TheComet/bat6/README.md

BAT6
========
FHNW Projekt 3 (Freivogel, Frey, Murray)
