TheComet/bat6/mechanical/housing/images/faceplate.tex

\documentclass{standalone}
\usepackage{tikz}
\usepackage{graphicx}

\begin{document}

\end{document}
