TheComet/bat6/pm/meeting-15-22-23.md

Topics
======
 + Mathematical model
    - Include temperature. It doesn't introduce any more complexity.
      --> Reto: Run tests, see if possible.
    - Model cell arrays (series + parallel) and not just a single cell
      --> Ask coaches about this, how useful is it?
    - Use actual parameters from real manufacturers?
      --> 
    - Dynamically allocate cells on micro controller
 + Frontend
    - Convert array of points
    - Be able to model cell arrays
    - Plotting of the resulting kennlinie
    - Power calculations + plots
    - Upload model to hardware and store it there? --> EEPROM?
