TheComet/bat6/doc/presentation/main.tex

\documentclass{beamer}
%\usepackage[ngerman]{babel}
%\usetheme[background=dark]{m}                     % Use metropolis theme
%\usetheme{theme/beamerthemem}                     % Use metropolis theme
\usetheme{m}                     % Use metropolis theme

\title{BAT6}
\date{\today}
\author{Alexander Murray, Reto Freivogel, Raphael Frey}
\institute{FHNW Brugg-Windisch}

\begin{document}
  \maketitle

  \section{Basic Idea Behind BAT6}

  \begin{frame}{Why We Want BAT6}
      \begin{itemize}
          \item
              It's awesome!
          \item
              BAT5 is just not good enough.
      \end{itemize}
  \end{frame}

  \begin{frame}{Advantages of BAT6}
      \begin{itemize}
          \item
              Optimized gliding parameters compared to BAT5
          \item
              Ease of use
      \end{itemize}
  \end{frame}
\end{document}
