TheComet/bat6/doc/documentation/titlepage/titlepage.tex

\begin{titlepage}

    \maketitle
    \vspace{40mm}
    \begin{center}
        \Large{Solar Panel Emulator}%
    \end{center}

    \vspace{50mm}
    %\vspace{90mm}

    %\hspace{-20mm}
    \begin{tabular}{r|l}

        \textsc{\textbf{Degree Program}}
        & EIT\\
        [4mm]

        \textsc{\textbf{Module}}
        & Projekt 3 \\
        [4mm]

        \textsc{\textbf{Team}}
        & 2 \\
        [4mm]

        \textsc{\textbf{Sponsor}}
        & Hanspeter Gysin \\
        [4mm]

        \textsc{\textbf{Coaches}}
        & Hanspeter Gysin, Peter Ganzmann, Matthias Meier,\\
        & Anita Gertiser, Bonnie Domenghino\\
        [4mm]

        %\textsc{\textbf{A}}
        %& Reto Freivogel, Alexander Murray, Raphael Frey\\
        %[4mm]

        \textsc{\textbf{Version}}
        & \code{1} \\
    \end{tabular}
    %\end{center}

\end{titlepage}
