TheComet/bat6/pm/reality-check/reality-check.odp

## Our Anuses are about to get fucked

## Reality Check

- Regulator is fucked
- Implementation of PV model seems to be nowhere
  - Driver exists but cannot be tested
  - API not implemented at all
- Front-End still nowhere
- UART still nowhere
- No menu
- LCD driver still nowhere
- Housing incomplete
- Documentation in chaos
- Presentation not even started yet
- No sign of anything remotely related to verification
- Project management has generally been terrible and chaotic

## Dependencies

HW Regulator

HW Regulator

OLED Driver

Buck Driver

Buck Driver

Menu

PV Model

PV Model

Test/Verification

UART

Front-End

Presentation

Documentation

## Option 1 Fix Buck

## Option 2 Make it presentable

- No idea what the problem is, we only have hunches
- Takes 2 weeks
- Hope it works.
- If it doesn't, we'll be back where we are now
- Focus on what we know works
- Make a working menu
- Make a working Front-End
- Focus on documentation and why our regulator failed.
- Focus on a good presentation

## Why are we where we are now?

- Little to no communication between group members
- Insufficient leadership
- No roadmap
- Lack of motivation
- Lack of invested time into the project
- Irrelevant “Wunschziele”

## Individual Feedback

## We need a roadmap

OLED Driver

Documentation

UART

Menu

Presentation

Front-End

Test/Verification
