TheComet/bat6/pm/pflichtenheft/grob-blockdiagramm.odp

Banana Plugs

Polarity Protection

(6A05-T)

230V Input

USB micro B

JTAG

~700mA

Fuse

FT232RQ

UVLO

< 25V

On/Off

Switch

Isolator

1.5V

Vref

Filters

Isolated

Converter

36V

dsPIC33F

Buck

(LT3741)

Diff. Current

Measurement

Voltage

Measurement

Buck

5V

Linear

3.3V

LCD

Display

LEDs

Push/Twist

Button
