TheComet/bat6/doc/presentation/libreoffice/presentation.odp

## BAT6

## Welcome Raphael Frey

## Model and Regulation Reto Freivogel

## Our Model (Temperature)

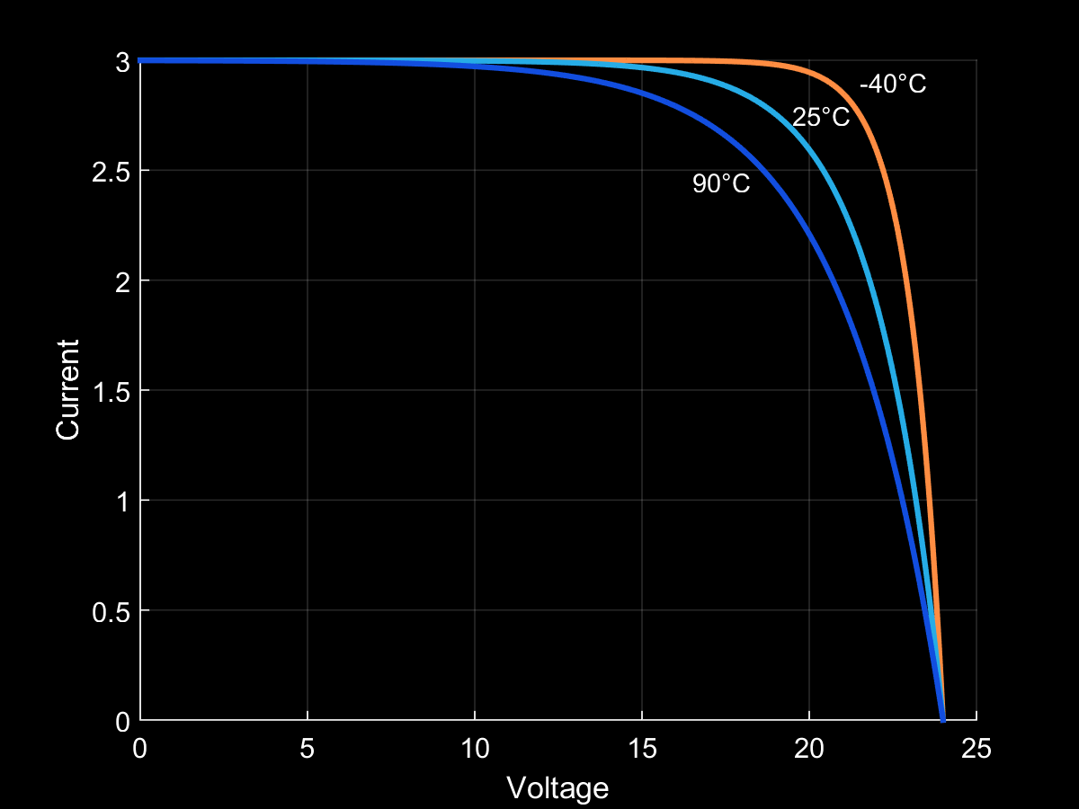
[picture p11: figure]
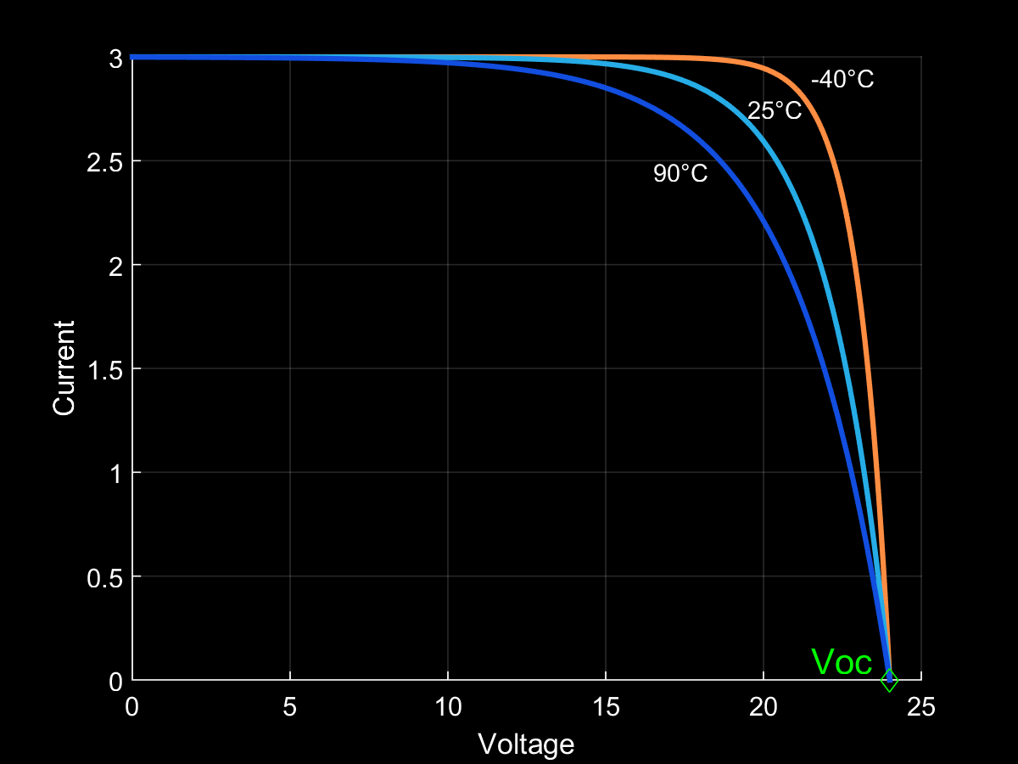
[picture p12: figure]
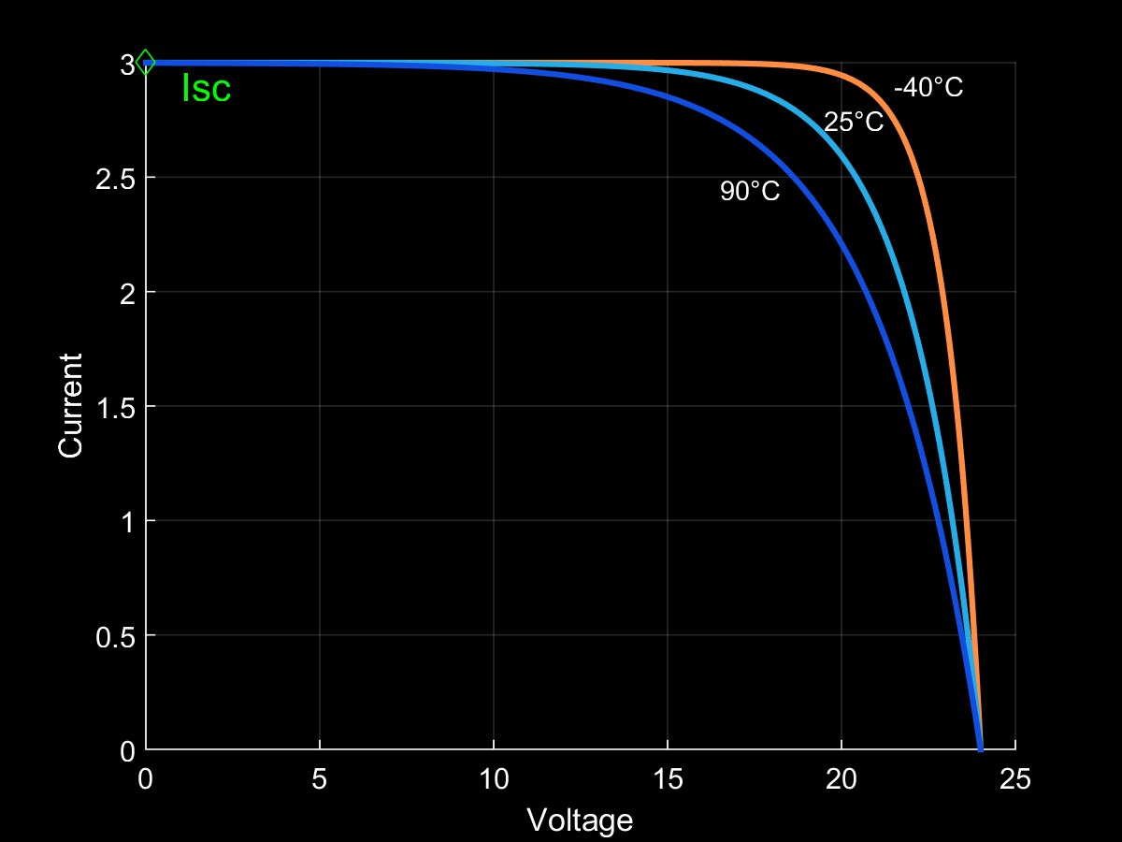
[picture p13: figure]

## Our Model (Irradiation)

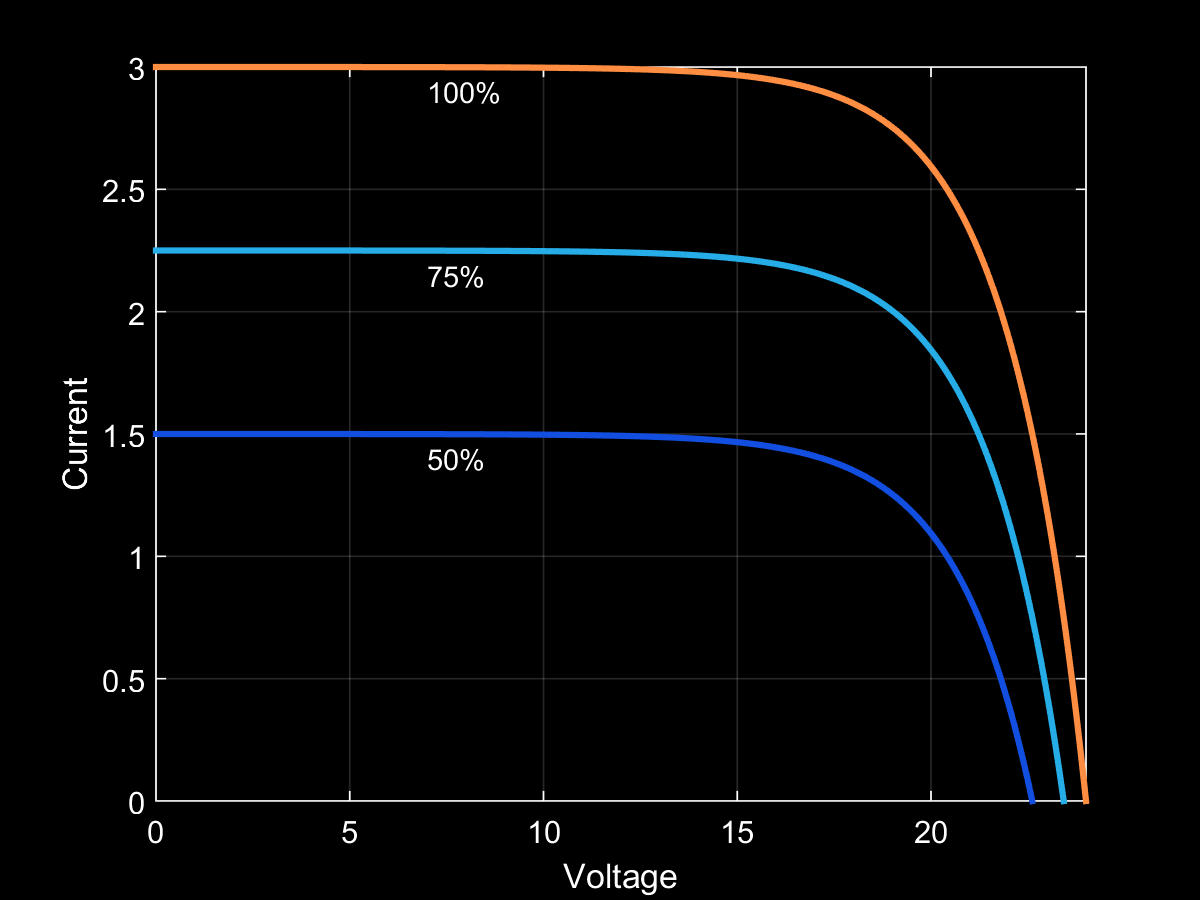
[picture p14: figure]

## Regulation Algorithm

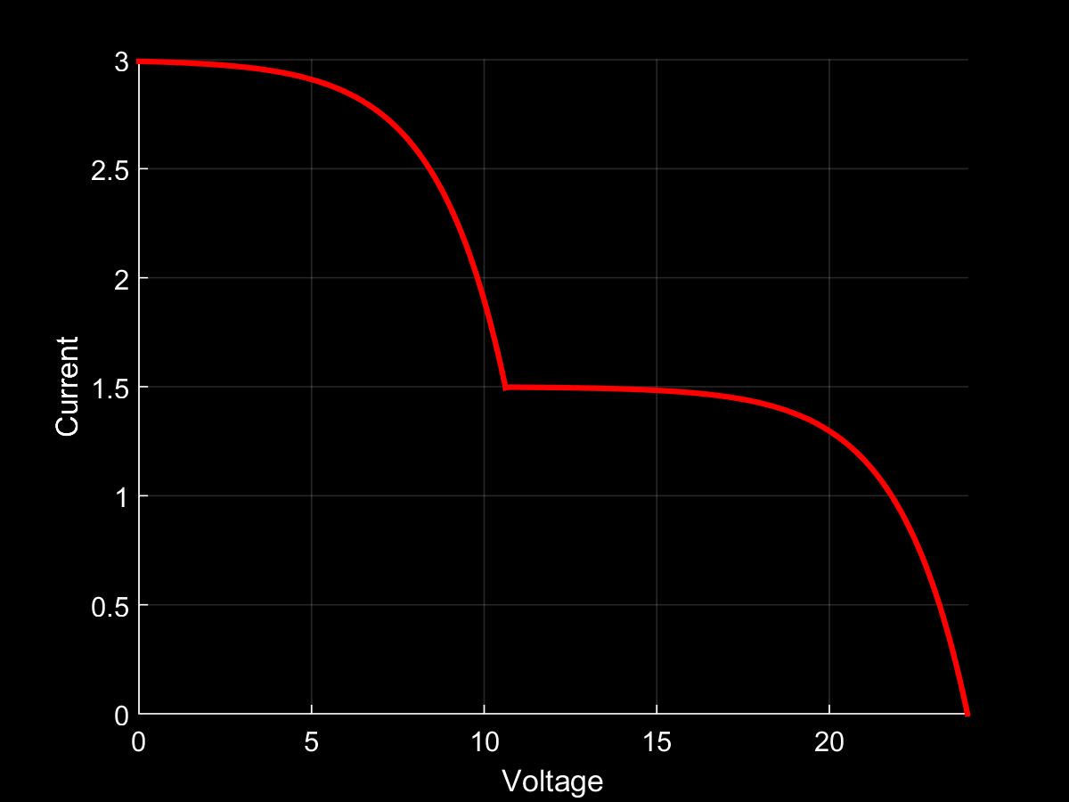
[picture p15: figure]
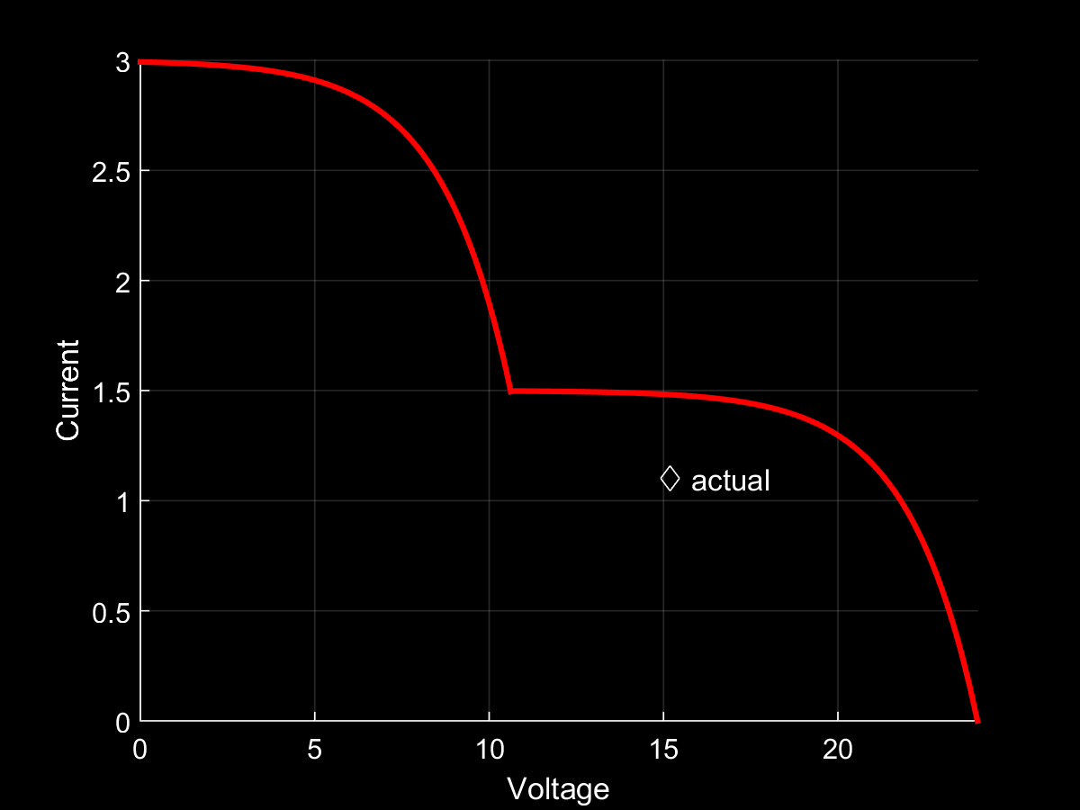
[picture p16: figure]
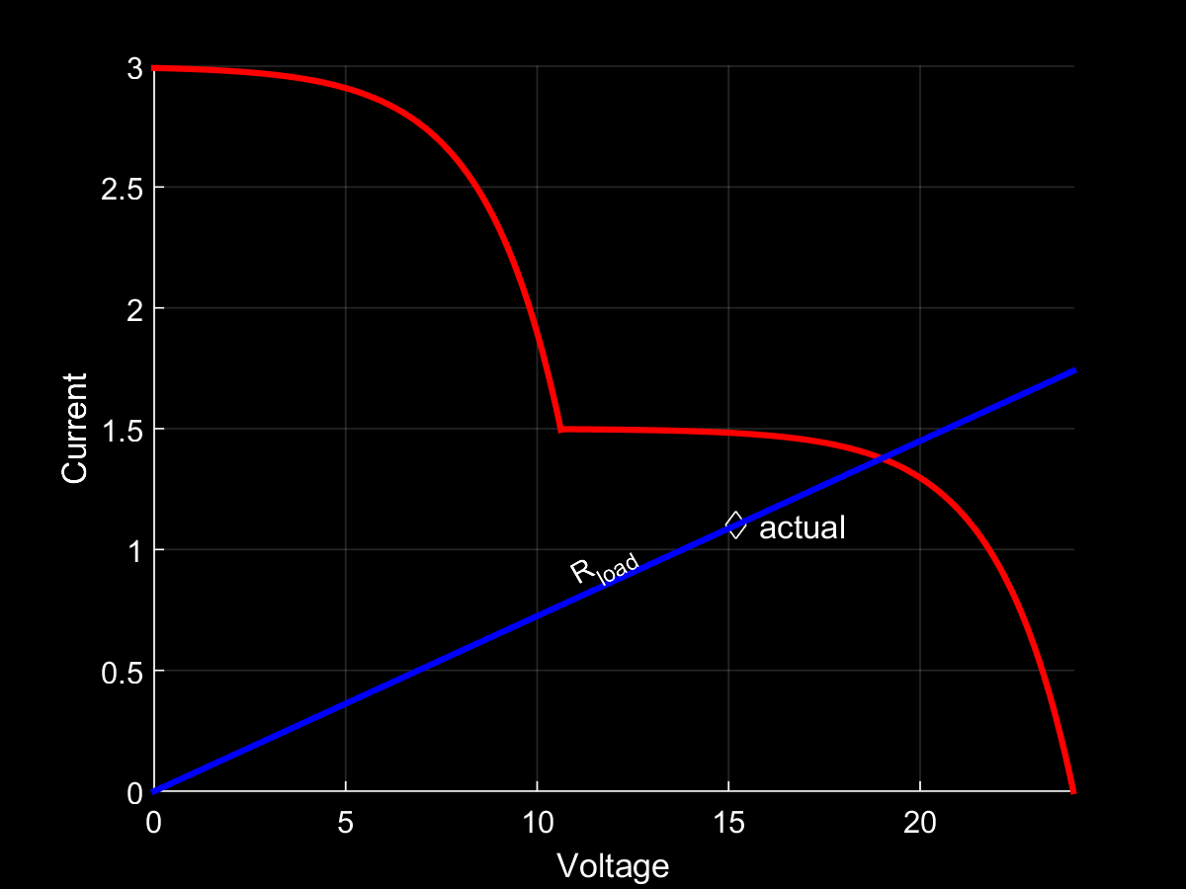
[picture p17: figure]
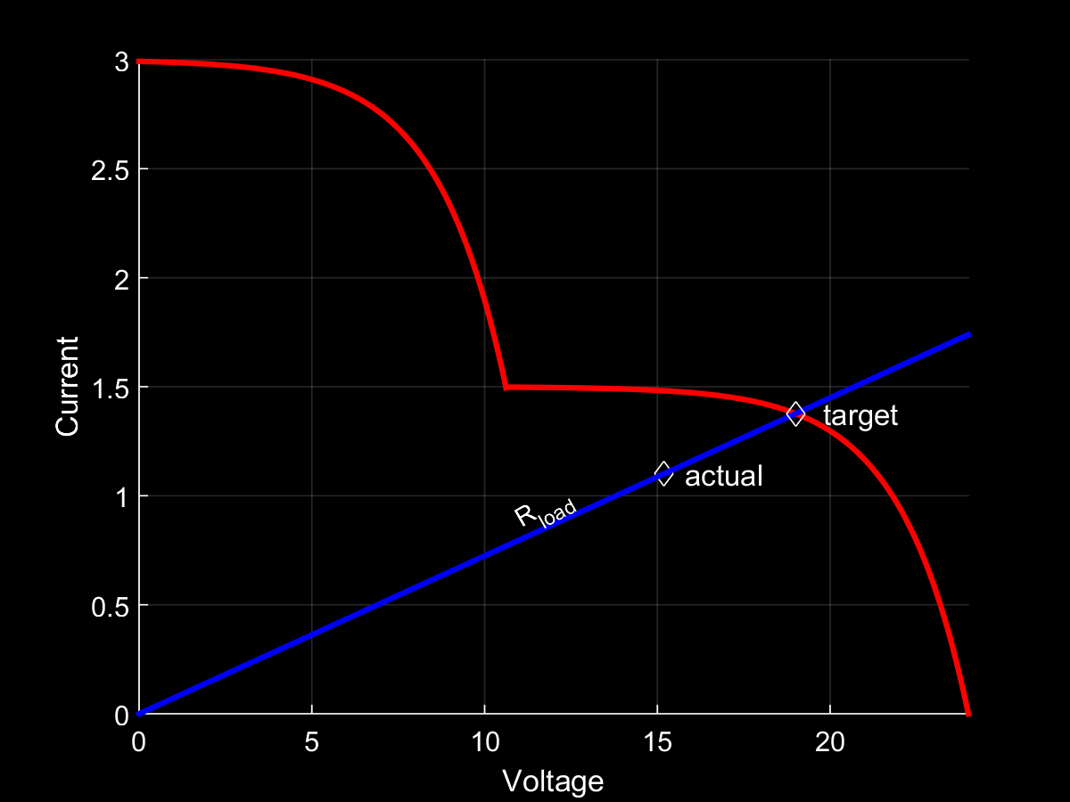
[picture p18: figure]

## Hardware Implementation

Set Voltage

Measure Current

Set Current

Measure Voltage

1.5V

Vref

dsPIC33

DAC

ADC

ADC

DAC

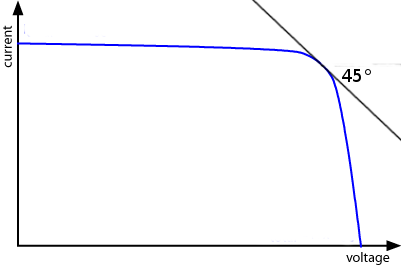
[picture p19: figure]
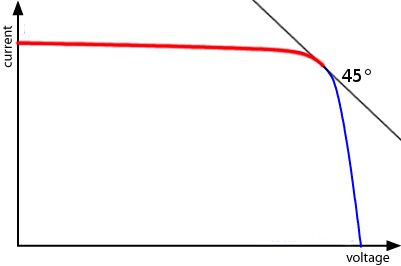
[picture p20: figure]
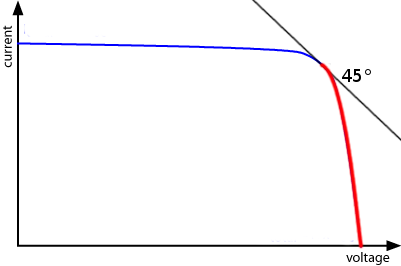
[picture p21: figure]

Buck

(LT3741)

Notes: → the main parts of the regulation → Measure V + I at all times → If we take a look at a typical IV curve we see there is a part where the voltage is relatively constant → Operate in constant voltage mode → or constant current → to improve accuracy

## Hardware Alex Murray

## Full Use of Today's Technologies

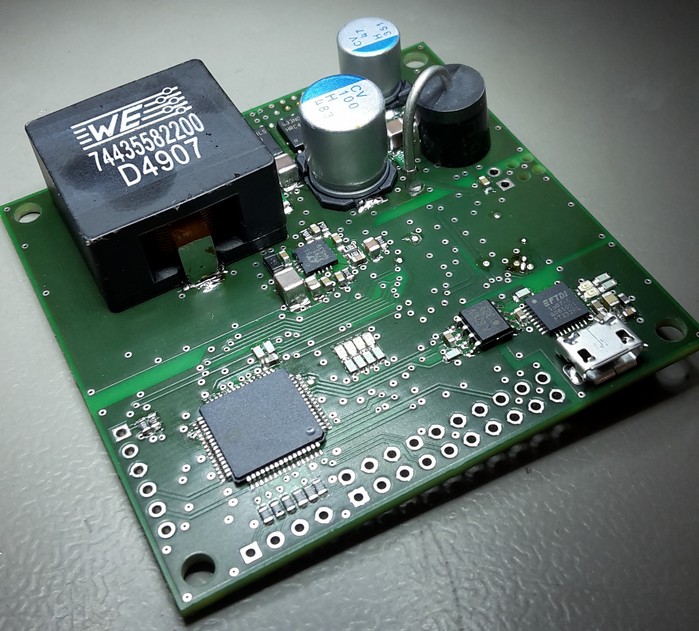
[picture p22: figure]
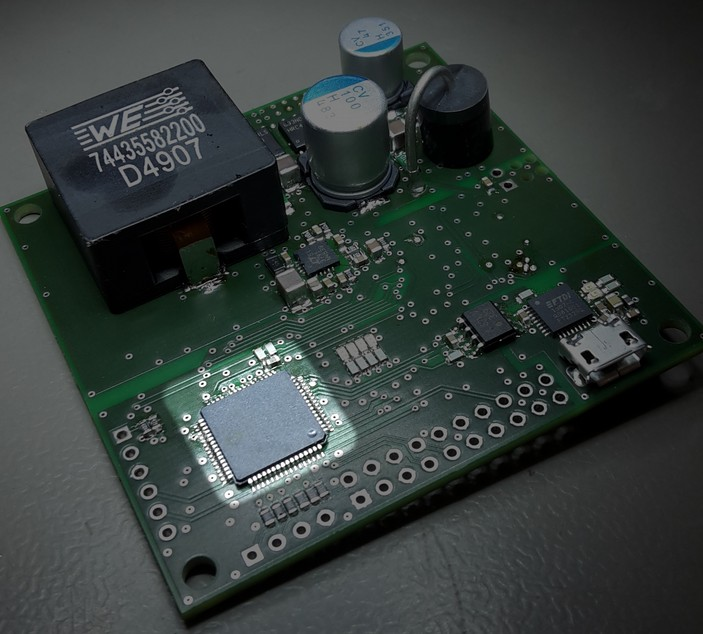
[picture p23: figure]
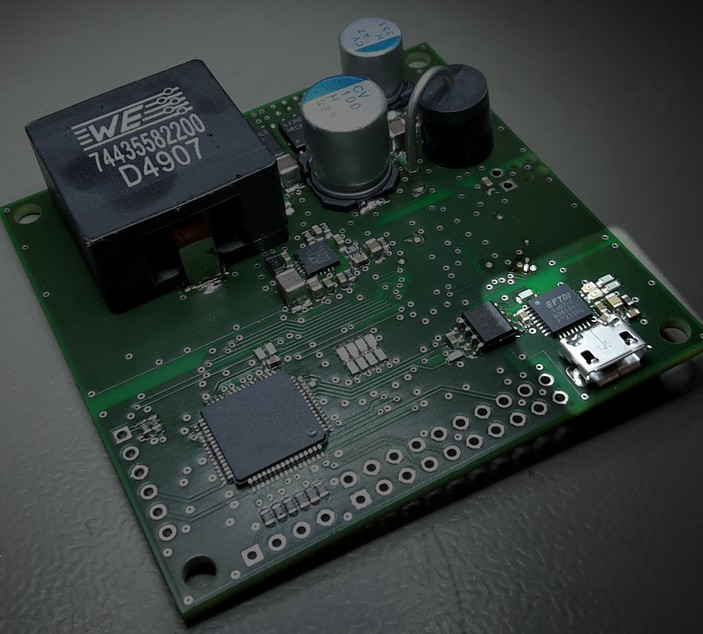
[picture p24: figure]
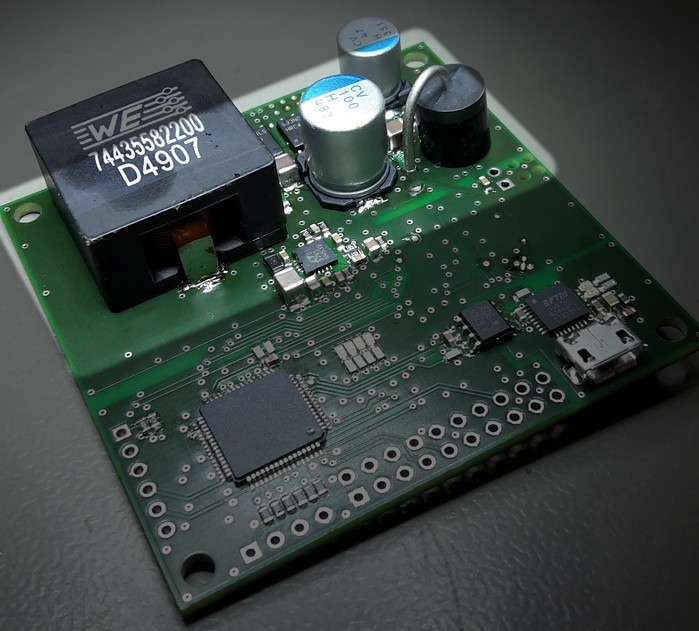
[picture p25: figure]
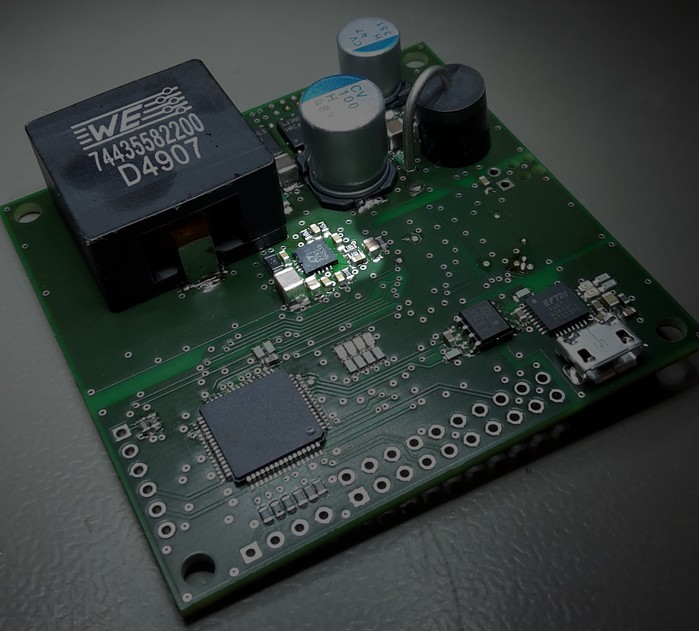
[picture p26: figure]

Notes: → Full use of modern fabrication technologies → As close as possible to behaviour of a possibly mass produced product → SMD, tiny ICs, QFN → Fabricated PCB → Reflow soldering to manufacture → (explain shit) → Unfortunately,

## The Issue

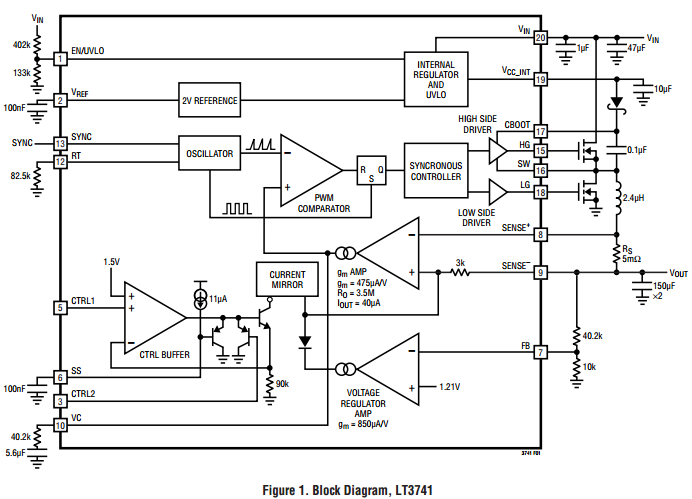
[picture p27: figure]
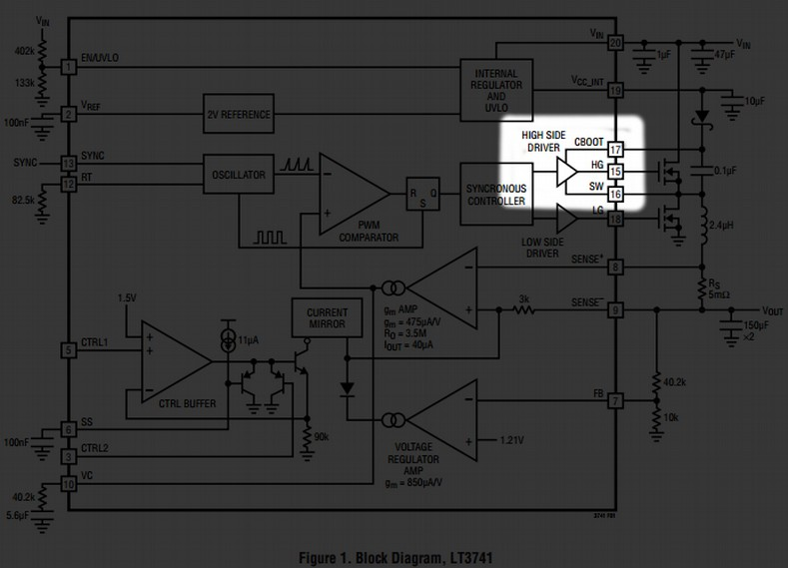
[picture p28: figure]

- MOSFETs are fine
- Inductor is fine
- No significant heat dissipation
- Transients?

Notes: → This is a block diagram of… → After lots of analysing and measuring… → concluded high side driver broken → This happened twice → replaced regulator, reduced voltage, same thing → (next slide)

## Trace Lengths Are Fairly Long

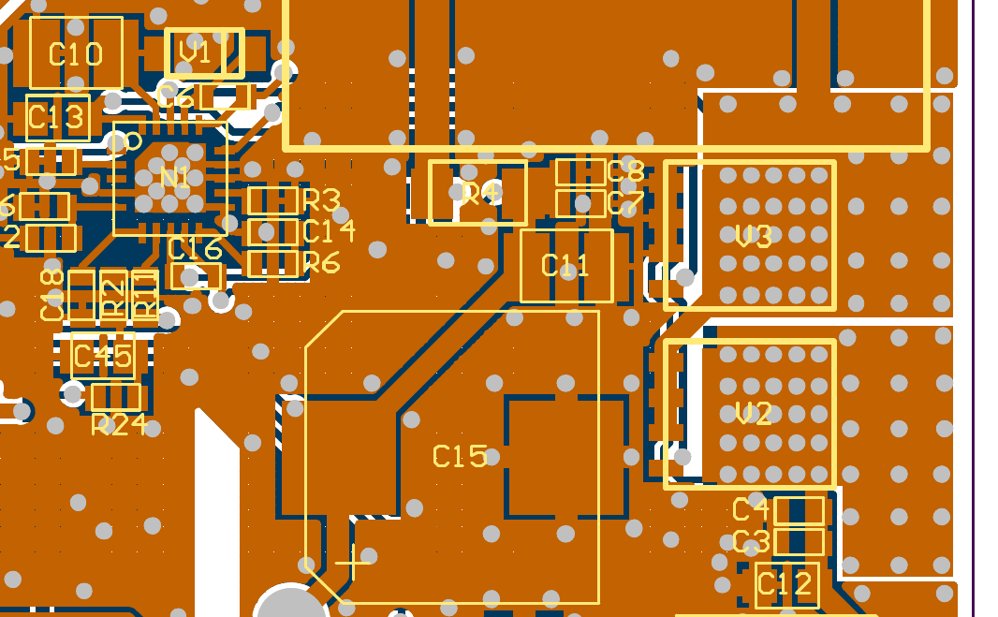
[picture p29: figure]
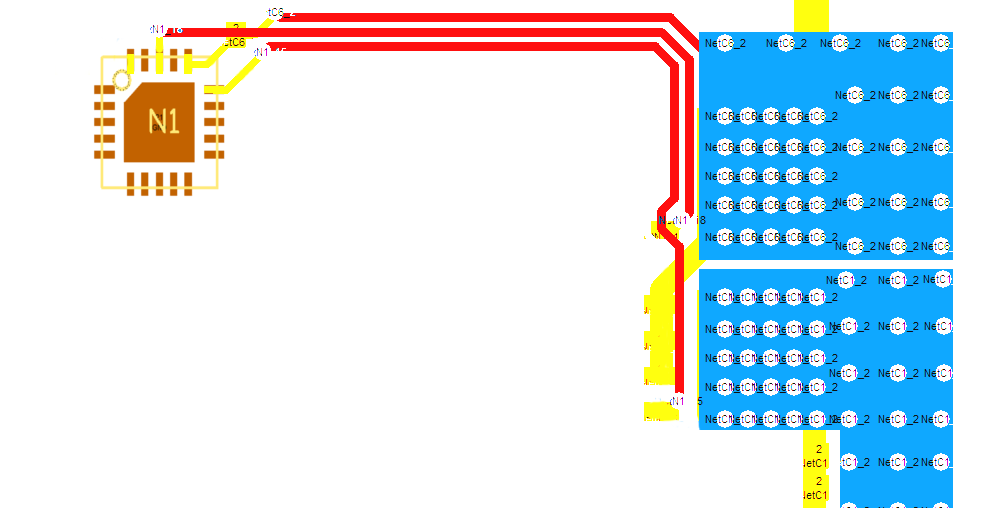
[picture p30: figure]

Resistors

>2cm

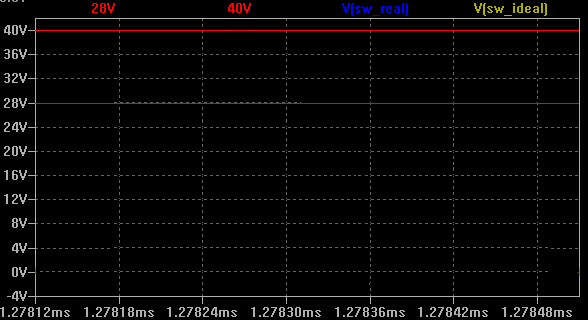
[picture p31: figure]
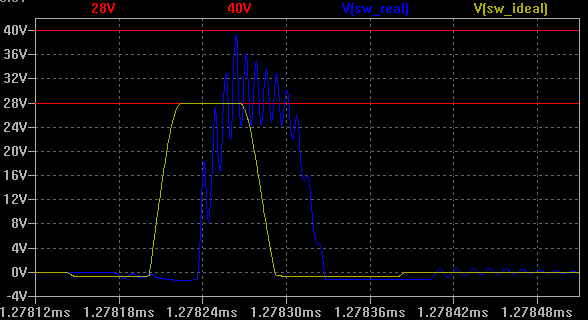
[picture p32: figure]
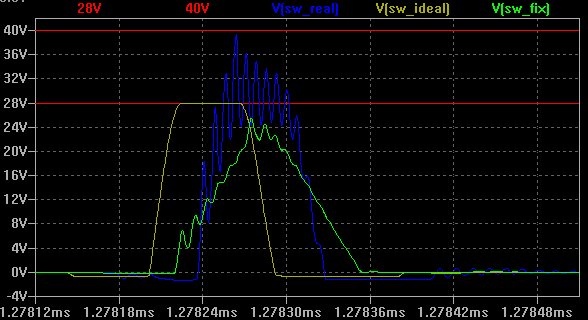
[picture p33: figure]
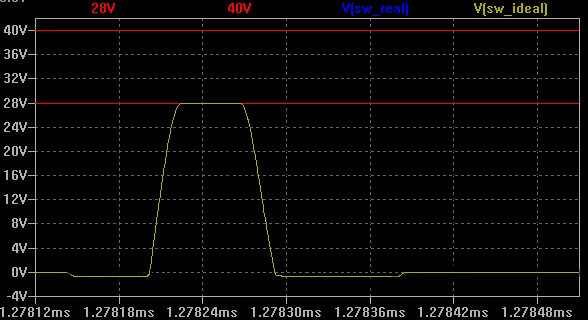
[picture p34: figure]

actual

Absolute Maximum

Expected Maximum

Ideal

With resistors

Notes: → View of our printed circuit board → If we take a look at traces… → Inductance of traces isn't considered in simulation → Traces can be modelled & simulated → This is what we get when we do that → 40V/28V red lines → Yellow = ideal → Blue = simulation with traces → Ringing, transients overshooting by 12V → How do we fix? → Resistors in series (3.3 Ohm)

## Solutions

- Series Resistors
- Place LT3741 closer to MOSFETs

Minimise

Distance

Notes: Second Iteration of the design → Decrease distance between regulator and MOSFETs

## Demonstration Raphael Frey

## Summary

- Most of it works
- Fix problems
- Test/Verify functionality

## Questions?

Project Repository

Gource Time-lapse

github.com/thecomet93/bat6

http://tinyurl.com/fhbat6

## Thank You!

## (Intentionally Left Blank)

## Threshold

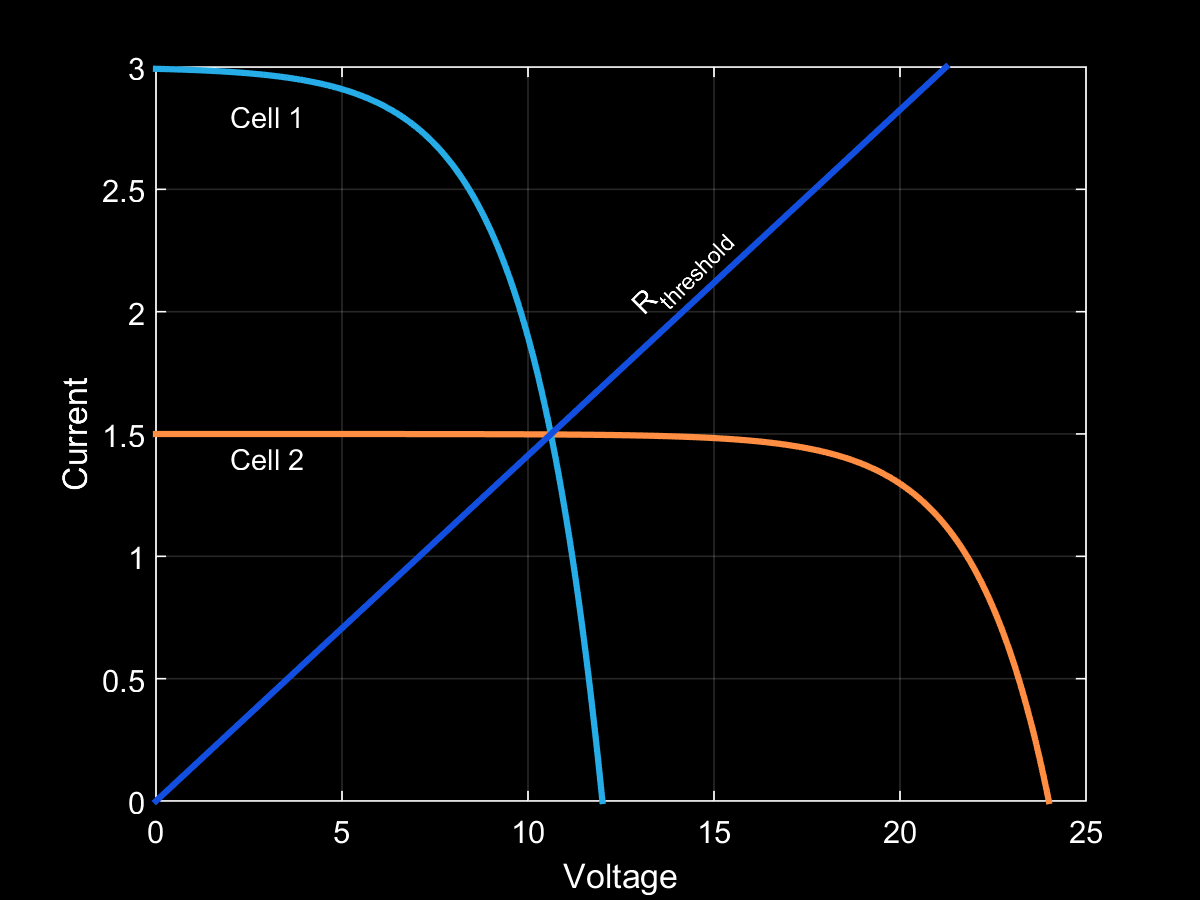
[picture p35: figure]

## Schematic: Regulator

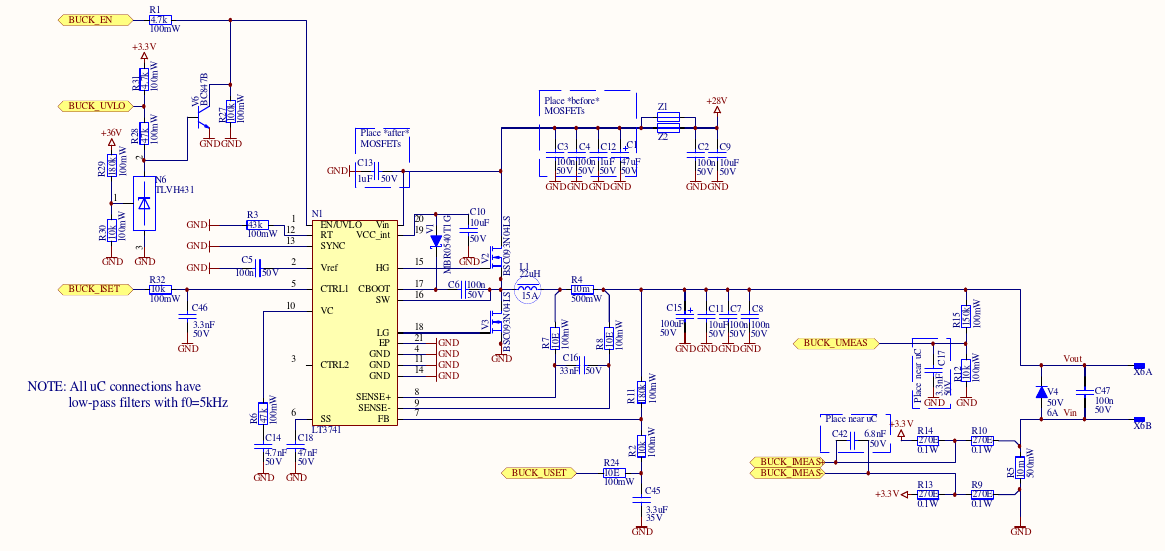
[picture p36: figure]
