TheComet/bat6/doc/state-machine/state-machine.pdf

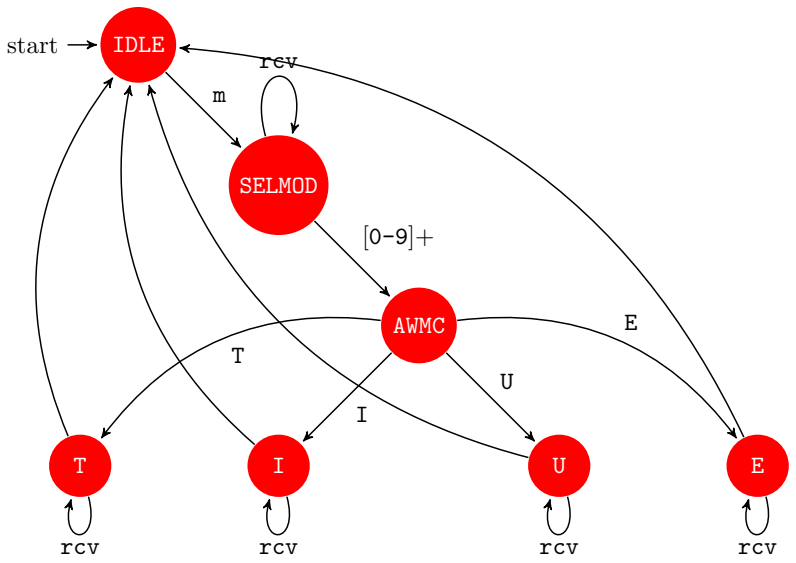
[picture p55: figure]
start; IDLE; SELMOD; AWMC; rcv

IDLE Machine is idling

SELMOD Selecting a model by its number to configure it.

rcv Keep reading out input.

AWMC Awaiting model configuration (whether short circuit current, open loop voltage, temperature or exposure is to be confingured).

[0-9]* One or more digits, indicating the number of the selected model.

I Configuring short-circuit current.

U Configuring open-loop voltage.

T Configuring temperature.

E Configuring Exposure.

1
