TheComet/bat6/doc/documentation/images/sim/ripple-vs-load.pdf

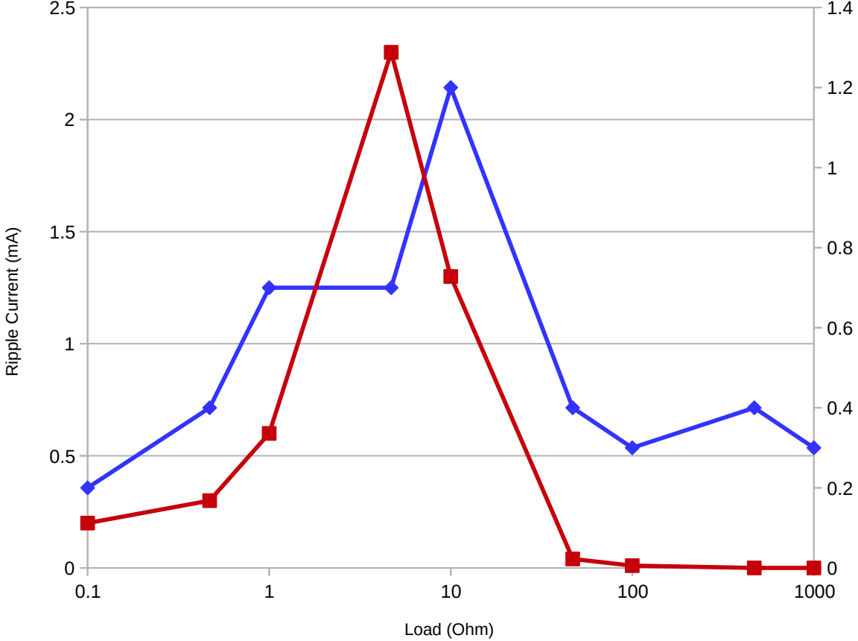
[picture p62: figure]
Load (Ohm); Ripple Current (mA)

Ripple Current (mA)
Ripple Voltage (mV)

Ripple Voltage (mV)
