TheComet/bat6/doc/documentation/images/circuit/buck-iset.pdf

CTRL1 5
BUCK_ISET | 10k 100mW

R32

3.3nF
50V

C46

GND
