TheComet/bat6/doc/documentation/images/circuit/buck-umeas.pdf

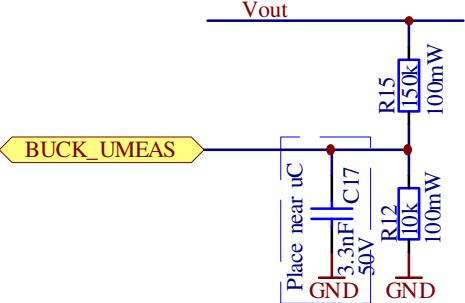
[picture p63: figure]
GND; BUCK_UMEAS; Place near uC; Vout
