TheComet/bat6/doc/documentation/images/circuit/buck-uset.pdf

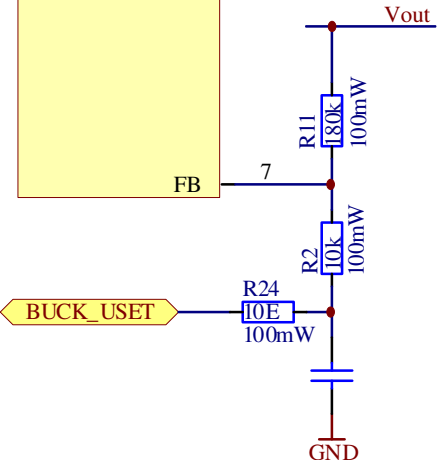
[picture p64: figure]
BUCK_USET; GND; Vout
