TheComet/bat6/doc/documentation/images/circuit/mains-input.pdf

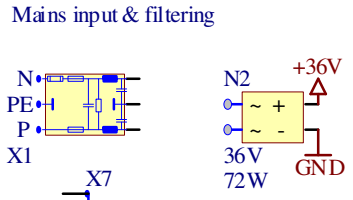
[picture p65: figure]
GND; Mains input & filtering

Rocker Switch
