TheComet/bat6/doc/documentation/images/circuit/pushbutton.pdf

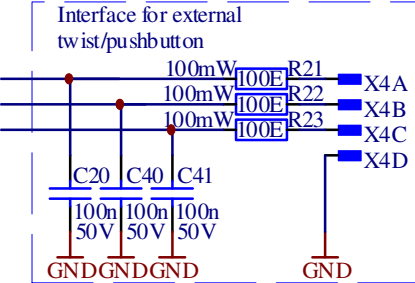
[picture p66: figure]
Interface for external twist/pushbutton; GNDGNDGND; GND
