TheComet/bat6/doc/documentation/images/circuit/vref.pdf

Vin | 1
GND | 3

Vref 2

1.5V 7mA

N5

+3.3V

GND

100n
50V

C33

GND

10n
50V

C35

GND

Ref for ADC
Buck operates between
0..1.5V
