TheComet/bat6/doc/documentation/sections/simulation.tex

\begin{itemize}
    \item
        Welche Aspekte des Projektes wurden simuliert?
    \item
        Weshalb?
    \item
        Wie?
    \item
        Was waren die Resultate?
\end{itemize}
