TheComet/bat6/doc/documentation/sections/task.tex

\begin{itemize}
    \item
        Was ist der grunds\"atzliche Auftrag?
    \item
        Was ist das Ziel?
    \item
        Motivation hinter dem Projekt/Auftrag?
    \item
        Grunds\"atzliche  Informationen  zu  Photovoltaik-Modulen und  den  zu
        untersuchenden  Fragen  (Verhalten  unter  nicht-idealen  Umst\"anden)
        liefern.
    \item
        Was sind die grunds\"atzlichen Anforderungen an unser Ger\"at?
\end{itemize}
