TheComet/bat6/doc/documentation/images/circuit/output-connectors.pdf

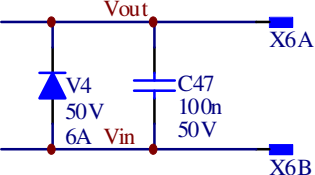
[picture p67: figure]
Vout; Vin
