TheComet/bat6/doc/documentation/images/circuit/rocker-switch.JPG

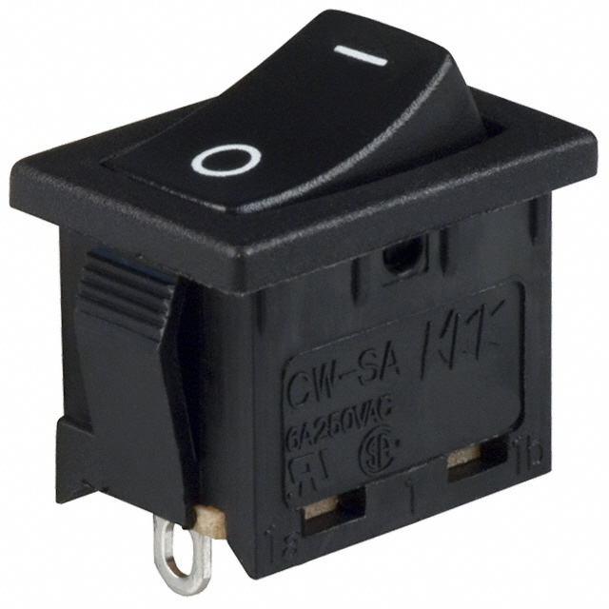
doc/documentation/images/circuit/rocker-switch.JPG
