TheComet/bat6/doc/documentation/images/pcb/buck2.png

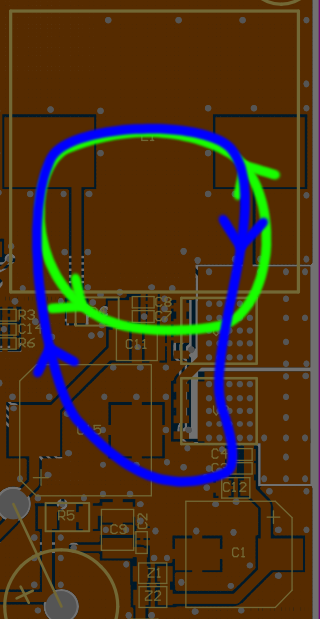
doc/documentation/images/pcb/buck2.png
