TheComet/bat6/doc/documentation/images/pcb/buck.png

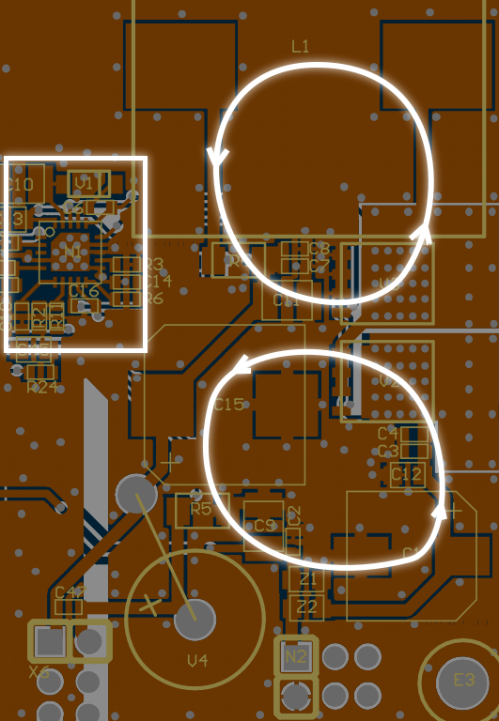
doc/documentation/images/pcb/buck.png
