TheComet/bat6/doc/documentation/images/pcb/differential-signals.png

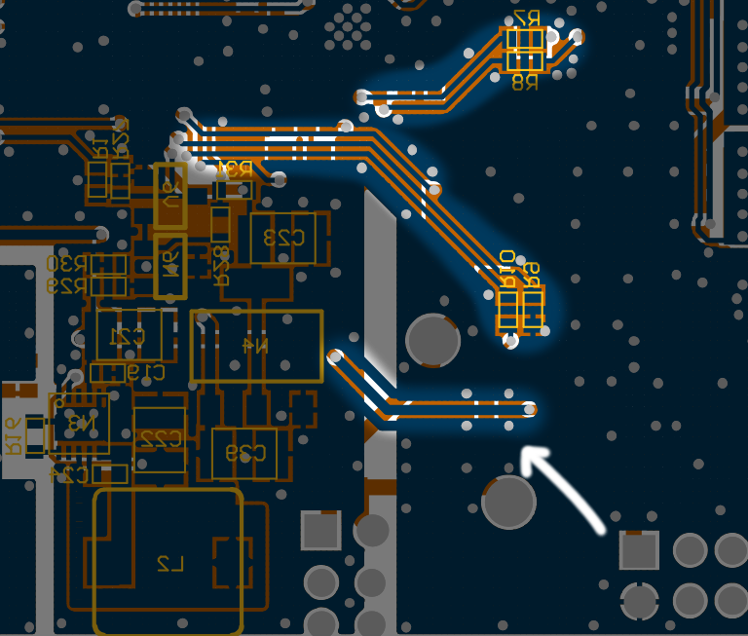
doc/documentation/images/pcb/differential-signals.png
