TheComet/bat6/doc/documentation/images/pcb/mosfets.png

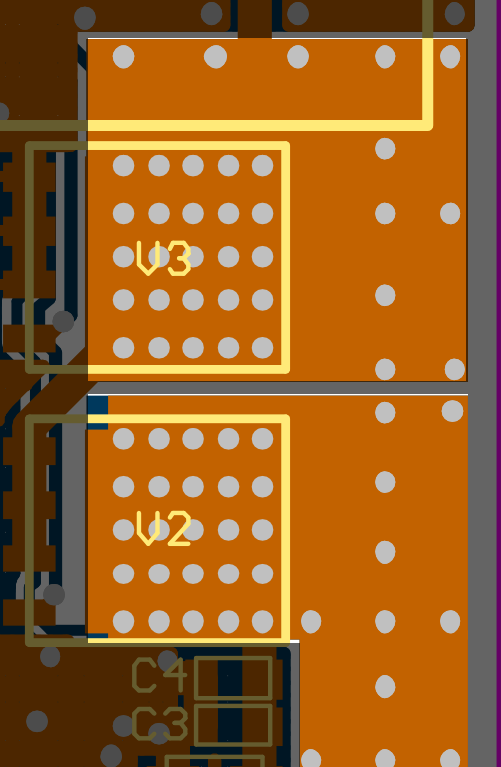
doc/documentation/images/pcb/mosfets.png
