TheComet/bat6/doc/documentation/images/pcb/top.png

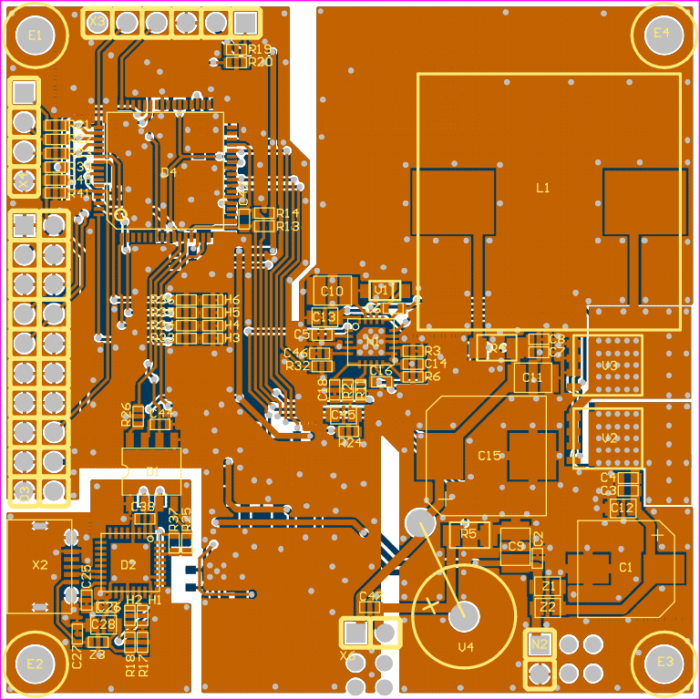
doc/documentation/images/pcb/top.png
