TheComet/bat6/doc/pcb-day-1/20151124_124543.jpg

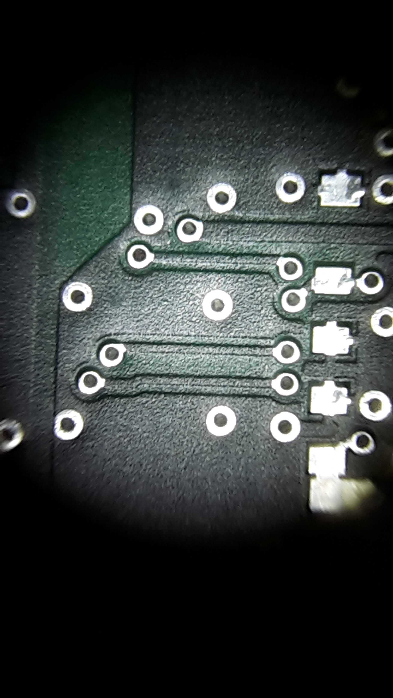
doc/pcb-day-1/20151124_124543.jpg
