TheComet/bat6/doc/pcb-day-1/20151124_132651.jpg

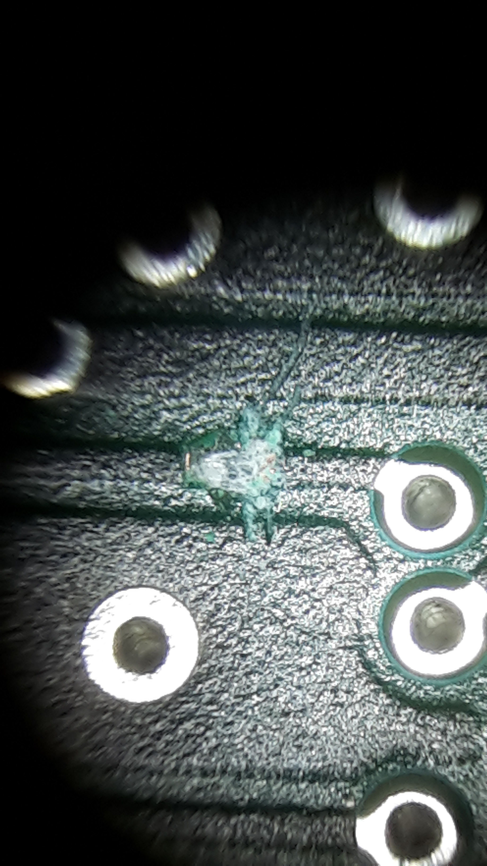
doc/pcb-day-1/20151124_132651.jpg
