TheComet/bat6/doc/pcb-day-1/20151124_135229.jpg

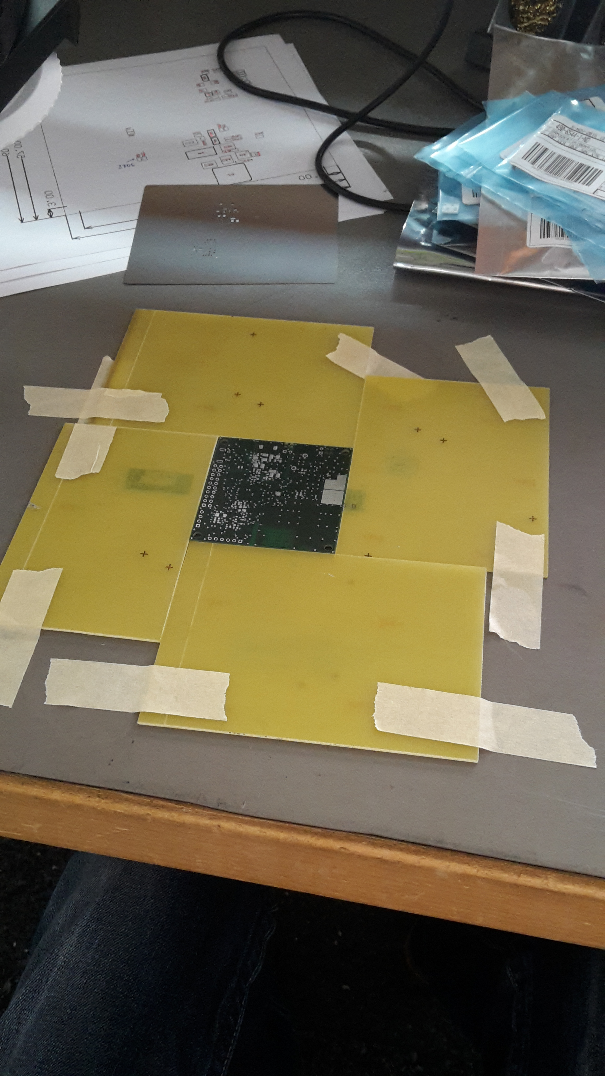
doc/pcb-day-1/20151124_135229.jpg
