TheComet/bat6/doc/pcb-day-1/20151124_135528.jpg

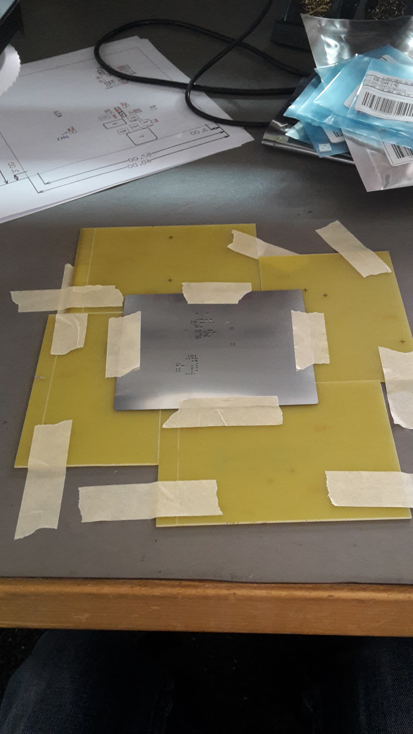
doc/pcb-day-1/20151124_135528.jpg
