TheComet/bat6/doc/pcb-day-1/20151124_135534.jpg

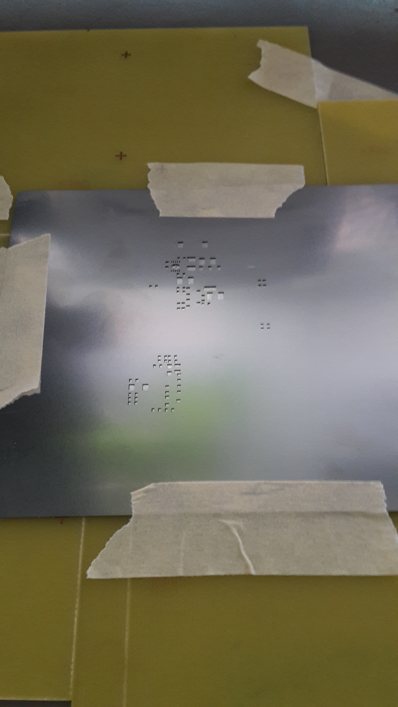
doc/pcb-day-1/20151124_135534.jpg
