TheComet/bat6/doc/pcb-day-1/20151124_145220.jpg

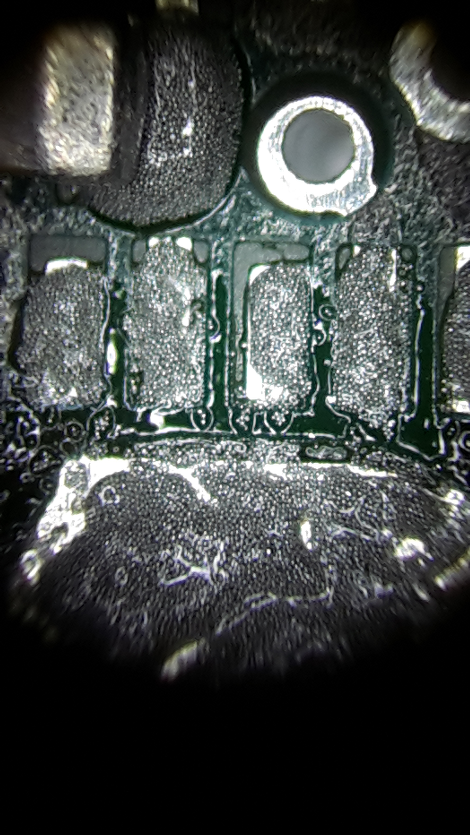
doc/pcb-day-1/20151124_145220.jpg
