TheComet/bat6/doc/pcb-day-1/IMG-20151124-WA0024.jpg

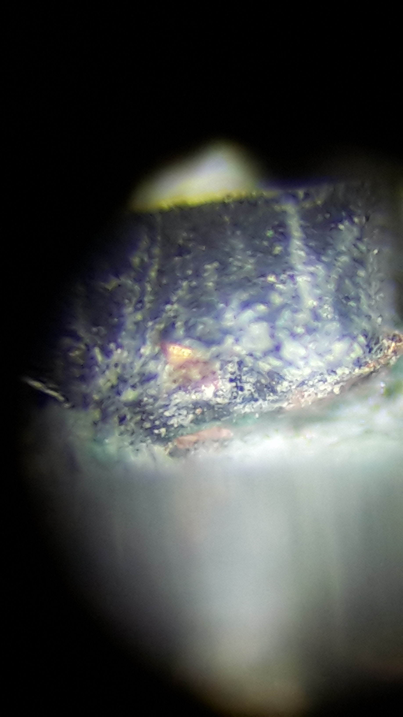
doc/pcb-day-1/IMG-20151124-WA0024.jpg
