TheComet/bat6/doc/presentation/images/lt3741_transients_circuit.png

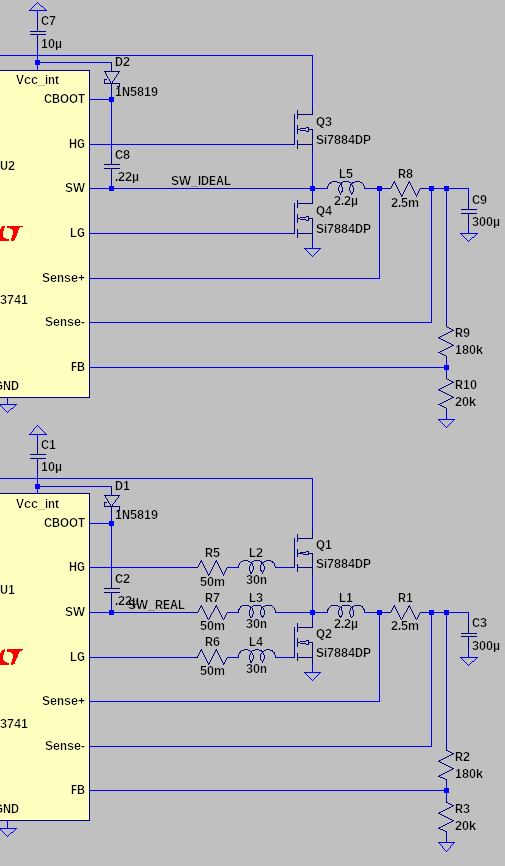
doc/presentation/images/lt3741_transients_circuit.png
