TheComet/bat6/doc/presentation/images/lt3742_transients_plot1.png

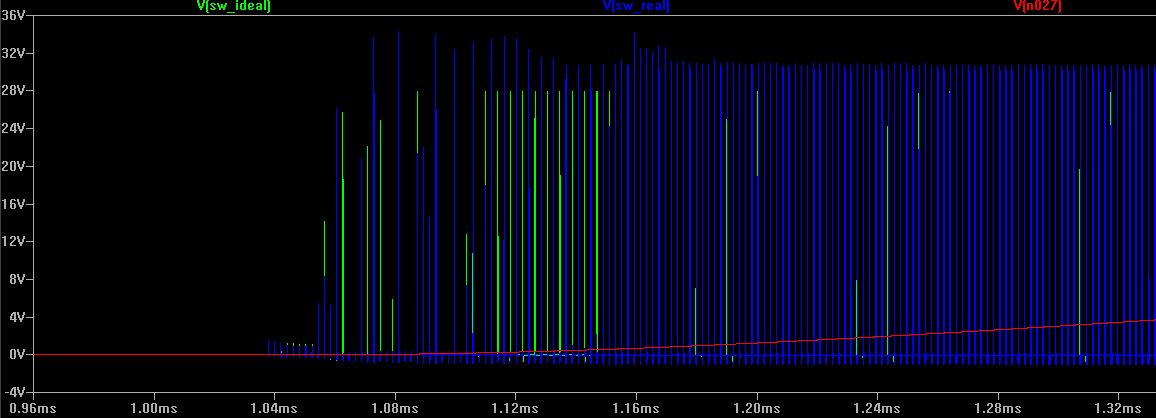
doc/presentation/images/lt3742_transients_plot1.png
