TheComet/bat6/hardware/pcb/layers/BDE5641d5ff81826_05_seite1.jpg

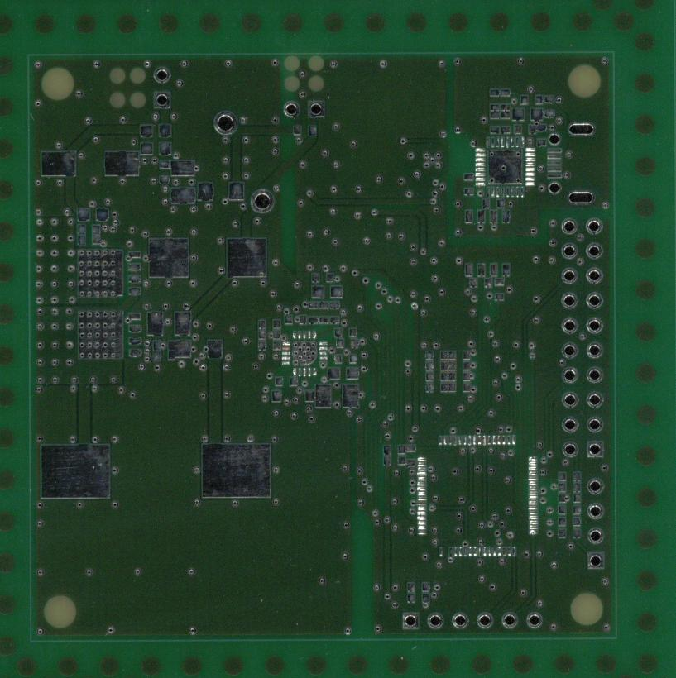
hardware/pcb/layers/BDE5641d5ff81826_05_seite1.jpg
