TheComet/bat6/hardware/pcb/layers/BDE5641d5ff81826_05_seite2.jpg

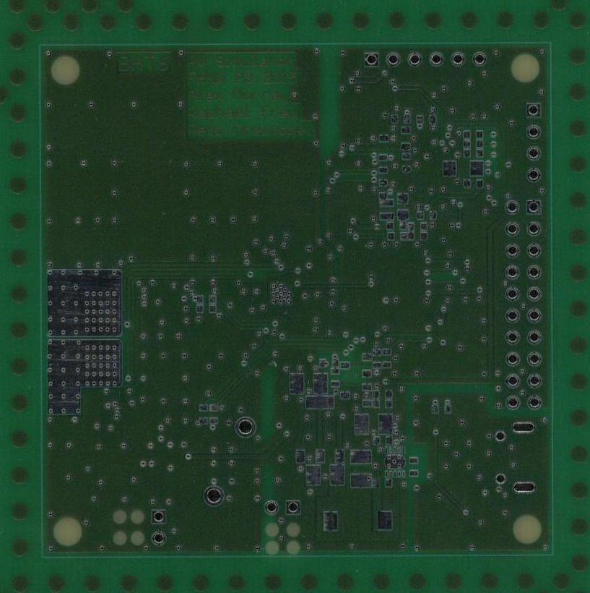
hardware/pcb/layers/BDE5641d5ff81826_05_seite2.jpg
