TheComet/bat6/pm/pflichtenheft/grob-blockdiagramm.png

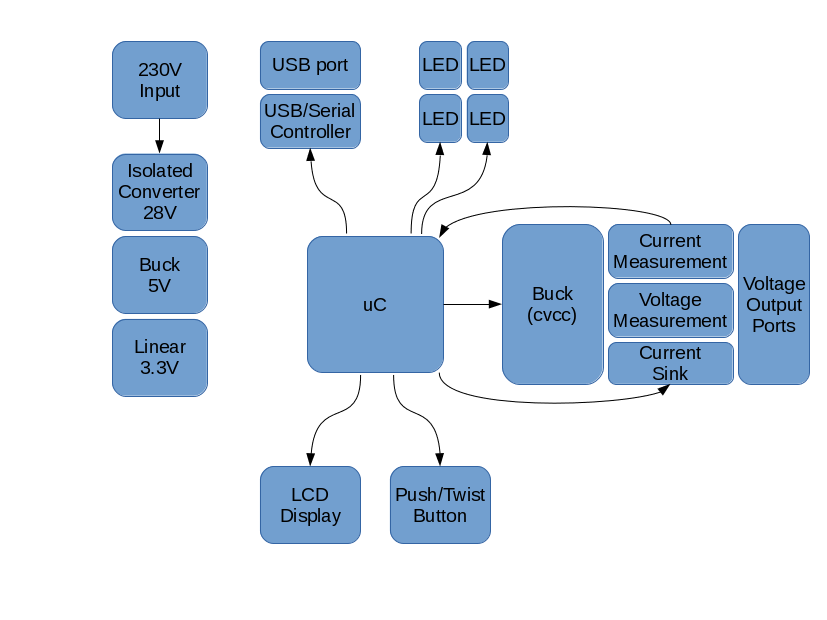
pm/pflichtenheft/grob-blockdiagramm.png
