TheComet/bat6/hardware/pcb/order-info.txt

+-------------------------------------------------------------+
|                     Ordering Information                    |
|                          PCB-Pool                           |
+-----------------------+-------------------------------------+
| Layers                |                                     |
|    Technology         | Rigid printed circuit board         |
|    Layer Count        | 2                                   |
+-----------------------+-------------------------------------+
| Quantity              | 1                                   |
+-----------------------+-------------------------------------+
| Dimensions            | 60 mm x 60 mm                       |
+-----------------------+-------------------------------------+
| Base material         | FR4, 35 µm Cu, 1,6 mm               |
+-----------------------+-------------------------------------+
| Soldermask            | Yes                                 |
+-----------------------+-------------------------------------+
| Silkscreen            | No                                  |
+-----------------------+-------------------------------------+
| Surface               | HAL                                 |
+-----------------------+-------------------------------------+
| Layout Specifications |                                     |
|    Min. Track/Gap     | >= 0.150 mm                         |
|    Min drill diameter | >= 0.3 mm                           |
+-----------------------+-------------------------------------+
| Overdelivery          | Yes                                 |
+-----------------------+-------------------------------------+
| Magic PCB             | No                                  |
+-----------------------+-------------------------------------+
| E-Test                | No                                  |
+-----------------------+-------------------------------------+
| Delivery time         | 8 WD                                |
+-----------------------+-------------------------------------+
| File format           | Altium (PROTEL)                     |
+-----------------------+-------------------------------------+
| Free Stencil          | Yes                                 |
+-----------------------+-------------------------------------+
| Assembly              | No                                  |
+-----------------------+-------------------------------------+
