TheComet/bat6/doc/documentation/sections/components/lt3741.tex

\emph{Note:} The schematic  for the  LT3471's circuit  is located  in appendix
\ref{appendix:lt3741:circuit} on page \pageref{appendix:lt3741:circuit}. It is
intended  to be  folded out  while reading  this section  of the  report. This
allows for convenient cross-referencing between  the circuit schematic and the
text without needing to insert multiple  copies of the schematic or constantly
scrolling back and forth through the report.

The most important reasons we chose  the LT3741 to regulate the output voltage
are as follows:

\begin{itemize}
    \item \textbf{Proven Technologies.}
        Switch-mode  regulators have  been around  for decades  and have  been
        perfected by many engineers.
    \item \textbf{Voltage and current requirements.}
        The device is specified to output voltage levels between \SI{0}{\volt}
        and  \SI{24}{\volt} and  current  levels  between \SI{0}{\ampere}  and
        \SI{3.5}{\ampere}.   Further, the  ripple voltage  is specified  to be
        $\le\SI{300}{\milli\volt}$  and the  ripple  current  is specified  to
        be  $\le\SI{100}{\milli\ampere}$. The  LT3741  fulfills all  of  these
        requirements.
    \item \textbf{The importance of power absorption.}
        Most switch-mode regulators are only  able to \emph{supply} power, but
        are  incapable of  \emph{absorbing} power. Because  our device  may be
        connected in series  (or parallel) with other power  supplies, it must
        have  the ability  to absorb  power  (which is  the case  if, it  were
        connected to a  voltage source outputting a higher  voltage level than
        our own).
    \item \textbf{Control inputs.}
        The LT3741  has dedicated  input control pins  to change  directly the
        output  current. This simplifies  the  design  because no  complicated
        additional circuitry is required.
\end{itemize}

%\begin{figure}[th!]
%    \center
%    \includegraphics[width=.67\textwidth]{images/circuit/buck.pdf}
%    %\caption{Herzst\"uck des Projektes: Aufbau des LT3741 CVCC Synchronwandler}
%    \caption{The device's heart: Overview over circuit for the LT3741 CCVC synchronous converter.}
%    \label{fig:circuit:buck}
%\end{figure}

Figure \ref{fig:circuit:buck} on the fold-out (see \emph{Note} above) presents
an overview  for the LT3741's  circuit, parts of  which are discussed  in more
detail in  the following paragraphs:  Bypass  capacitors, switching frequency,
inductors, MOSFETs and measuring output current and output voltage.

% **************************************************************************** %
\subsubsection{Bypass Capacitors}
% **************************************************************************** %

\input{sections/components/lt3741/bypass-caps.tex}

% **************************************************************************** %
\subsubsection{Switching Frequency}
% **************************************************************************** %

\input{sections/components/lt3741/switching-frequency.tex}

% **************************************************************************** %
\subsubsection{Inductor Selection}
\label{subsubsec:lt3741:inductors}
% **************************************************************************** %

\input{sections/components/lt3741/inductor.tex}

% **************************************************************************** %
\subsubsection{MOSFET Selection}
\label{subsubsec:lt3741:mosfets}
% **************************************************************************** %

\input{sections/components/lt3741/mosfet.tex}

% **************************************************************************** %
\subsubsection{Measurement of Output Voltage and Output Current}
\label{subsubsec:lt3741:feedback}
% **************************************************************************** %

\input{sections/components/lt3741/feedback.tex}

% **************************************************************************** %
\subsubsection{Output}
% **************************************************************************** %

\input{sections/components/lt3741/output.tex}

% **************************************************************************** %
\subsubsection{Enable and Under-Voltage Lockout circuit}
% **************************************************************************** %

\input{sections/components/lt3741/uvlo}
