TheComet/bat6/doc/documentation/sections/components/button.tex

\begin{figure}[th!]
    \center
    
    \caption{twist push button}
    \label{fig:circuit:pushbutton}
\end{figure}
