TheComet/bat6/doc/documentation/sections/components/drehtaster.tex

\begin{figure}[th!]
    \center
    
    \caption{Drehdruckknopf}
    \label{fig:circuit:pushbutton}
\end{figure}
