TheComet/bat6/doc/documentation/sections/components/lt3741/uvlo.tex

\begin{minipage}{0.5\textwidth}
    The  LT3741's  \emph{Enable}   input  is  enabled  and   disabled  by  the
    microcontroller's $BUCK\_EN$ signal  on one hand, on the other  hand it is
    can  be  forcibly  disabled  in  hardware  when  the  \SI{28}{\volt}  rail
    drops below  \SI{25}{\volt}. This allows for a  controlled and predictable
    behavior of  the LT3741  during power-on and  power-off. The corresponding
    circuit can be found in Figure \ref{fig:circuit:uvlo}.

    In  case of  under-voltage, $N_6$  switches  on and  the transistor  $V_6$
    starts to  conduct, thus  pulling the  \emph{Enable} input  to \emph{Low}.
    Voltage $BUCK\_UVLO$ triggers an interrupt in the microcontroller.
\end{minipage}
\begin{minipage}{0.5\textwidth}
    \center
    
    \captionof{figure}{Under-Voltage Lock-Out (UVLO) allows for controlled power-on and power-off of the controller}
    \label{fig:circuit:uvlo}
\end{minipage}
