TheComet/bat6/doc/smps-dimensionierung/LT3741-calculations.ods

R_S (current sense resistor for 0-5A output) | 0.01 | Ohm
I_O (Maximum output current) | 5 | A
V_IN (input voltage) | 36 | V
f_S (switching frequency) | 1000000 | Hz
L_min | 6 | uH
L_actual | 22 | uH
R_PS (RS power dissipation) | 0.25 | W
I_Max | 5.2045454545 | A
Inductor saturation current (min) | 6.2454545455 | A
R_PD | 1.3 | Ohm
R_PU | 2.3 | Ohm
Input Capacitance (min) | 20 | uF
Output capacitance (min) | 110 | uF
Cboot capacitance | 100-220 | nF
Vcc_int capacitance (min) | 5 | uF
Digikey | Price | MOSFET |  |  |  |  |  |  |  |  |  | LT3741
 |  | R_DS_ON | Q_GD | Q_GS | Q_G | R_G | V_GS_THR | rho_T @ 70°C | Ohmic loss | Transition loss | Total Loss | Drive Loss
917-EPC2029ENGRCT-ND | 10.28 | 0.0032 | 4 | 2.5 | 13 | 0.4 | 2.5 | 1.3 | 0.104 | 1.0296 | 1.1336 | 0.806
BSC039N06NSCT-ND | 1.53 | 0.0039 | 7 | 9 | 32 | 2.4 | 3.3 | 1.3 | 0.12675 | 4.8384 | 4.96515 | 1.984
BSZ042N06NSCT-ND | 1.58 | 0.0042 | 7 | 9 | 32 | 2.4 | 3.3 | 1.3 | 0.1365 | 4.8384 | 4.9749 | 1.984
NTMFS5C670NLT1GOSTR-ND | 1.09 | 0.008 | 2 | 4.5 | 9 | 3 | 2 | 1.3 | 0.26 | 2.2464 | 2.5064 | 0.558
497-10575-1-ND | 2.07 | 0.0067 | 5.3 | 3.9 | 12.9 | 1.5 | 1 | 1.3 | 0.21775 | 2.18592 | 2.40367 | 0.7998
BSC093N04LS GCT-ND | 0.62 | 0.0093 | 2 | 4.9 | 24 | 1 | 2 | 1.3 | 0.30225 | 1.39104 | 1.69329 | 1.488
NTD5865NLT4GOSCT-ND | 0.65 | 0.019 | 8 | 4 | 29 | 1.3 | 2 | 1.3 | 0.6175 | 2.6784 | 3.2959 | 1.798
Si7884DP | ? | 0.0095 | 7.5 | 6 | 28 | 1 | 3 | 1.3 | 0.30875 | 2.7216 | 3.03035 | 1.736
Digikey | Price | Inductor
 |  | Inductance | DCR |  |  |  |  |  | Ohmic loss |  | Total Loss
732-4237-1-ND | 8.03 | 22 | 0.007 |  |  |  |  |  | 0.175 |  | 0.175
732-2179-1-ND | 6.4 | 47 | 0.0335 |  |  |  |  |  | 0.8375 |  | 0.8375
732-2177-1-ND | 6.4 | 22 | 0.0146 |  |  |  |  |  | 0.365 |  | 0.365
