TheComet/bat6/pm/pflichtenheft/grobschaetzung-preis.ods

uC
Quantity | Designator | Value | Value2 | Type | Supplier - Digikey | Price | Total
1 | C? | 22u | 35V |  |  | 0.73 | 0.73
1 | C? | 10n | 50V |  |  | 0.6 | 0.6
1 | C? | 10uF | 16V |  |  | 0.73 | 0.73
6 | C? | 100n | 50V |  |  | 0.6 | 3.6
1 | D? |  |  | DSPIC33EP16GS506 | DSPIC33EP16GS506-I/PT-ND | 4.09 | 4.09
1 | D? |  |  |  | NHD-0420CW-AR3-ND | 26.67 | 26.67
1 | L? | 4.7uH | 1A |  | 732-2956-1-ND | 1.06 | 1.06
1 | N? | 1.5V | 7mA | ISL21080CIH315Z-TK | ISL21080CIH315Z-TKCT-ND | 1.61 | 1.61
1 | R? | 10k | 100mW |  |  | 0.1 | 0.1
1 | R? | 470E | 0.1W |  |  | 0.1 | 0.1
1 | X3 |  |  | Pitch 2.54, Diameter 0.9mm, 1 row, 3 columns |  | 0 | 0
1 | Z? | 1.5A |  | BLM18KG471SN1D | 490-5257-1-ND | 0.1 | 0.1
1 | Z? |  |  | PEC16-4220F-S0024-ND |  | 1.23 | 1.23
 |  |  |  |  |  |  | 40.62
Buck Converter
Quantity | Designator | Value | Value2 | Type | Supplier - Digikey
1 | C? | 47uF | 50V |  | 493-4554-1-ND | 3.42 | 3.42
1 | C? | 100uF | 50V |  | 493-4558-1-ND | 5.12 | 5.12
2 | C? | 1uF | 50V |  | 587-2910-1-ND | 0.19 | 0.38
1 | C? | 4.7nF | 50V |  |  | 0.6 | 0.6
3 | C? | 10uF | 50V |  | 490-6544-1-ND | 0.73 | 2.19
2 | C? | 33nF | 50V |  | 1276-2042-1-ND | 0.1 | 0.2
1 | C? | 47nF | 50V |  |  | 0.6 | 0.6
7 | C? | 100n | 50V |  |  | 0.6 | 4.2
2 | E? |  |  |  | J151-ND | 0.7 | 1.4
1 | L? | 22uH | 15A |  | 732-4237-1-ND | 0.19 | 0.19
1 | N? |  |  | LT3741 | LT3741EUF#PBF-ND | 8.44 | 8.44
2 | R? | 10m | 500mW |  | LVK12R010DERCT-ND | 0.74 | 1.48
3 | R? | 4.7k | 100mW |  |  | 0.1 | 0.3
4 | R? | 10E | 100mW |  |  | 0.1 | 0.4
2 | R? | 10k | 100mW |  |  | 0.1 | 0.2
1 | R? | 43k | 100mW |  | P43KDBCT-ND | 0.63 | 0.63
1 | R? | 47k | 100mW |  |  | 0.1 | 0.1
1 | R? | 180k | 100mW |  | P180KDBCT-ND | 0.63 | 0.63
1 | R? | 240E | 100mW |  | P240DBCT-ND | 0.63 | 0.63
1 | V? |  |  | BAS28,215 | 568-1600-1-ND | 0.39 | 0.39
2 | V? |  |  | BSC093N04LS | BSC093N04LS GCT-ND | 0.62 | 1.24
1 | V? |  |  | MBR0540T1G | MBR0540T1GOSCT-ND | 0.36 | 0.36
1 | V? | 50V | 6A |  | 6A05DICT-ND | 0.43 | 0.43
2 | Z? | 5A |  | MH2029-600Y | MH2029-600YCT-ND | 0.1 | 0.2
 |  |  |  |  |  |  | 33.73
Rails
Quantity | Designator | Value | Value2 | Type | Supplier - Digikey
4 | C? | 10uF | 50V |  | 490-6544-1-ND | 0.73 | 2.92
1 | C? | 100n | 50V |  |  | 0.6 | 0.6
1 | C? | 470nF | 50V |  | 587-3170-1-ND | 0.6 | 0.6
1 | L? | 10uH | 2A | 74477710 | 732-1200-1-ND | 3.08 | 3.08
1 | N? |  |  | AP2114H-3.3 | AP2114H-3.3TRG1DICT-ND | 0.36 | 0.36
1 | N? | 36V | 72W |  | 285-1829-ND | 27.41 | 27.41
1 | N? |  |  | LT3973 | LT3973EDD-5#PBF-ND | 5.88 | 5.88
1 | R? | 100E | 100mW |  |  | 0.1 | 0.1
1 | X? |  |  |  | 817-1489-ND | 15.96 | 15.96
 |  |  |  |  |  |  | 56.91
UART/USB
Quantity | Designator | Value | Value2 | Type | Supplier - Digikey
1 | C? | 10n | 50V |  |  | 0.6 | 0.6
1 | C? | 10uF | 16V |  |  | 0.7 | 0.7
2 | C? | 100n | 50V |  |  | 0.6 | 1.2
1 | D? |  |  | ADuM5241 | ADUM5241ARZ-RL7CT-ND | 6.96 | 6.96
1 | D? |  |  | FT232RQ | 768-1008-1-ND | 4.5 | 4.5
2 | H? |  |  | Blue | VAOL-S6SB4TR-ND | 0.135 | 0.27
2 | R? | 100E | 100mW |  |  | 0.1 | 0.2
1 | X? |  |  | USB Micro B | 609-4618-1-ND | 0.46 | 0.46
1 | Z? | 1.5A |  | BLM18KG471SN1D | 490-5257-1-ND | 0.1 | 0.1
 |  |  |  |  |  |  | 14.99
Housing
Quantity | Designator | Value | Value2 | Type | Supplier - Digikey
1 |  |  |  |  | HM1417-ND | 26.92 | 26.92
 |  |  |  |  |  |  | 26.92
 |  |  |  |  | Total Cost |  | 173.17
