TheComet/bat6/mechanical/housing/frontplate.pdf

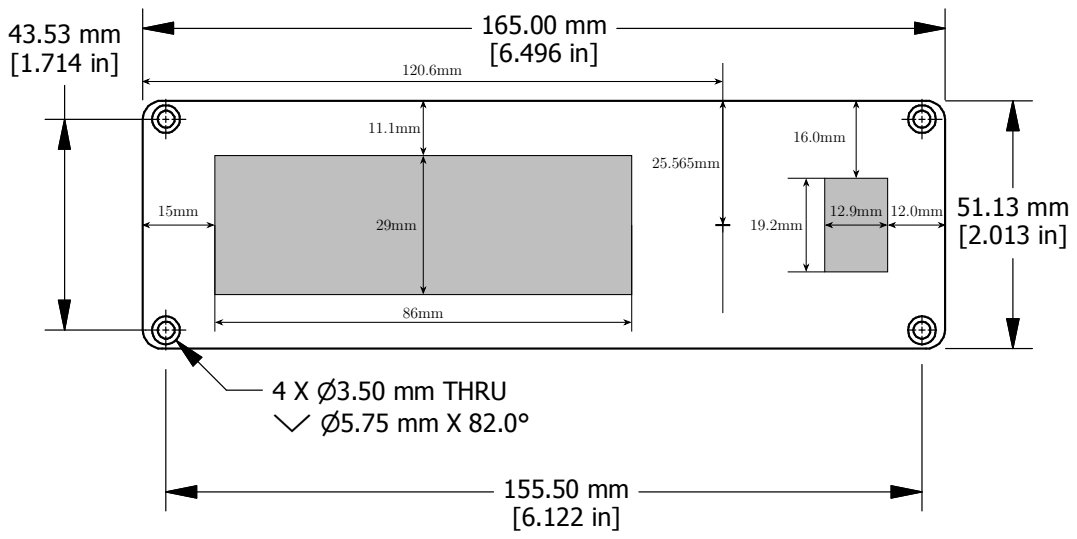
[picture p97: page 1]
4 X n3.50 mm THRU w n5.75 mm X 82.0°
