TheComet/bat6/hardware/schematic-drafts/PV-Simulator-draft-15-11-02-2047.pdf

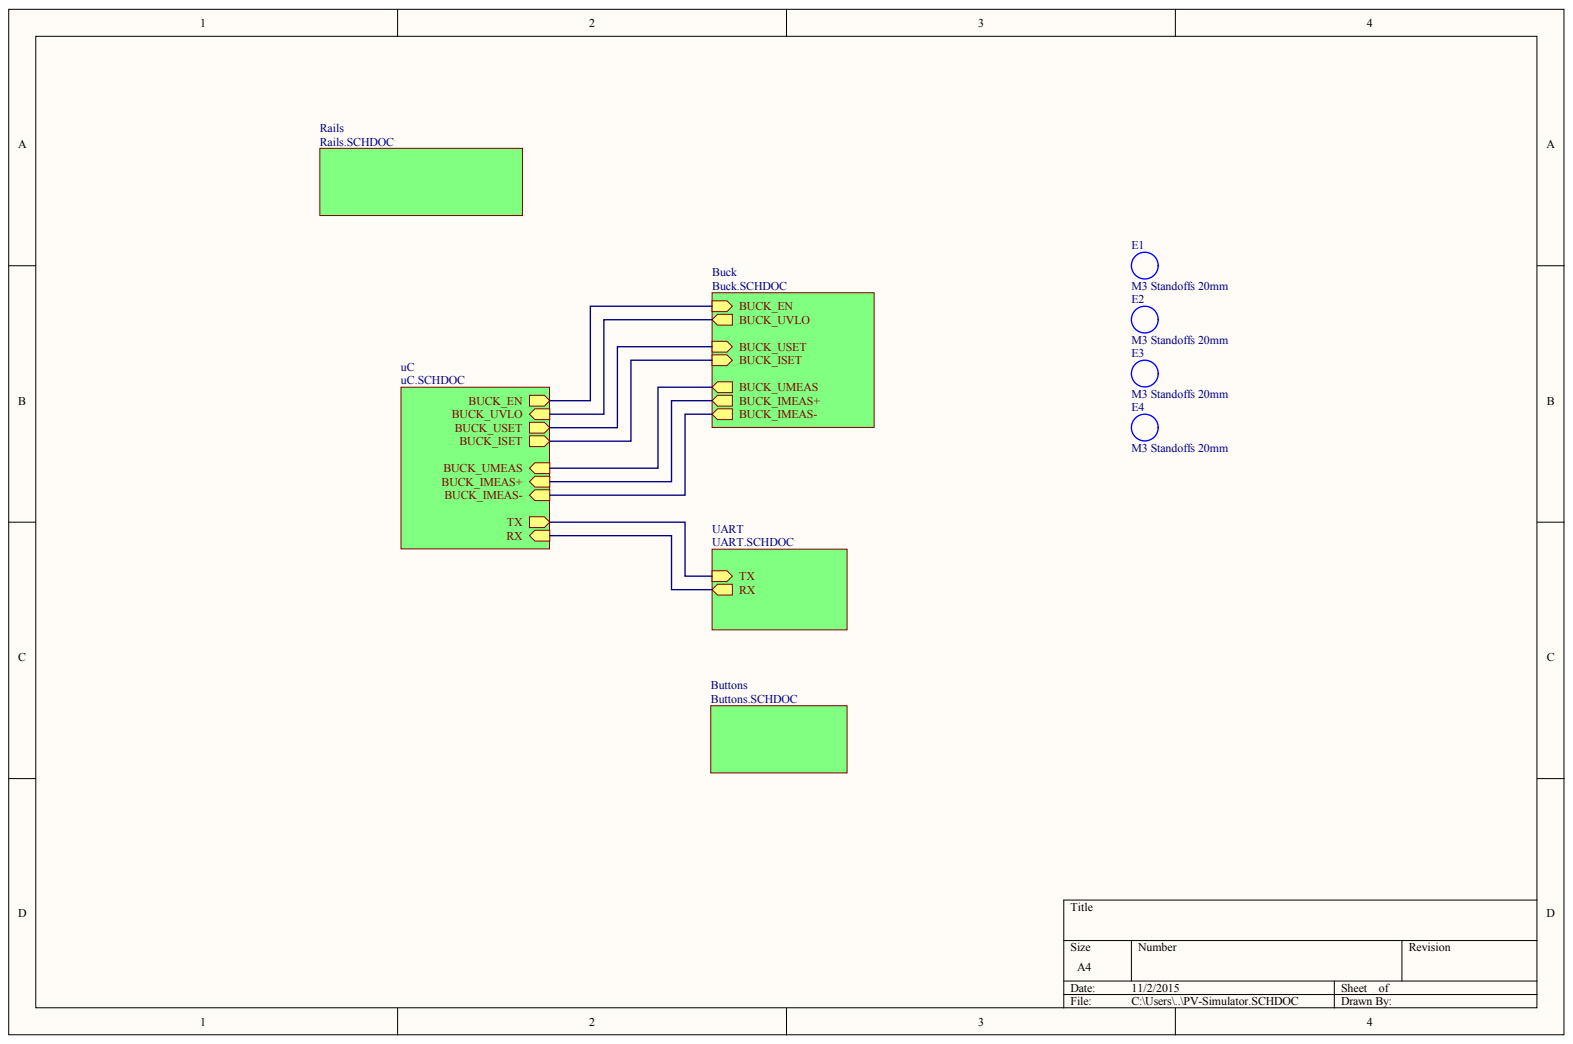
[picture p98: page 1]

Numb e r | Revision

Sheet o f

File: C: \U sers\ . . \P V -Simulator. SCH D O C | D r awn By :

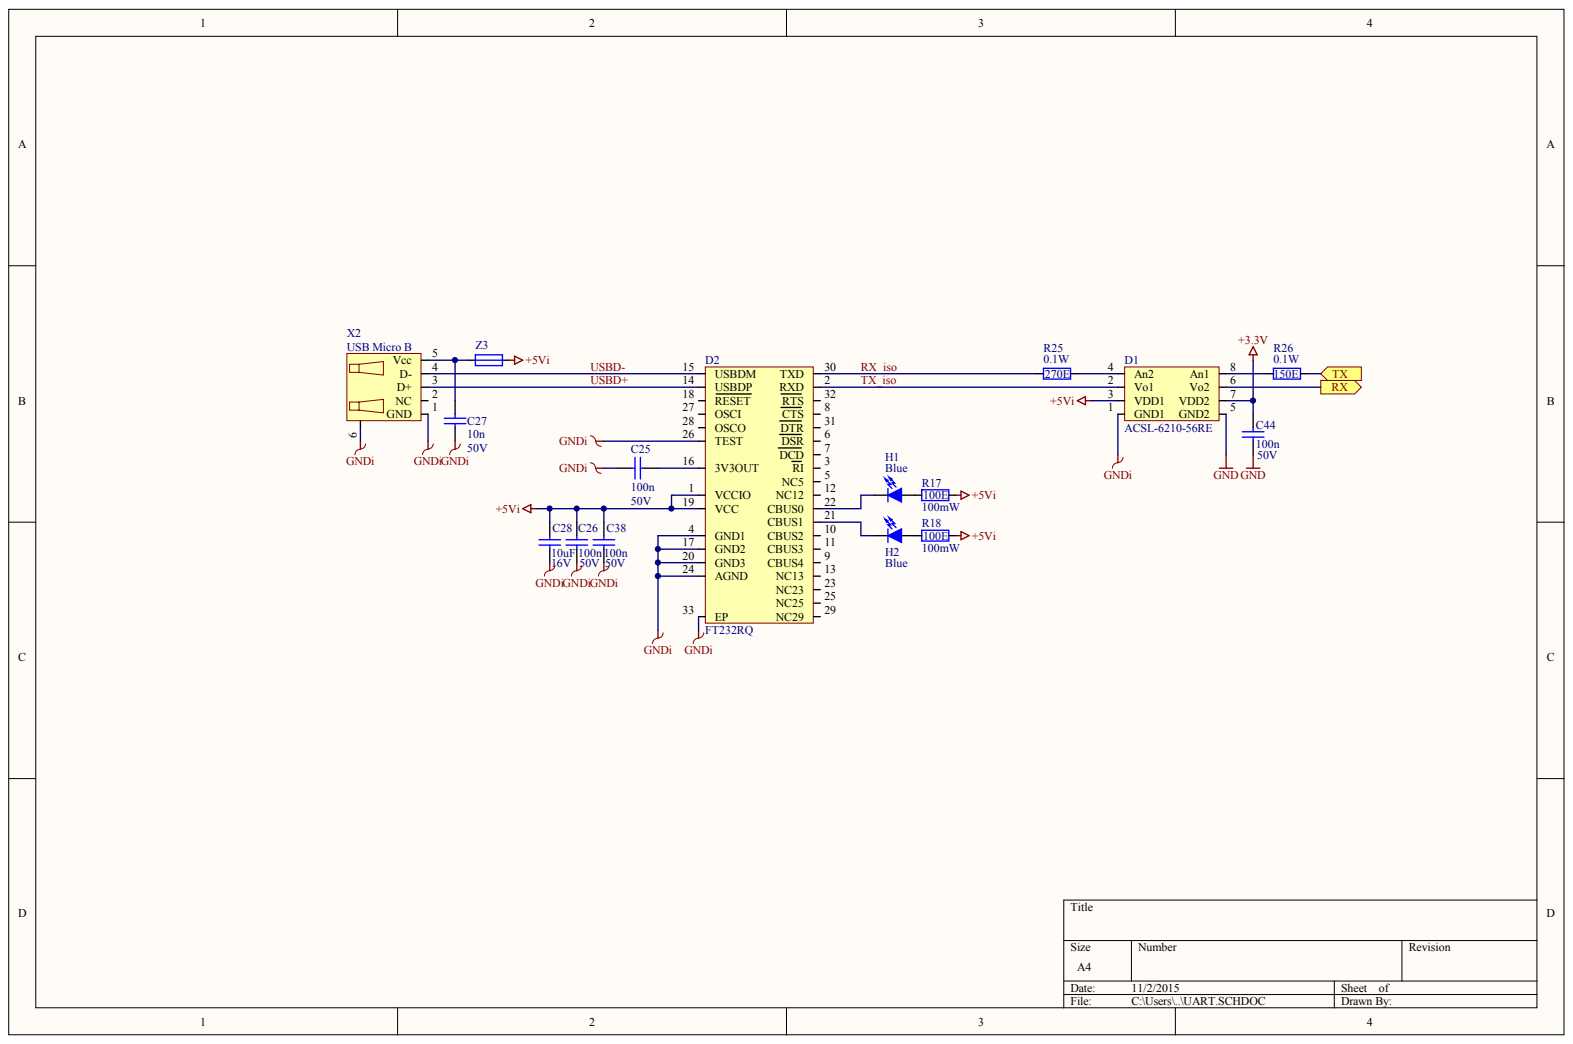
[picture p99: page 2]

Numb e r | Revision

Sheet o f

File: C: \U sers\ . . \U ART . SCH D O C | D r awn By :

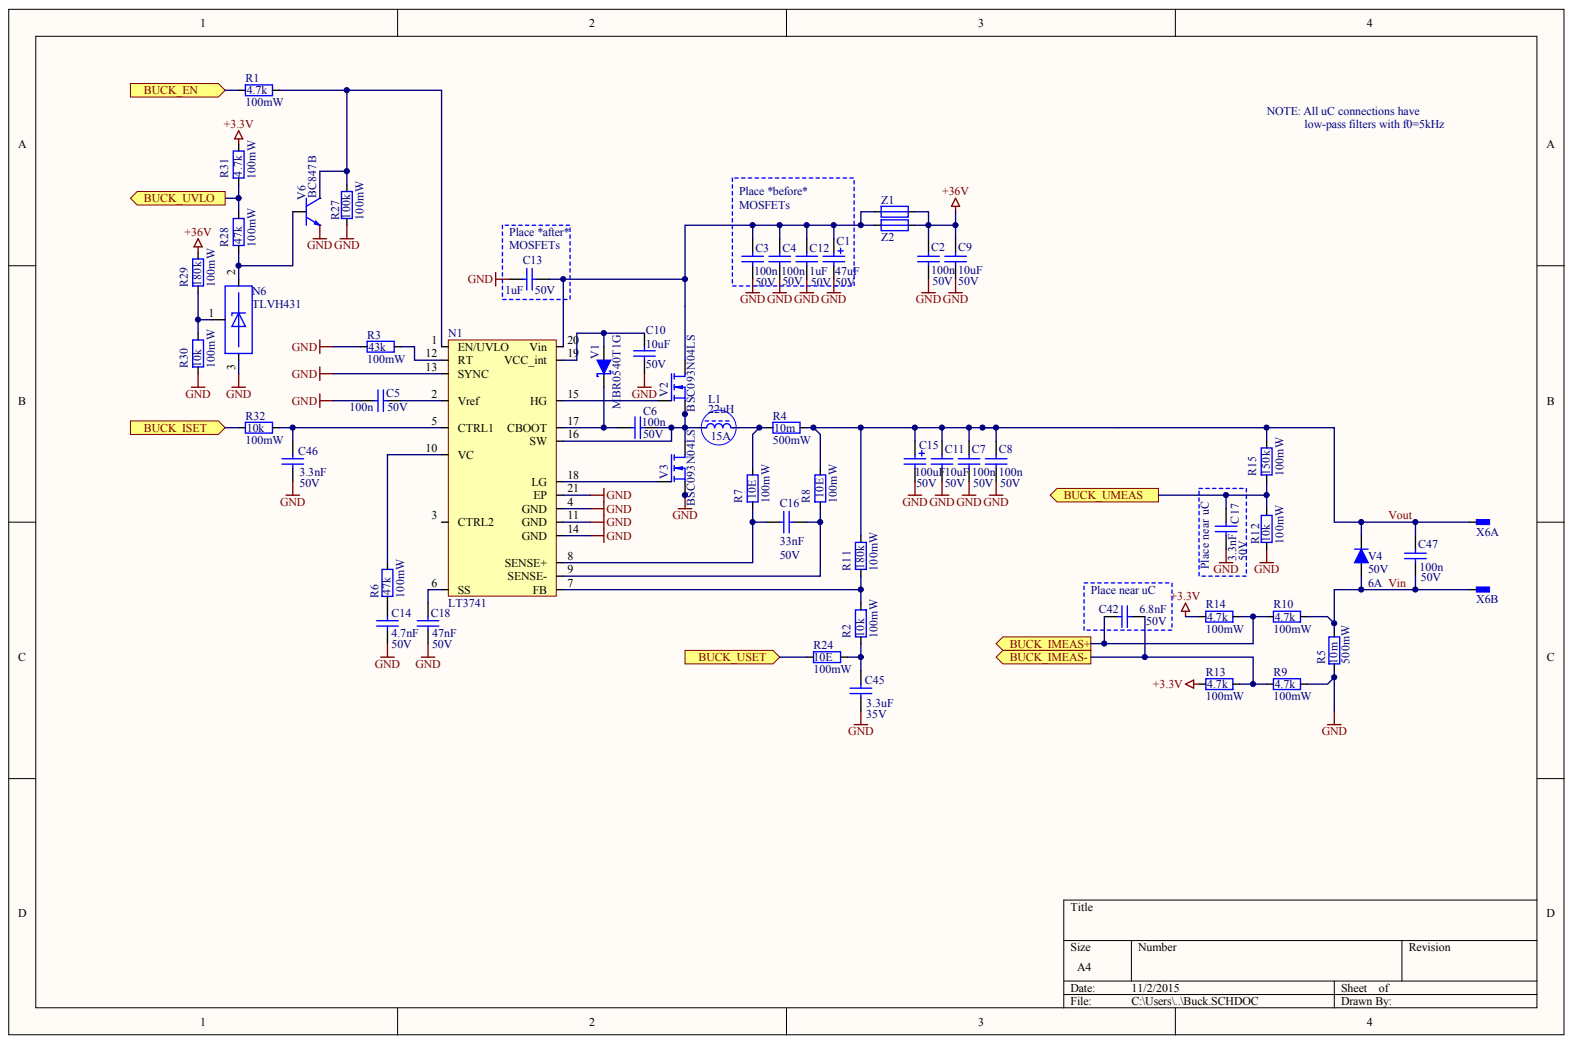
[picture p100: page 3]

Numb e r | Revision

Sheet o f

File: C: \U sers\ . . \Buck.SCH D O C | D r awn By :

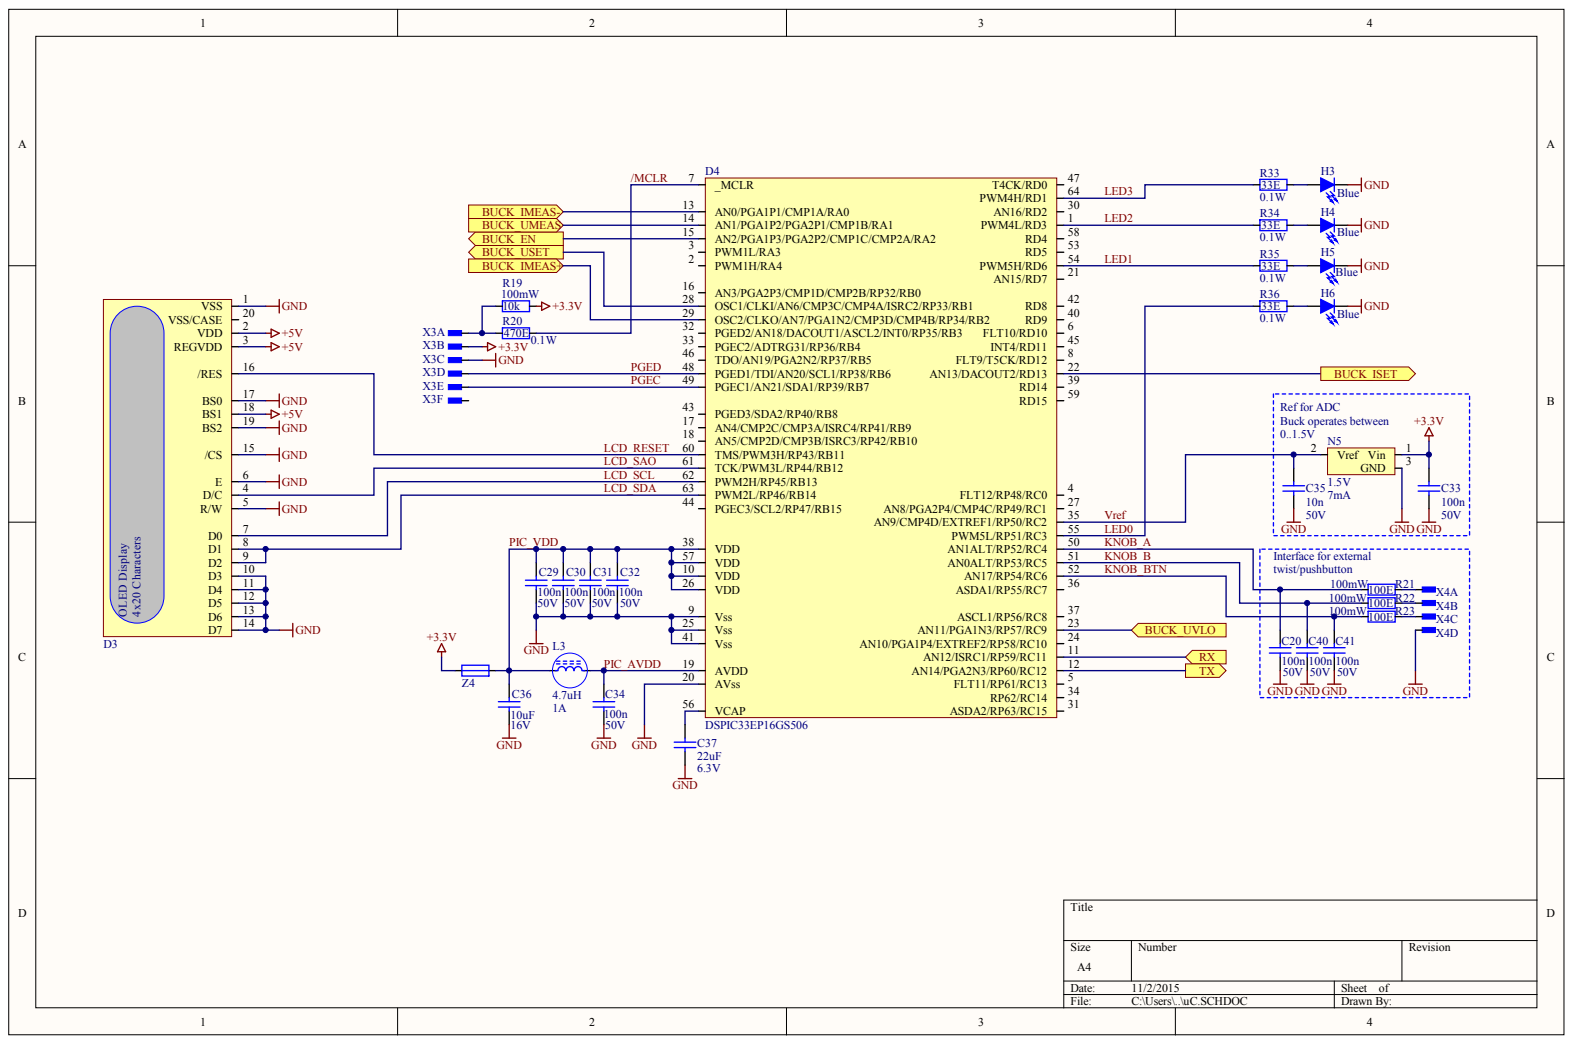
[picture p101: page 4]

S -S | LED 3 | 33E

Numb e r | Revision

Sheet o f

File: C: \U sers\ . . \uC. SCH D O C | D r awn By :

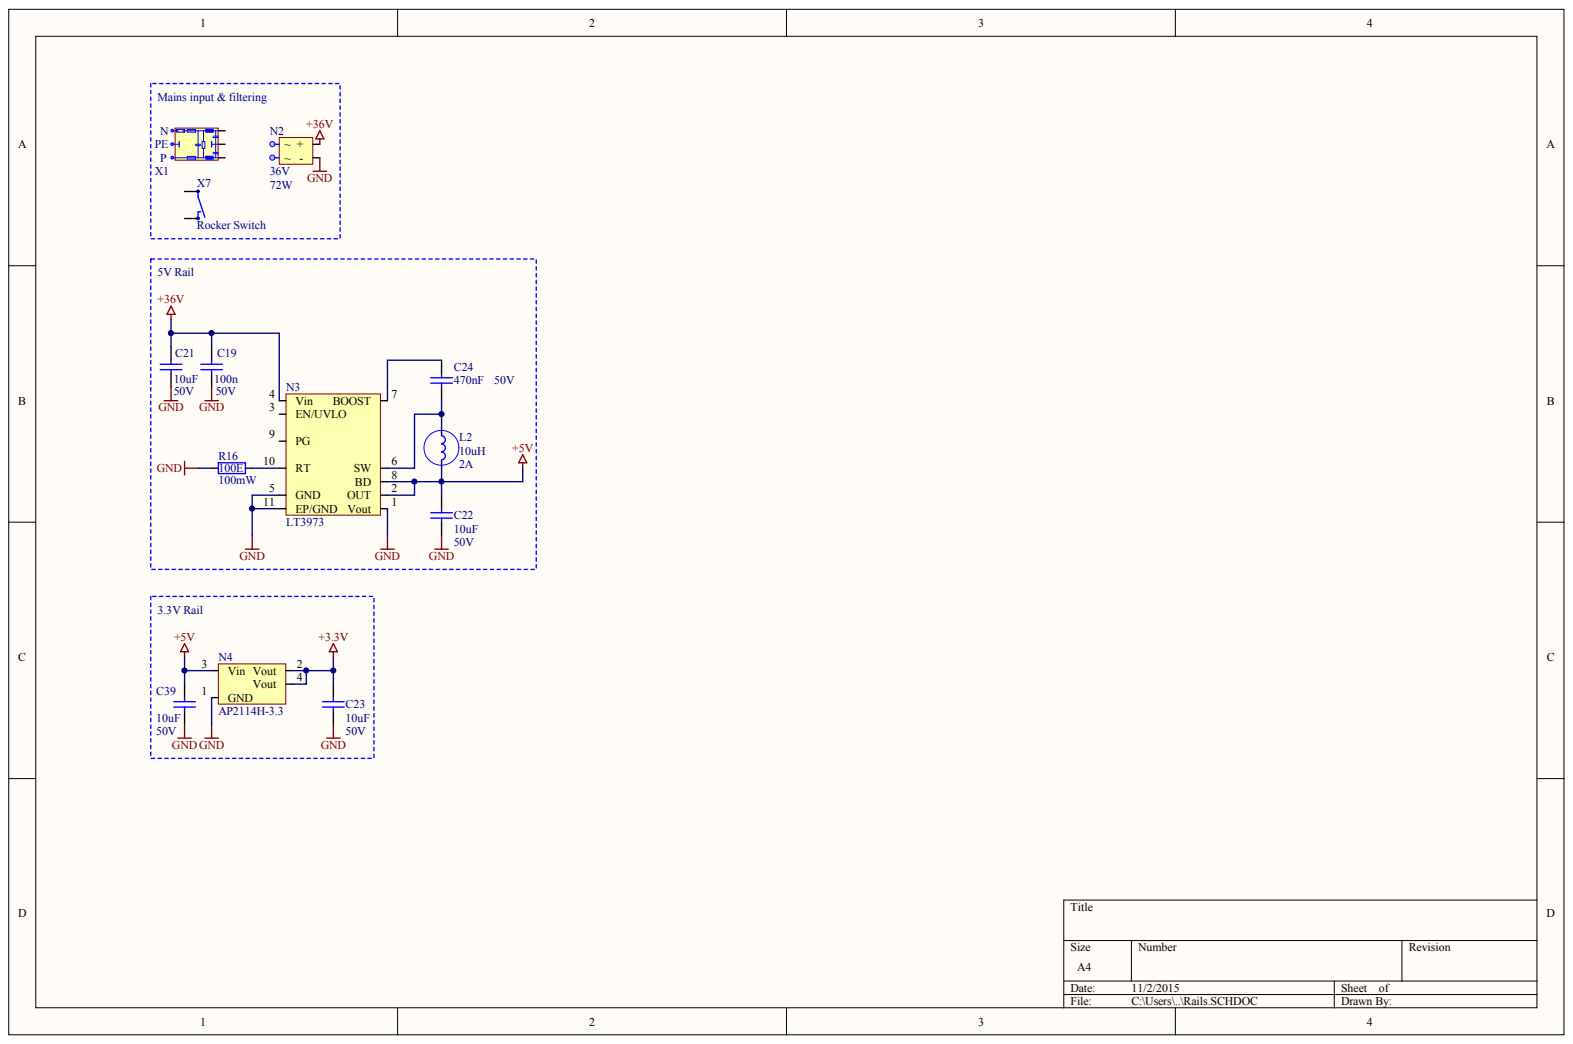
[picture p102: page 5]

Size A4 | Number | Revision

Date: 11/2/2015 | Sheet of
File: C:\Users\..\Rails.SCHDOC | Drawn By:

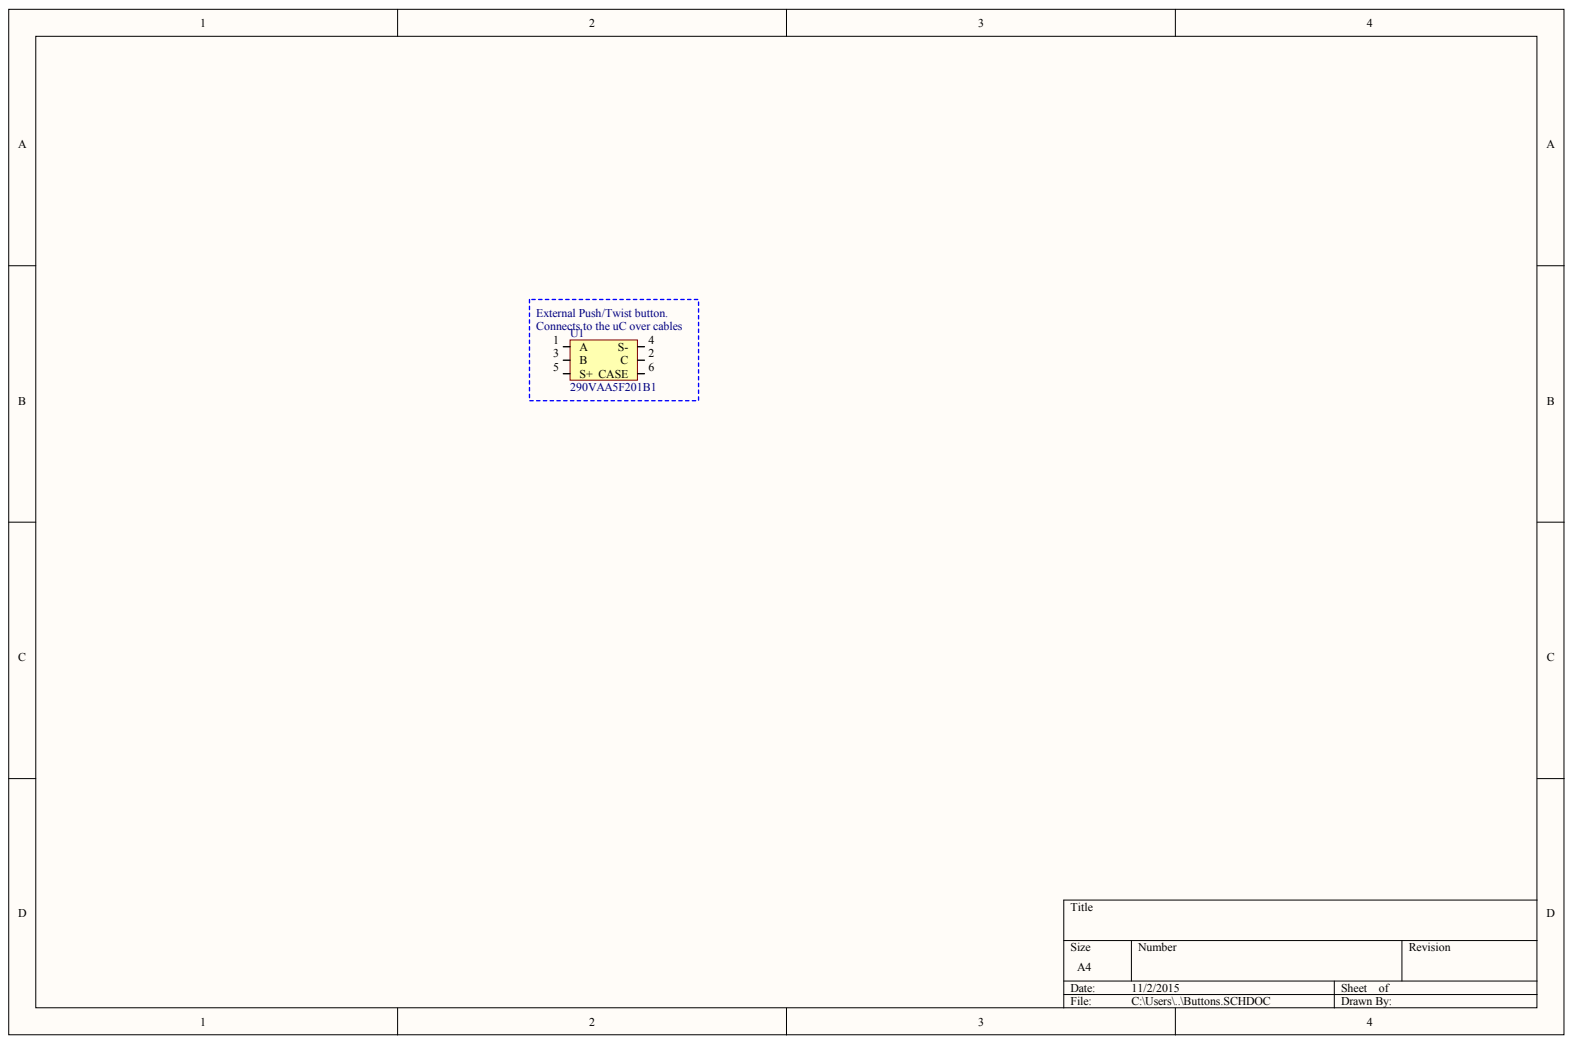
[picture p103: page 6]

Numb e r | Revision

Sheet o f

File: C: \U sers\ . . \Buttons. SCH D O C | D r awn By :
