TheComet/bat6/hardware/schematic-drafts/PV-Simulator-draft-15-10-18-0218.pdf

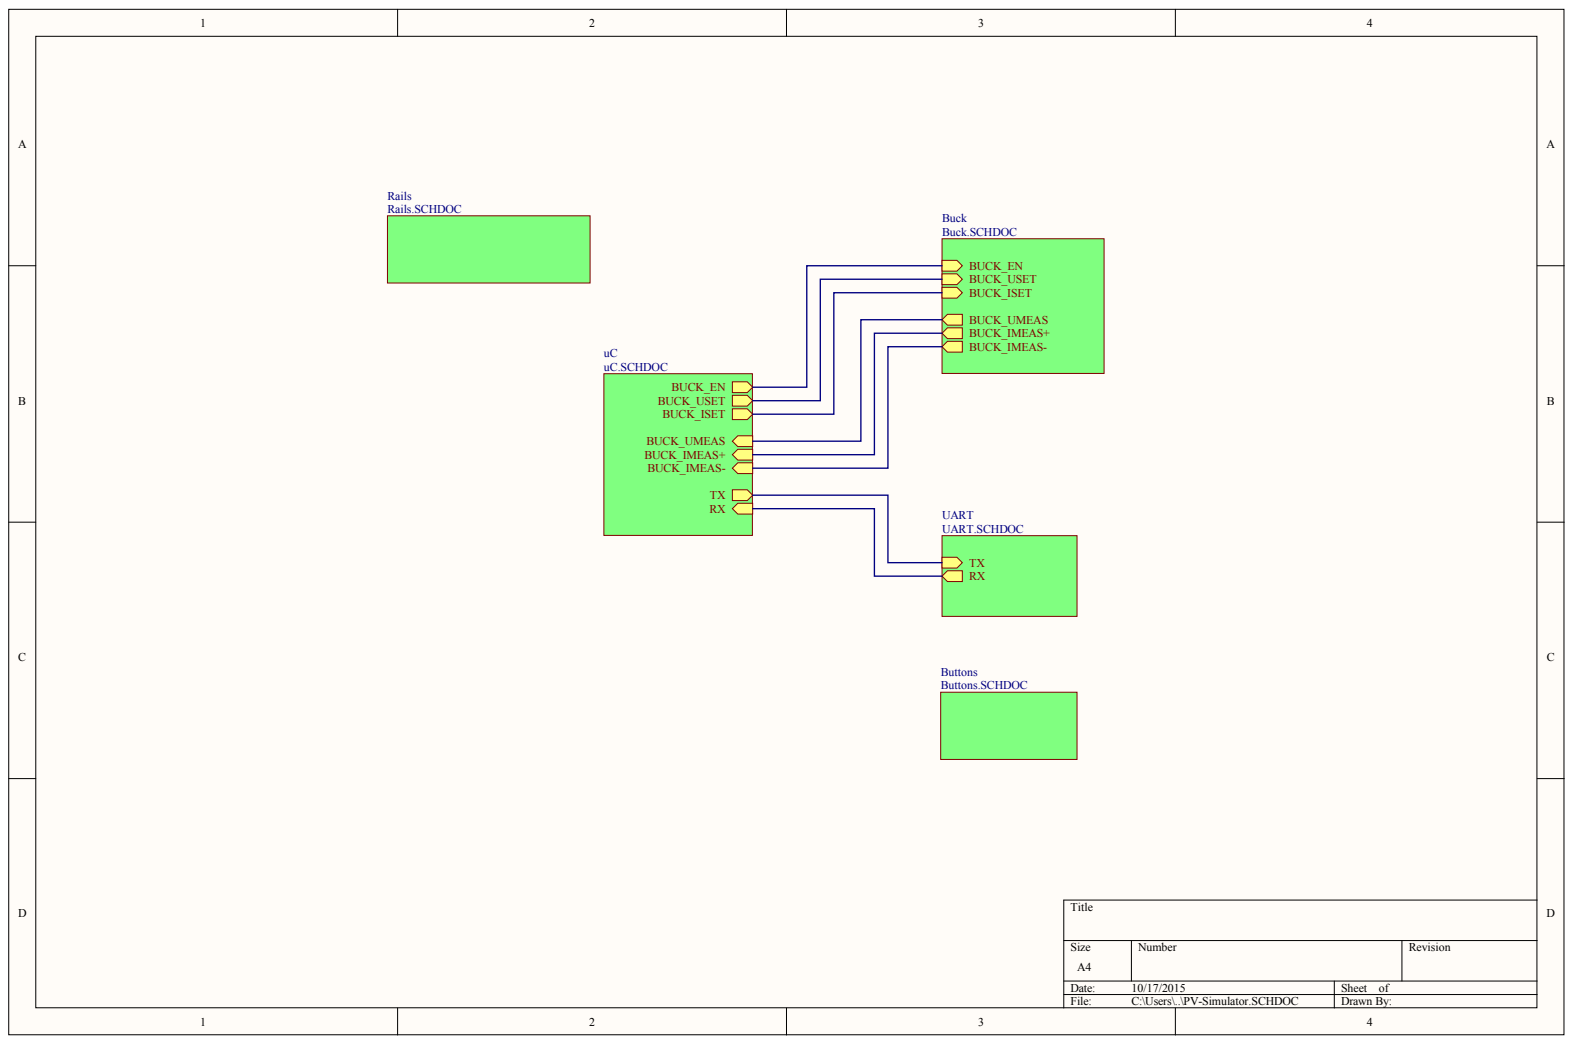
[picture p104: page 1]

Size A4 | Number | Revision

Date: 10/17/2015 | Sheet of
File: C:\Users\..\PV-Simulator.SCHDOC | Drawn By:

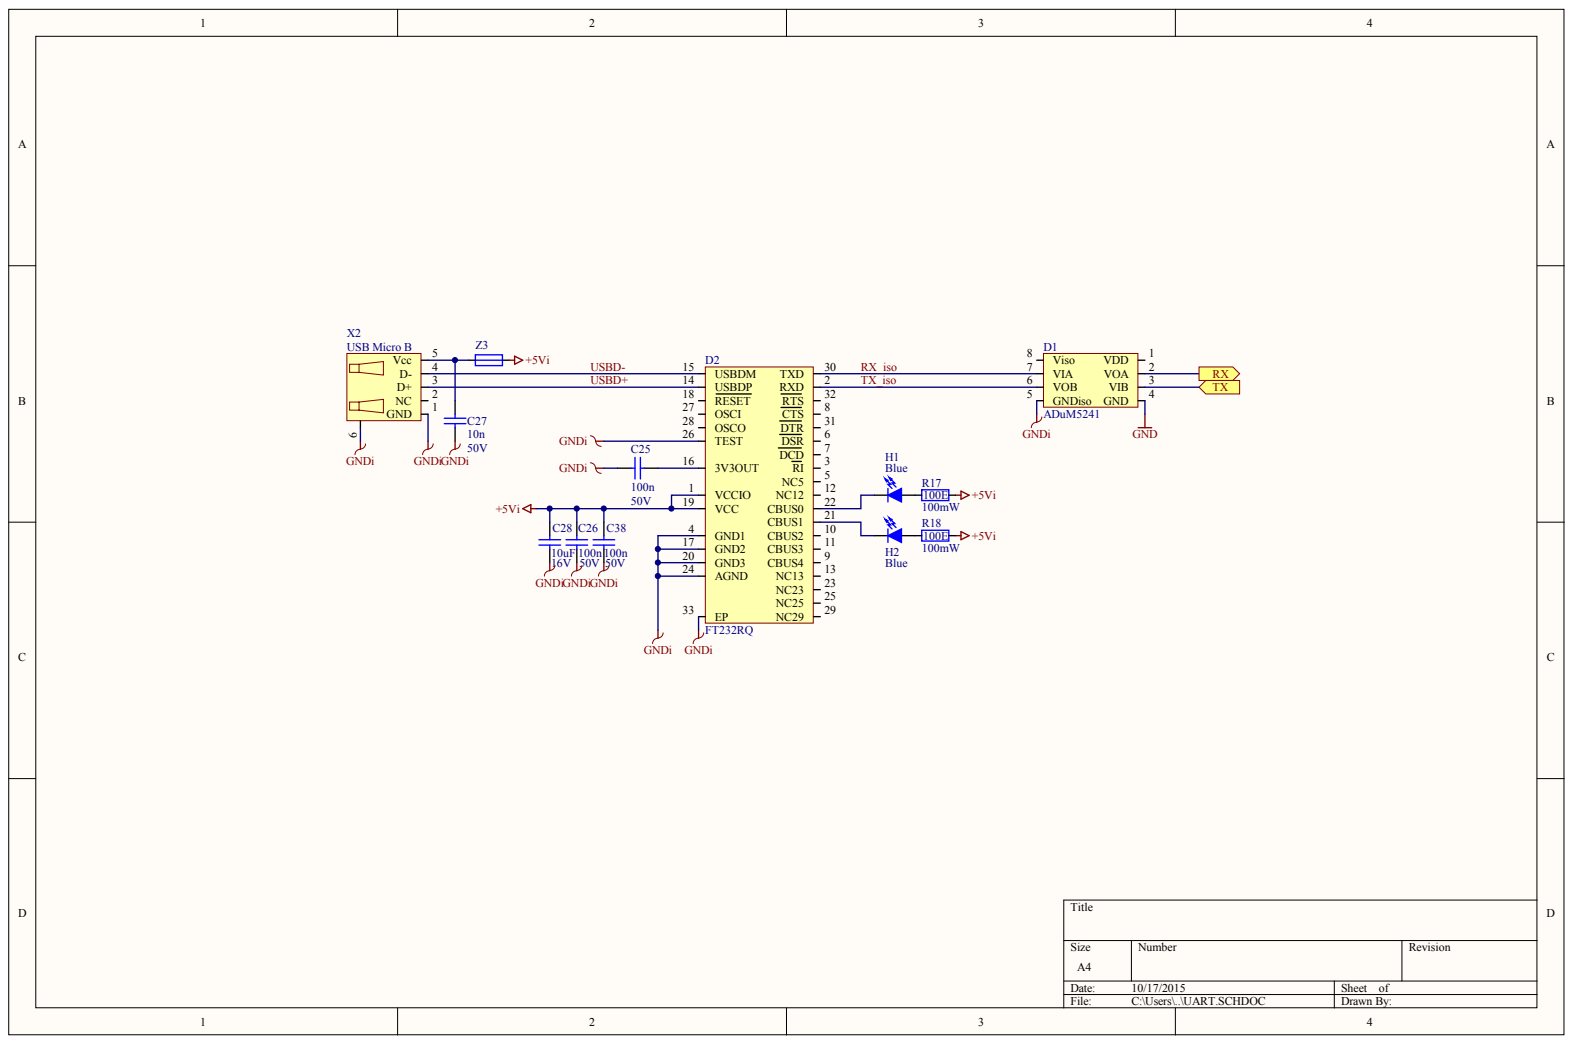
[picture p105: page 2]

Numb e r | Revision

Sheet o f

File: C: \U sers\ . . \U ART . SCH D O C | D r awn By :

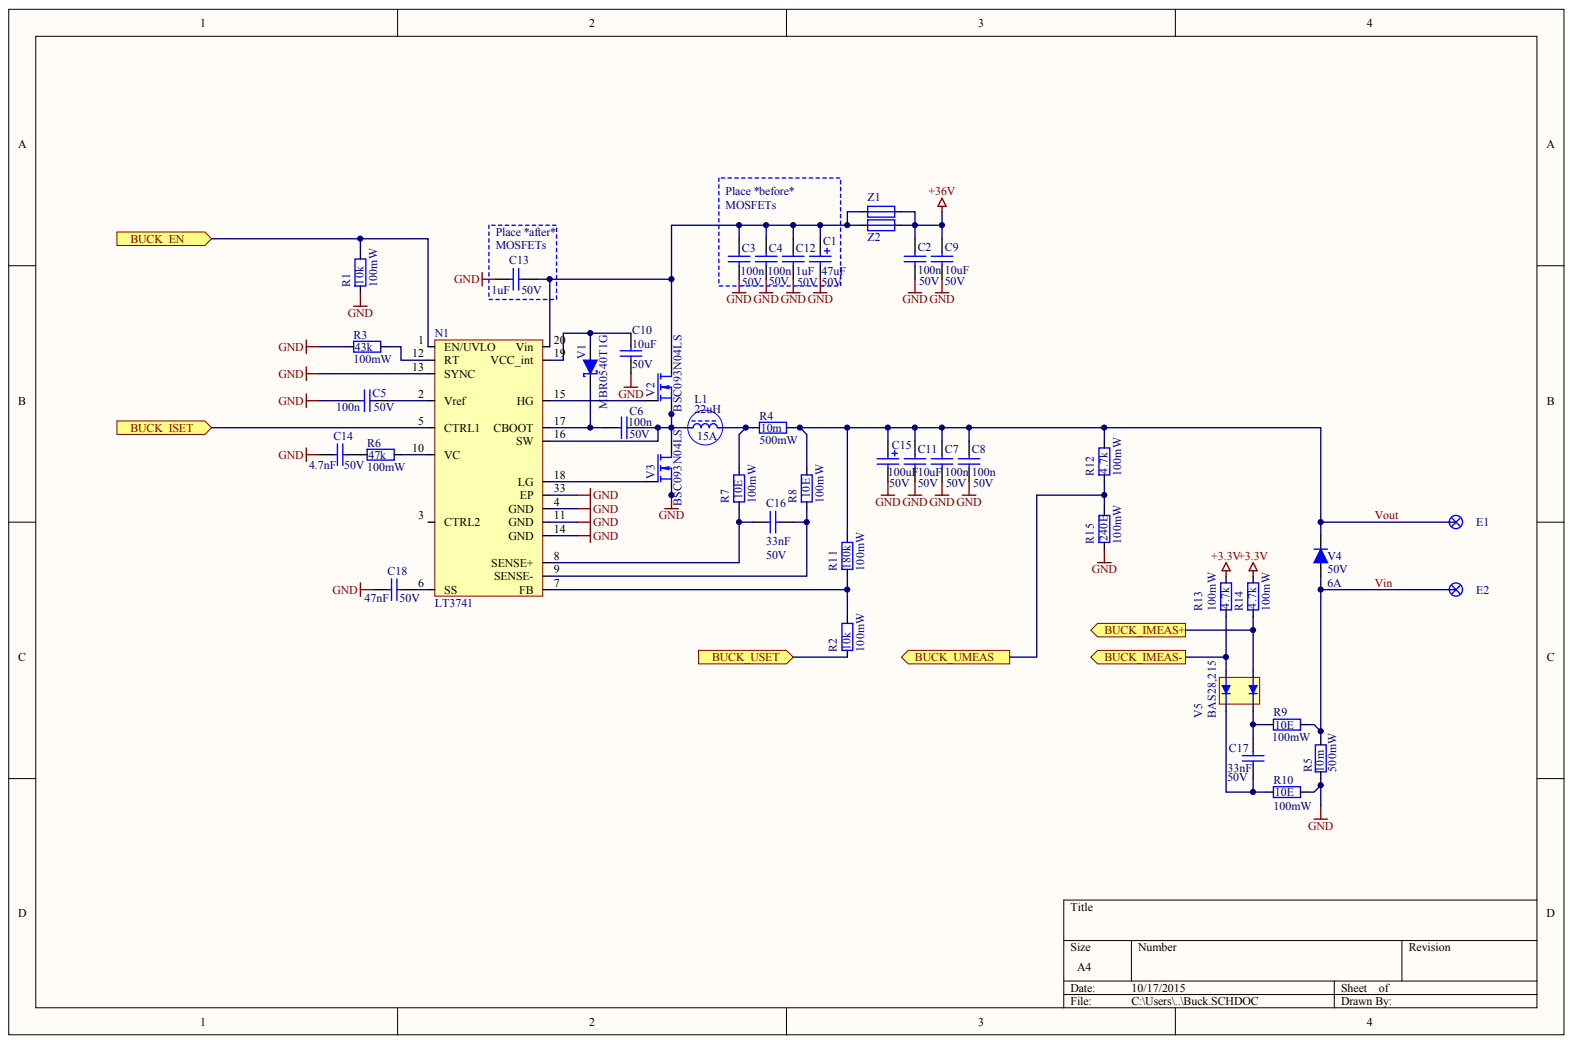
[picture p106: page 3]

Numb e r | Revision

Sheet o f

File: C: \U sers\ . . \Buck.SCH D O C | D r awn By :

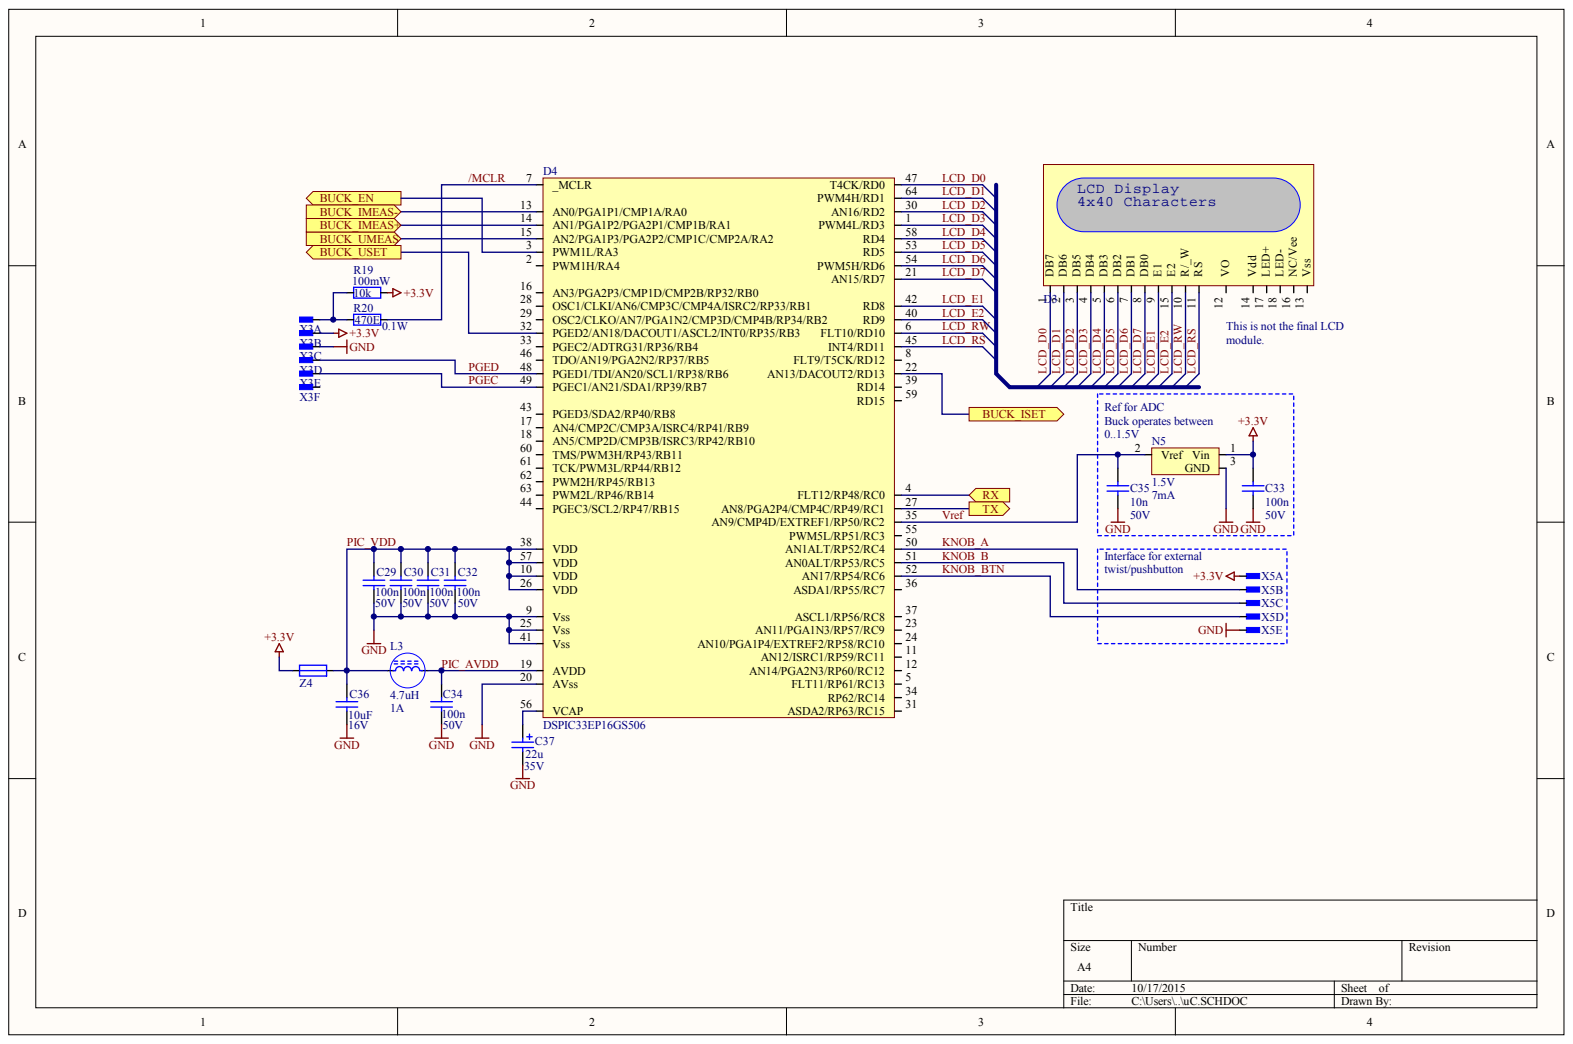
[picture p107: page 4]

This is not the
module.

KN OB_B | for externa l
KN OB_BT N

Numb e r | Revision

Sheet o f

File: C: \U sers\ . . \uC. SCH D O C | D r awn By :

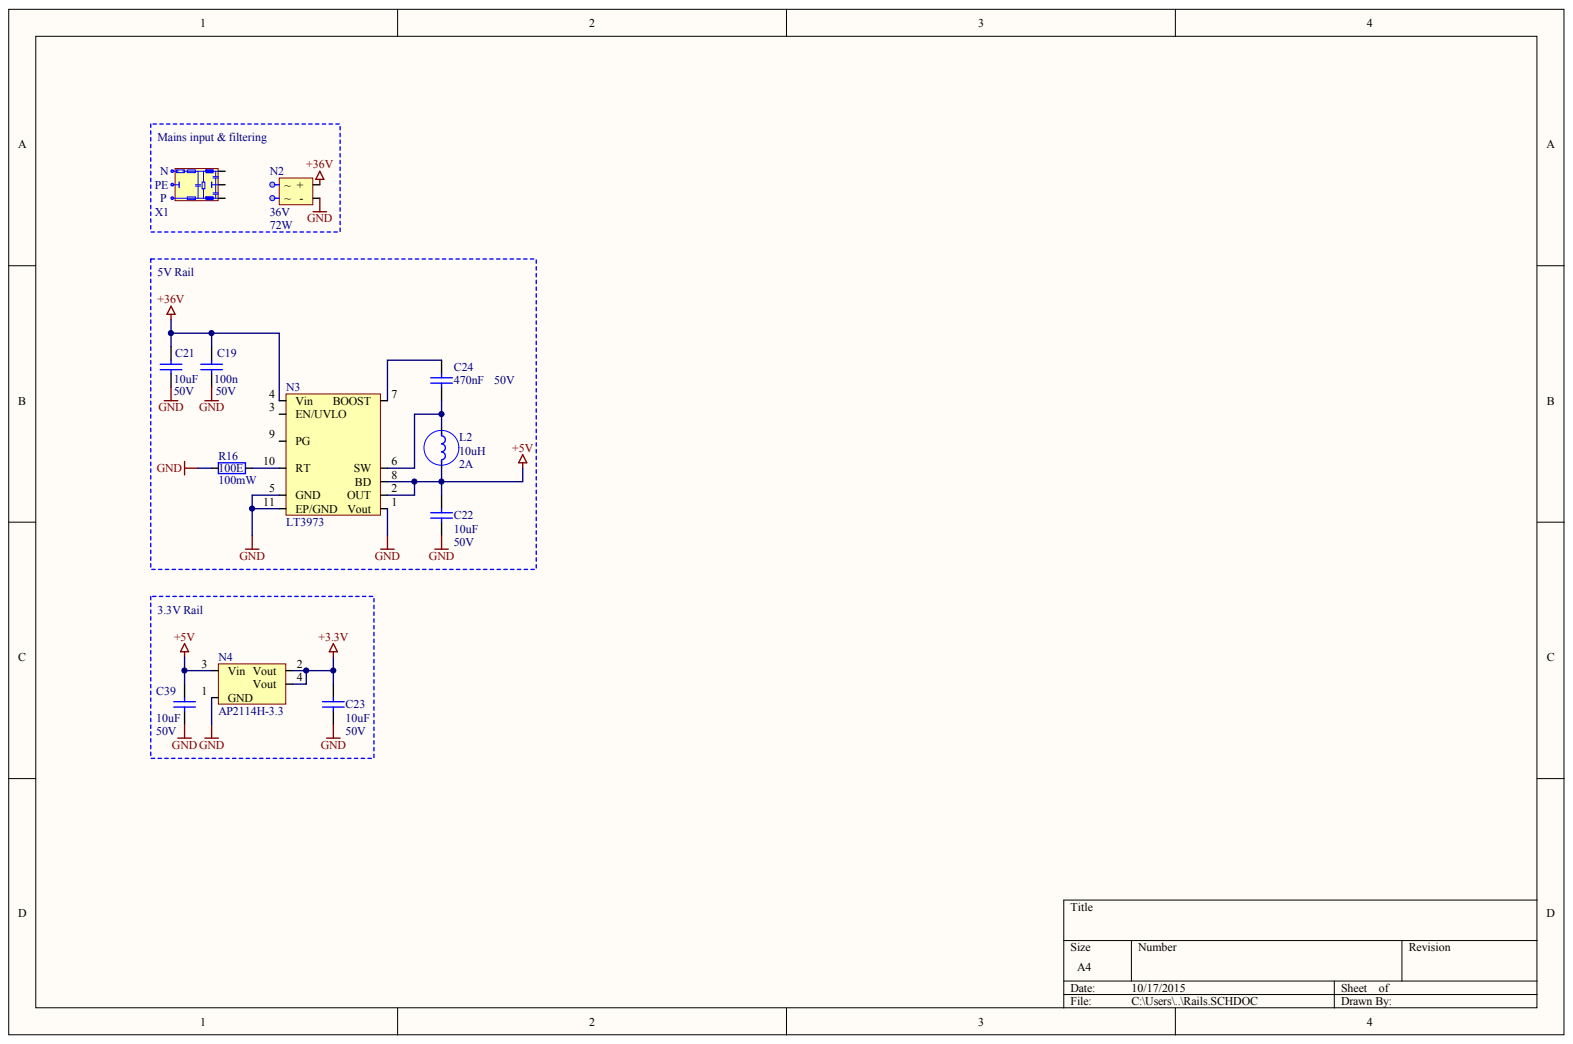
[picture p108: page 5]

Size A4 | Number | Revision

Date: 10/17/2015 | Sheet of
File: C:\Users\..\Rails.SCHDOC | Drawn By:

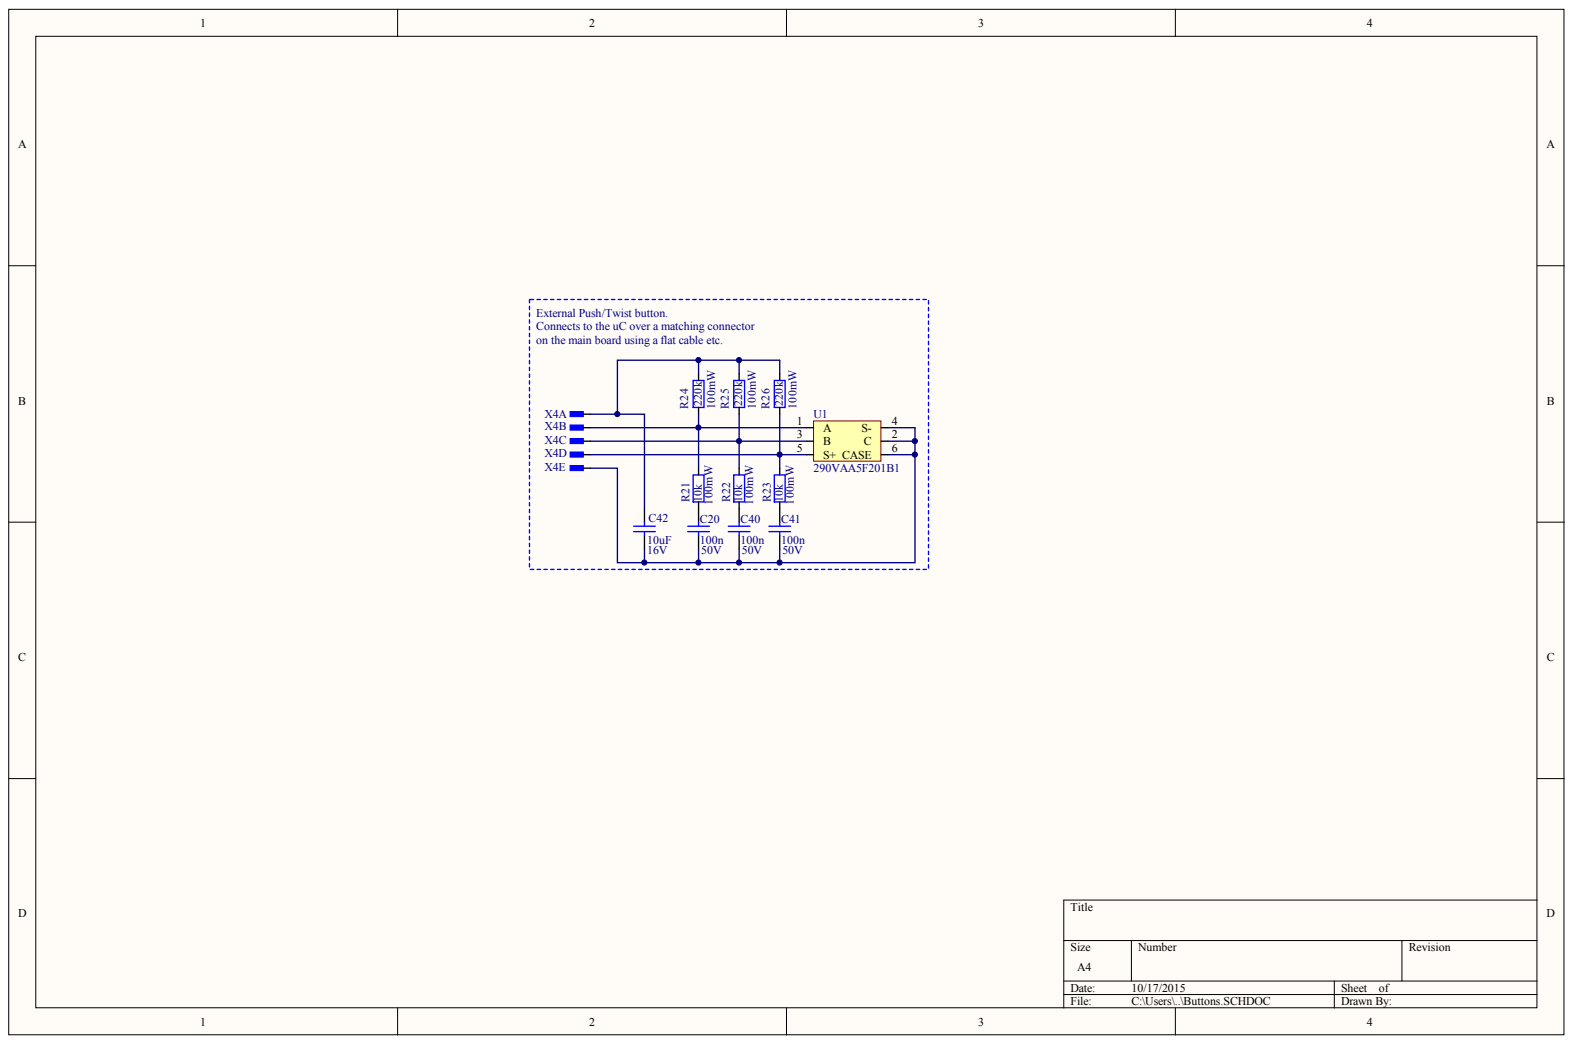
[picture p109: page 6]

External
Connects to the uC over
on the

Numb e r | Revision

Sheet o f

File: C: \U sers\ . . \Buttons. SCH D O C | D r awn By :
