TheComet/bat6/doc/documentation/images/schematic.pdf

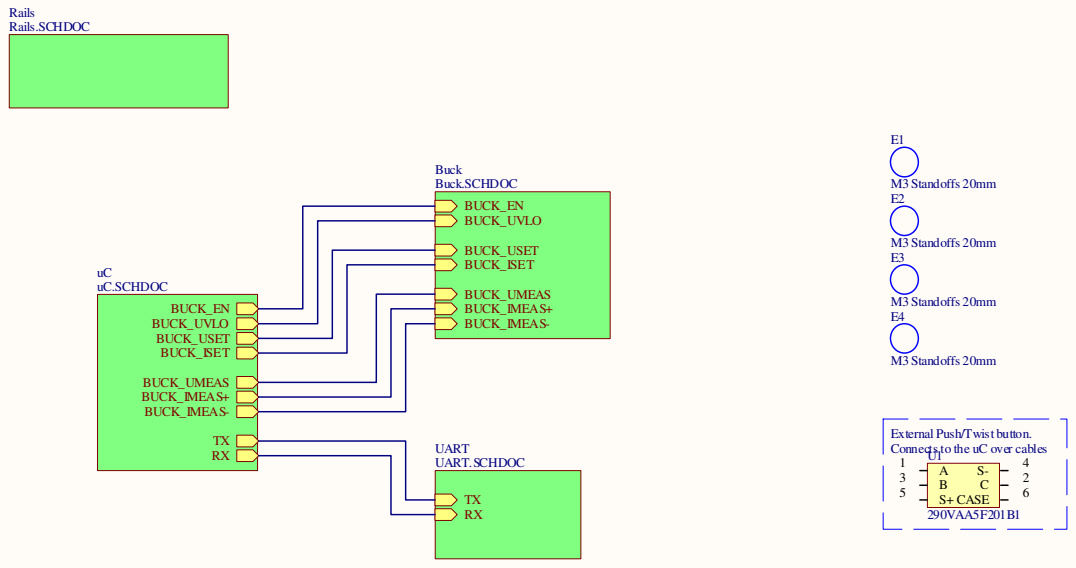
[picture p110: page 1]
Title; Size; Number; Revision; Date:; Sheet of; File:; C:\Users\..\PV-Simulator.SCHDOC; Drawn By:; UART UART.SCHDOC; Rails Rails.SCHDOC; BUCK_USET BUCK_ISET; BUCK_EN; BUCK_UMEAS BUCK_IMEAS+ BUCK_IMEAS-; BUCK_UVLO; uC uC.SCHDOC; BUCK_ISET; BUCK_USET; Buck; Buck.SCHDOC; M3 Standoffs 20mm; CASE; 290VAA5F201B1; External Push/Twist button. Connects to the uC over cables

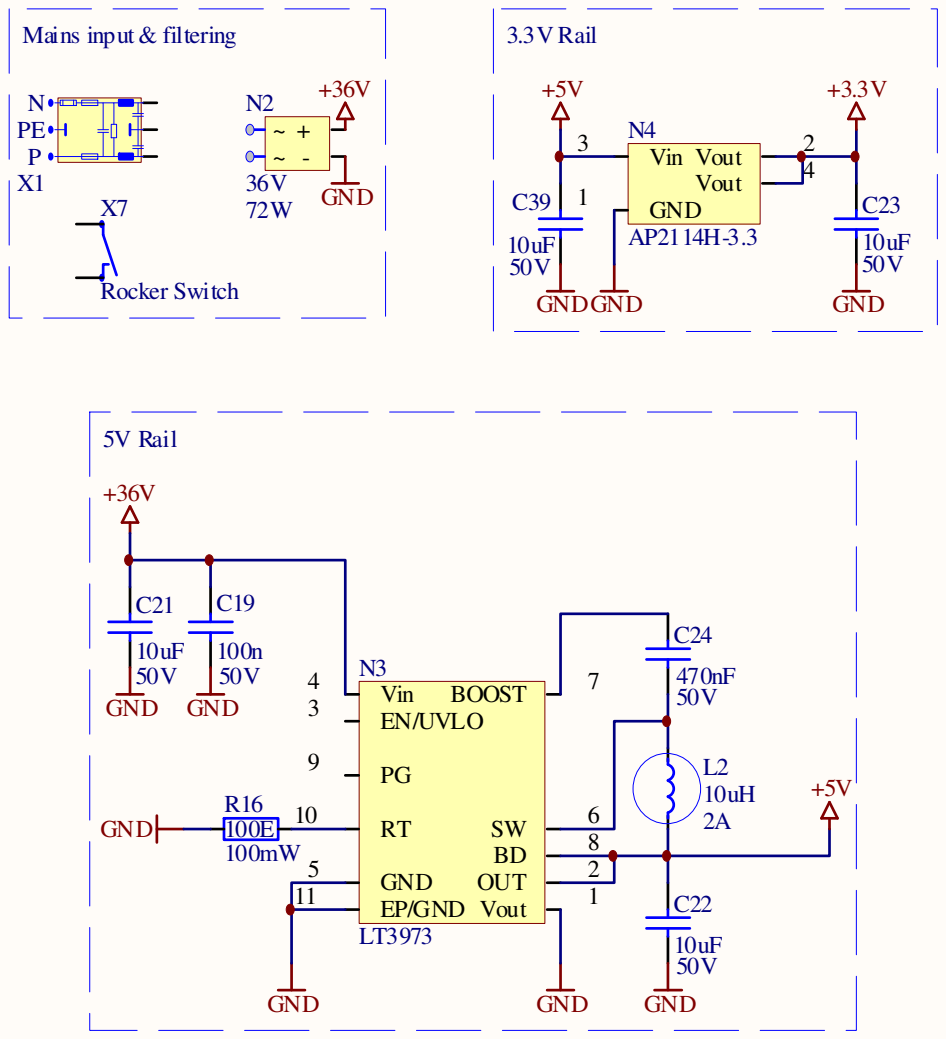
[picture p111: page 2]

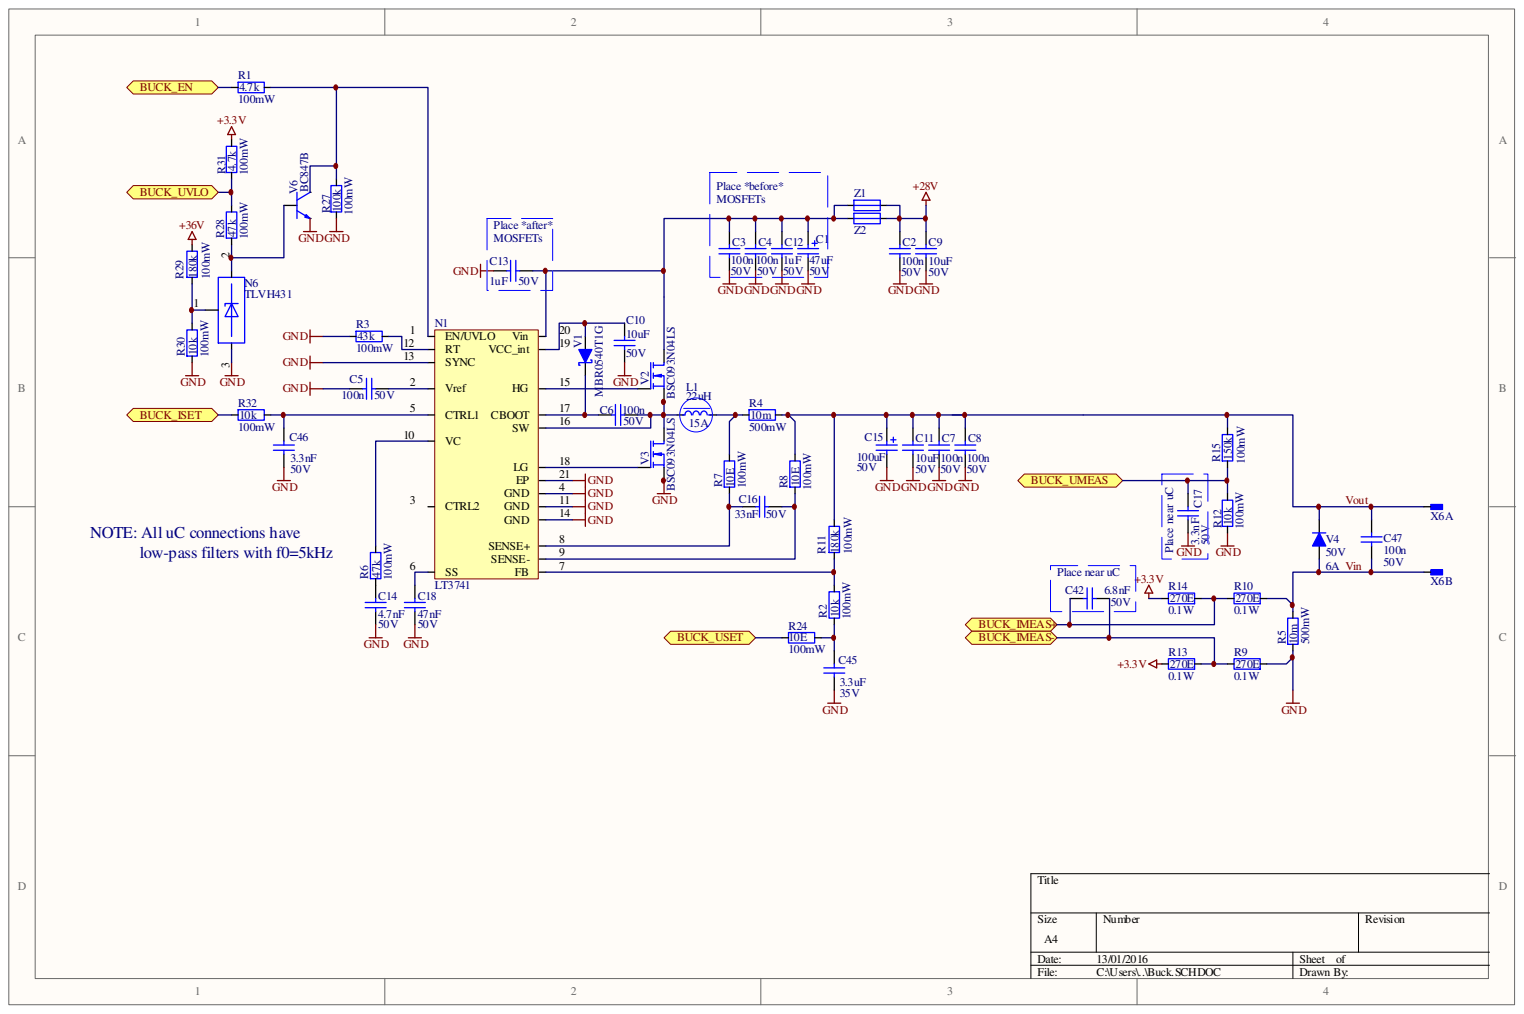
[picture p112: page 3]

NOTE: All uC connections have

low-pass filters with f0=5kHz

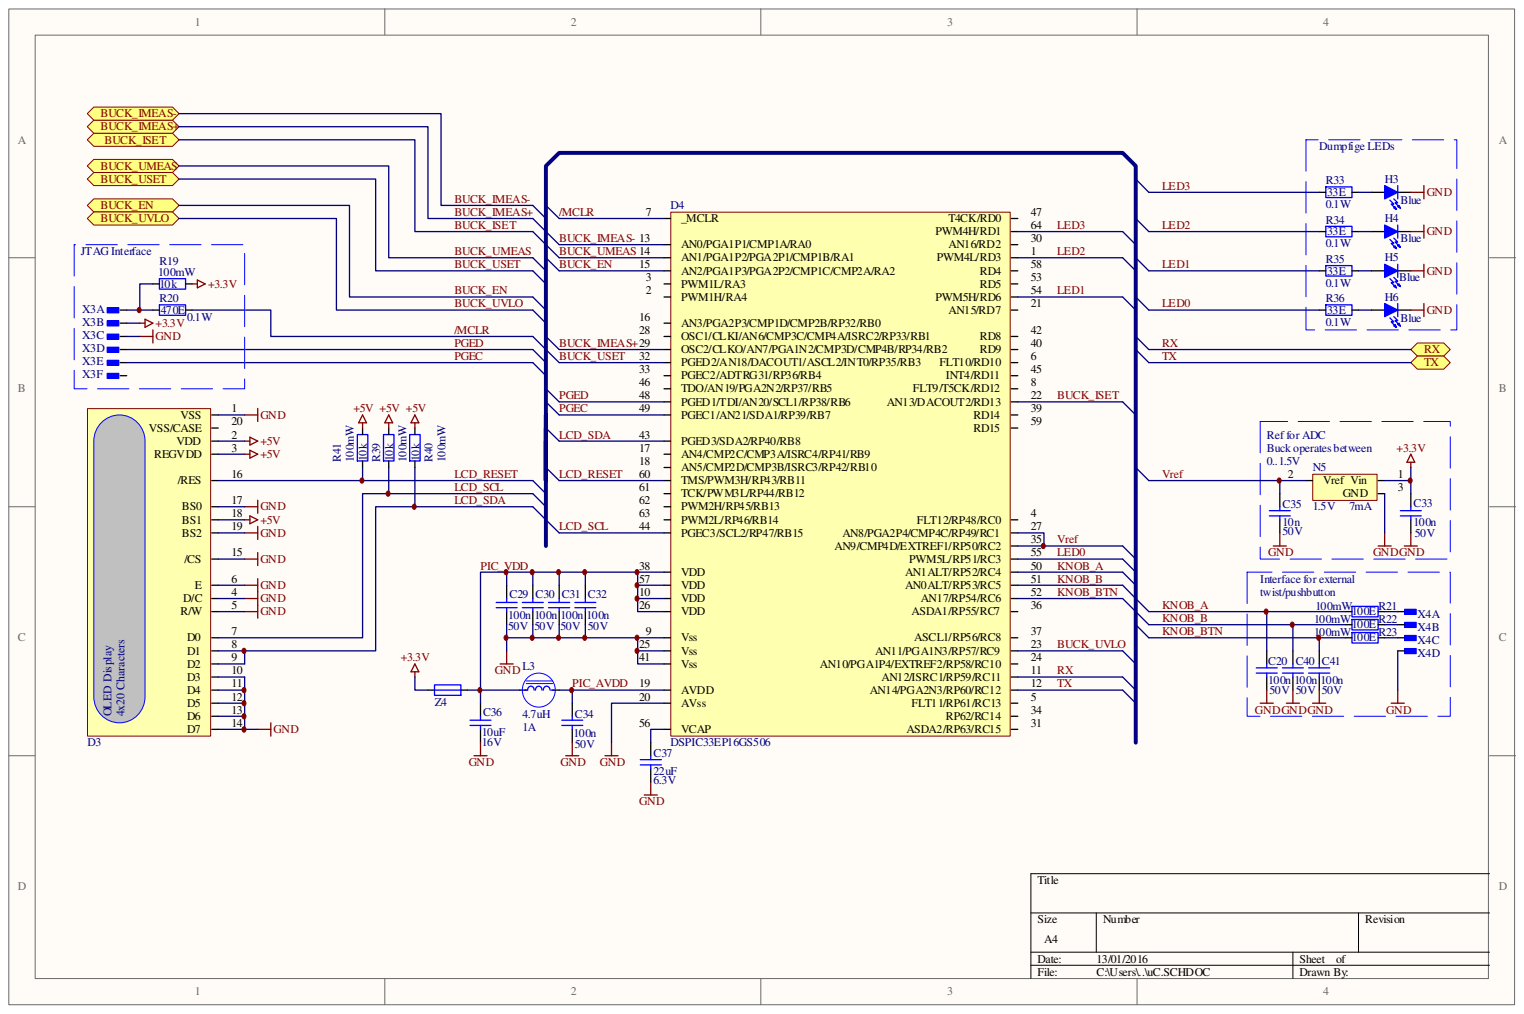
[picture p113: page 4]

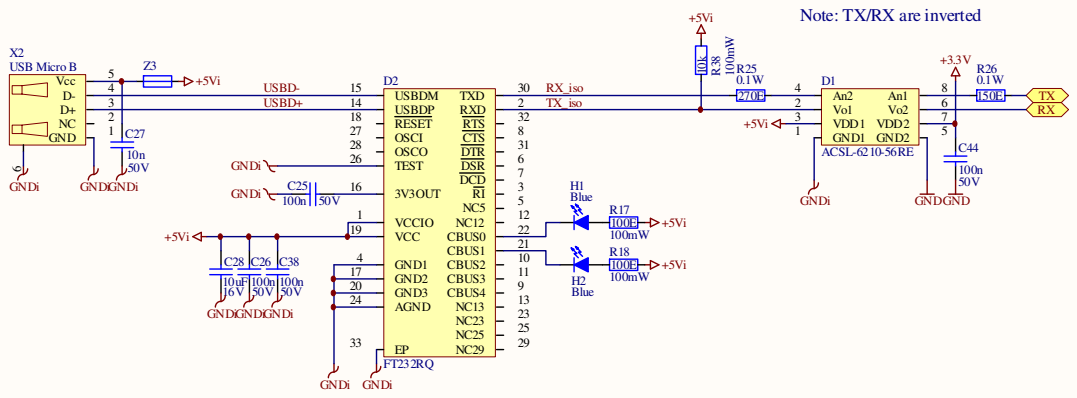
[picture p114: page 5]
