TheComet/bat6/pm/pflichtenheft/grob-blockdiagramm.pdf

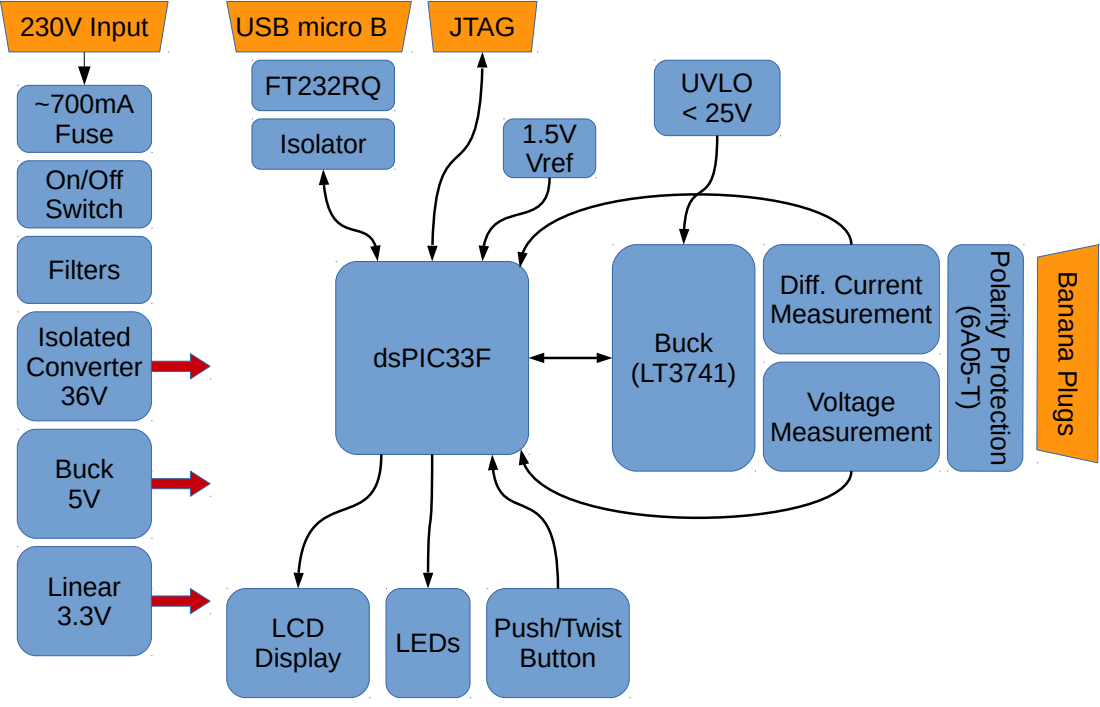
[picture p116: page 1]
dsPIC33F; Buck; Isolator; LCD Display; Push/Twist Button; Isolated Converter 36V; Buck 5V; Linear 3.3V; Voltage Measurement; Diff. Current Measurement; LEDs; USB micro B; B a n a n a Plu; UVLO < 25V; 230V Input; P ola; rit; tio; 1.5V Vref; ~700mA Fuse; Filters; JTAG; On/Off Switch
