TheComet/bat6/doc/documentation/images/circuit/buck-imeas.pdf

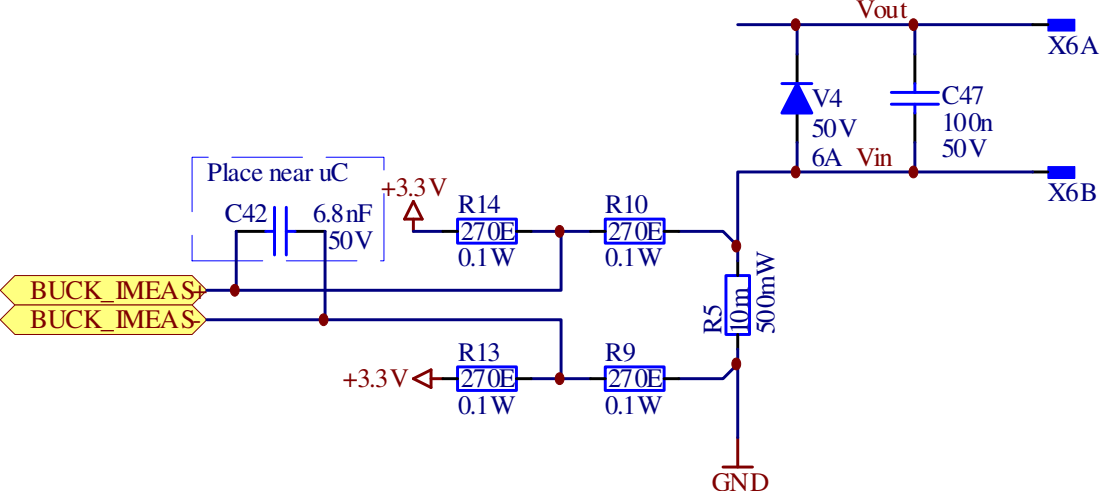
[picture p117: page 1]
GND; Vout; Vin; BUCK_IMEAS+ BUCK_IMEAS-

Place near uC
