TheComet/bat6/doc/documentation/images/circuit/uvlo.pdf

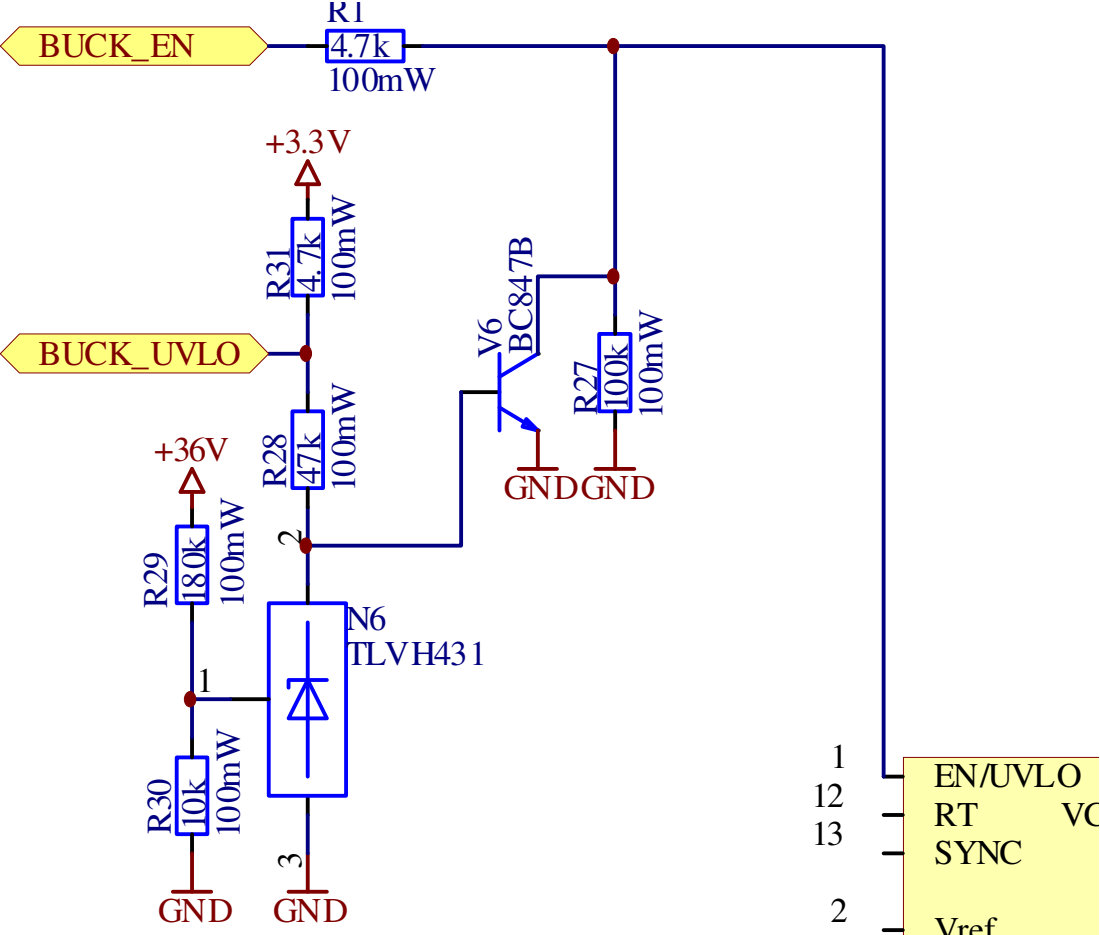
[picture p118: page 1]
EN/UVLO 1; Vref 2; SYNC 13; BUCK_EN; TLVH431; GND; GNDGND; BUCK_UVLO
