TheComet/bat6/hardware/pcb/layers/layers.pdf

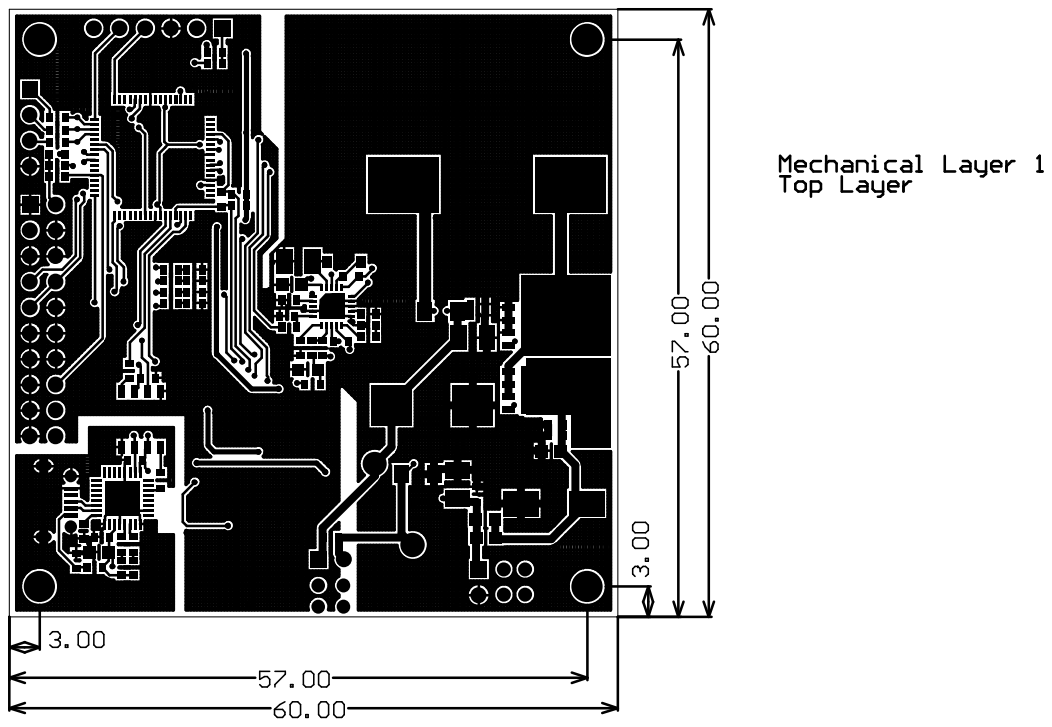
[picture p119: page 1]

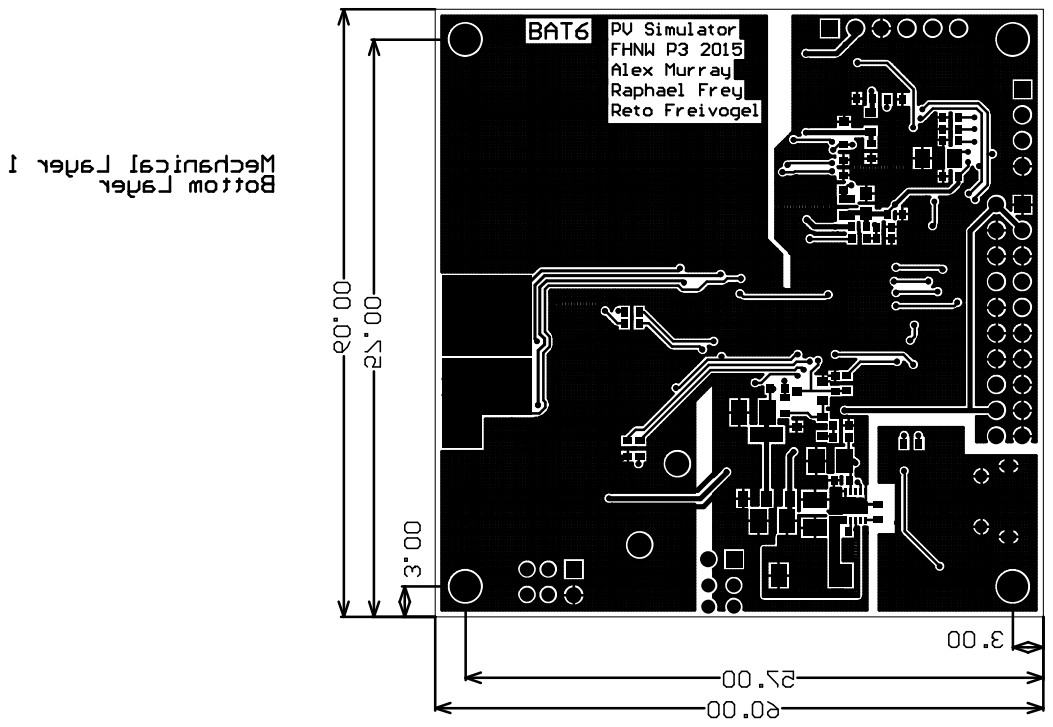
[picture p120: page 2]

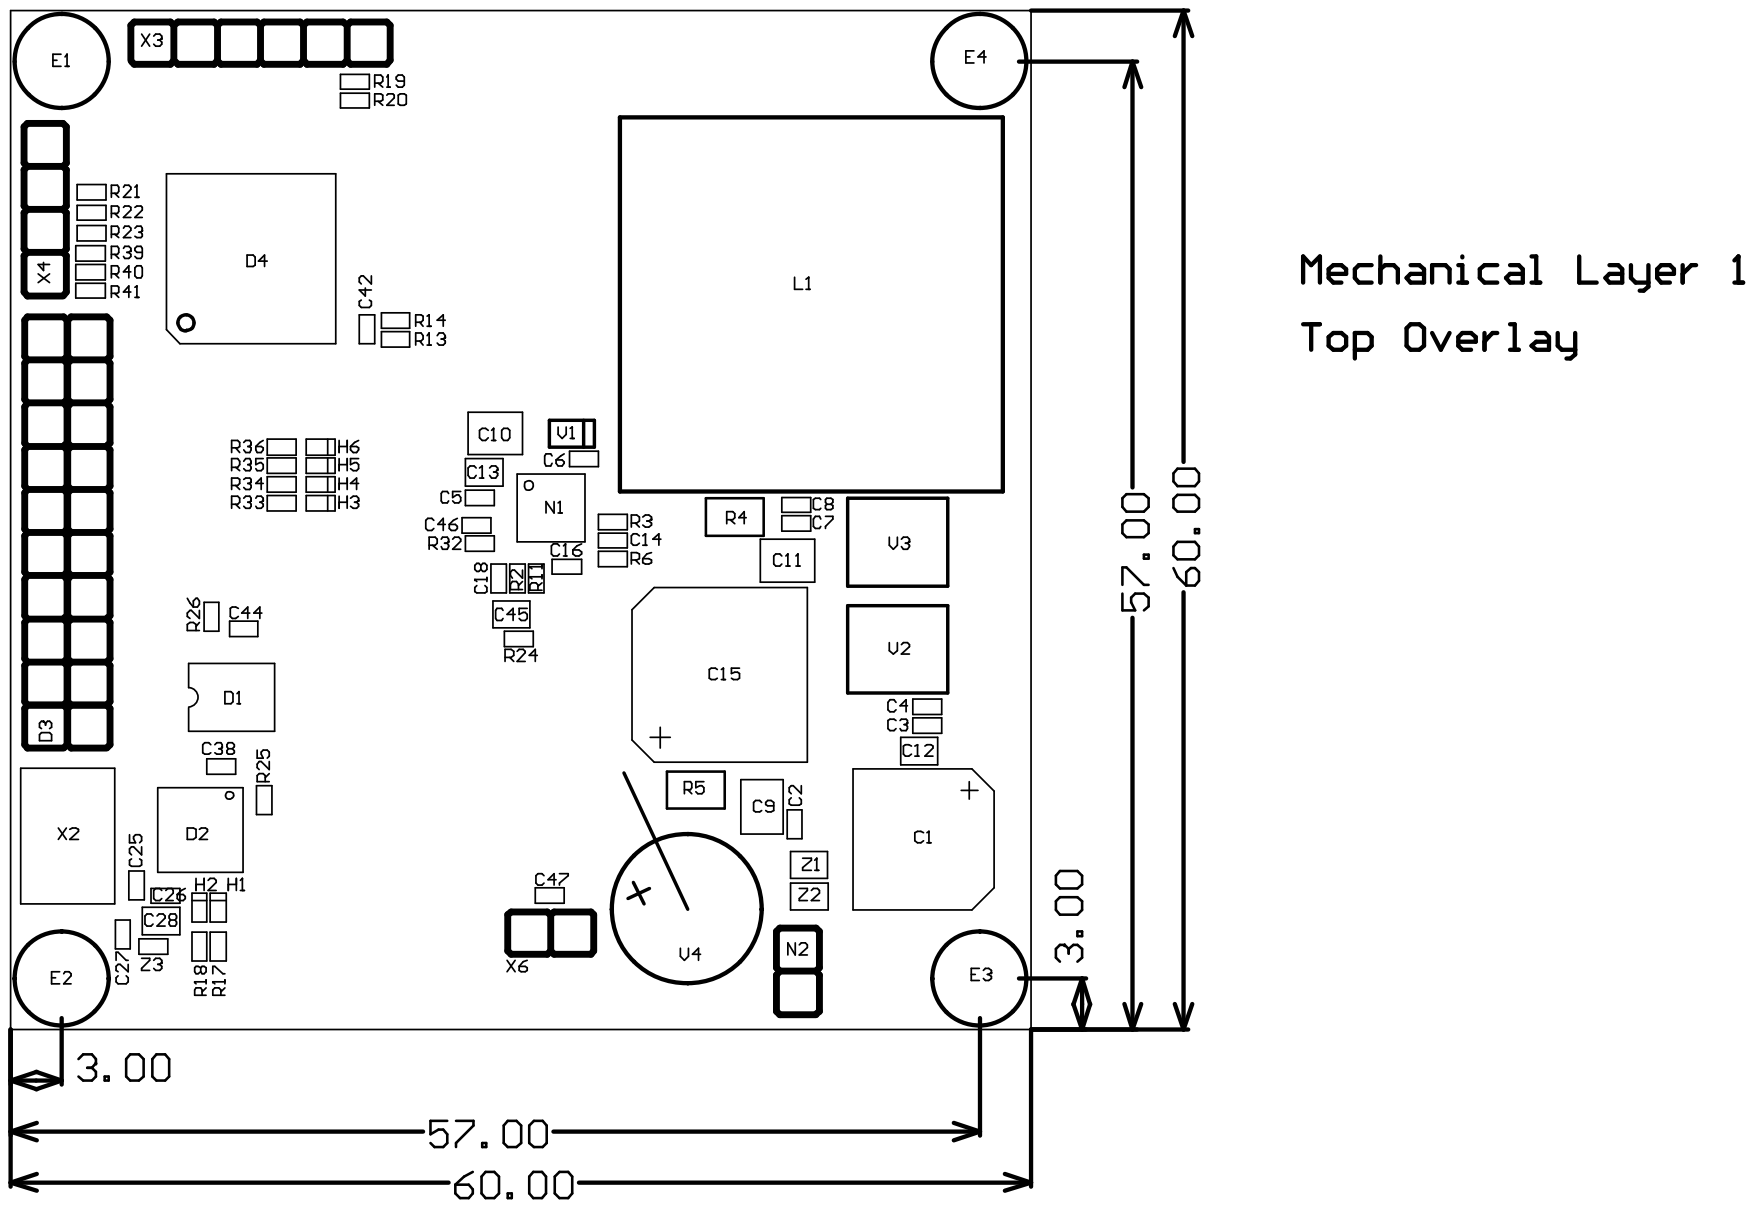
[picture p121: page 3]

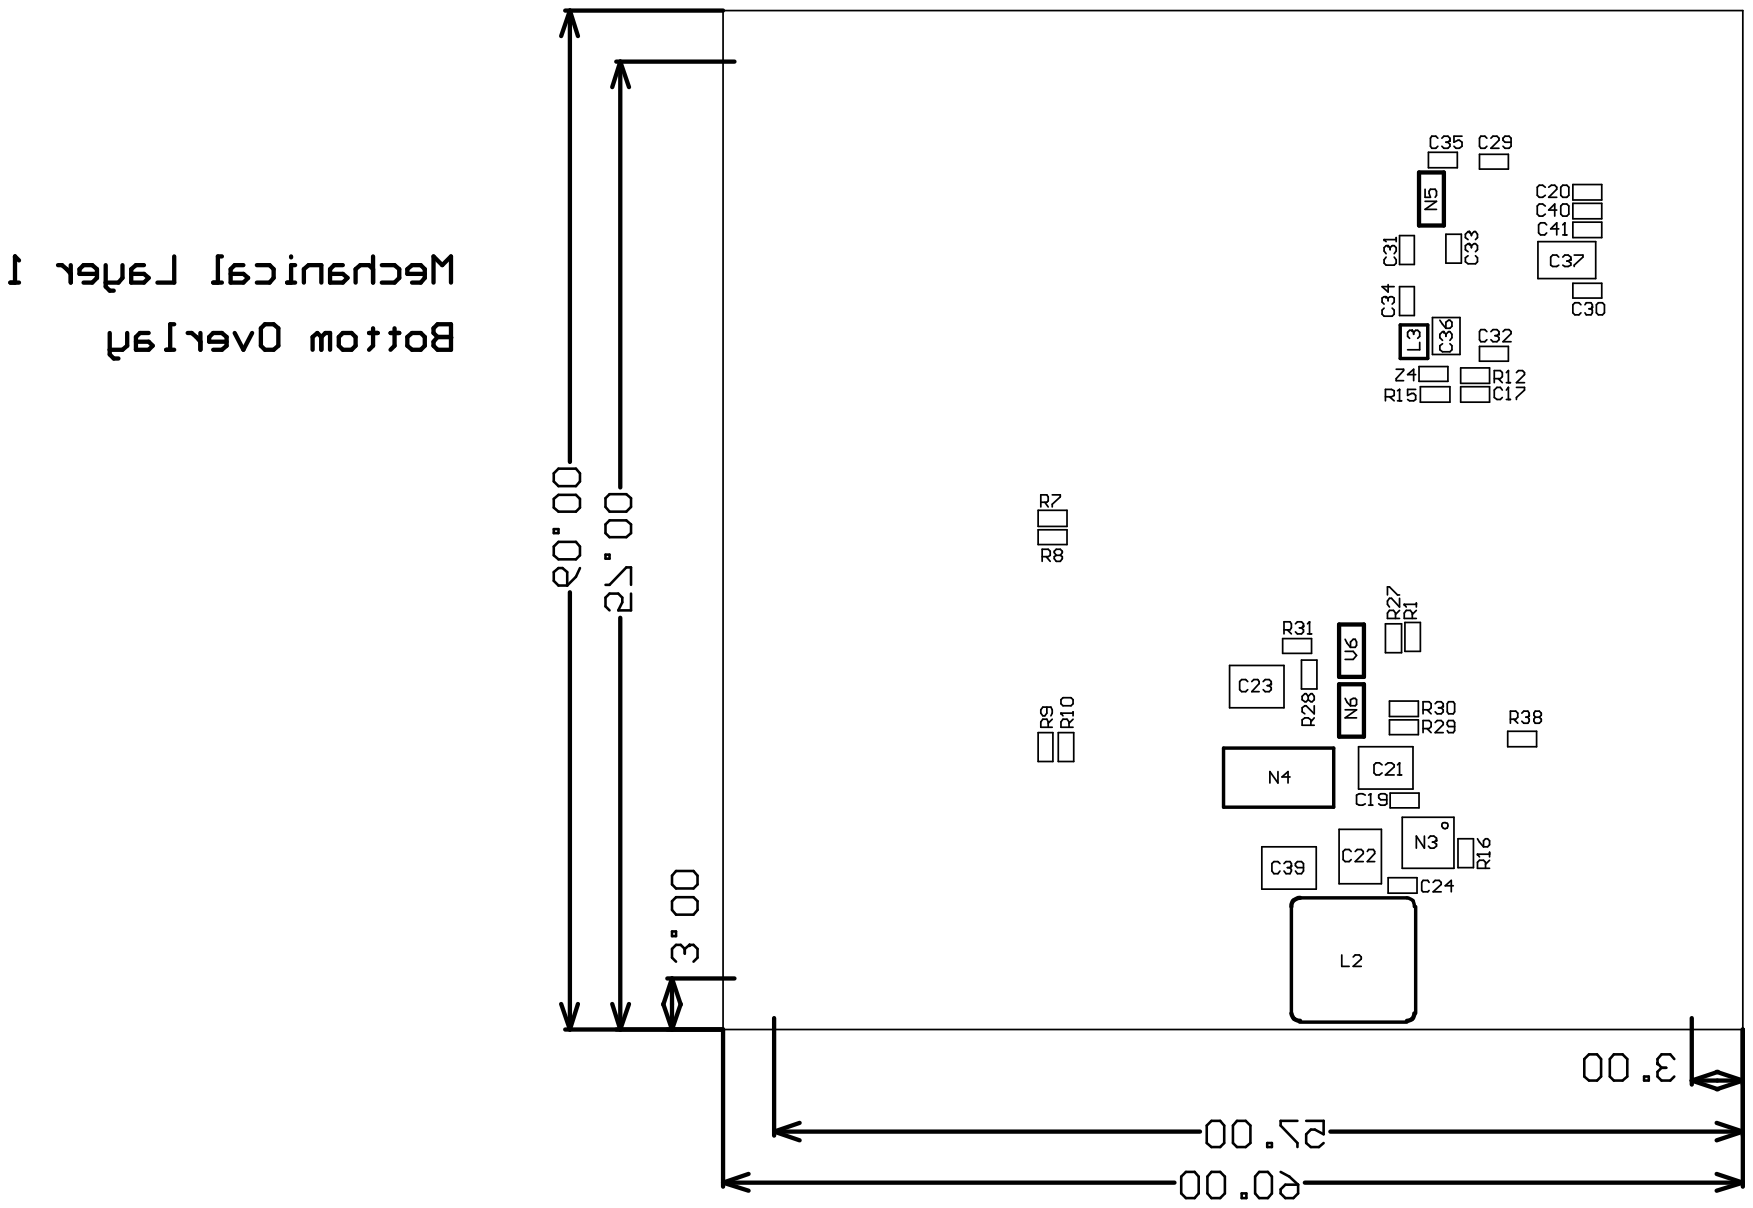
[picture p122: page 4]

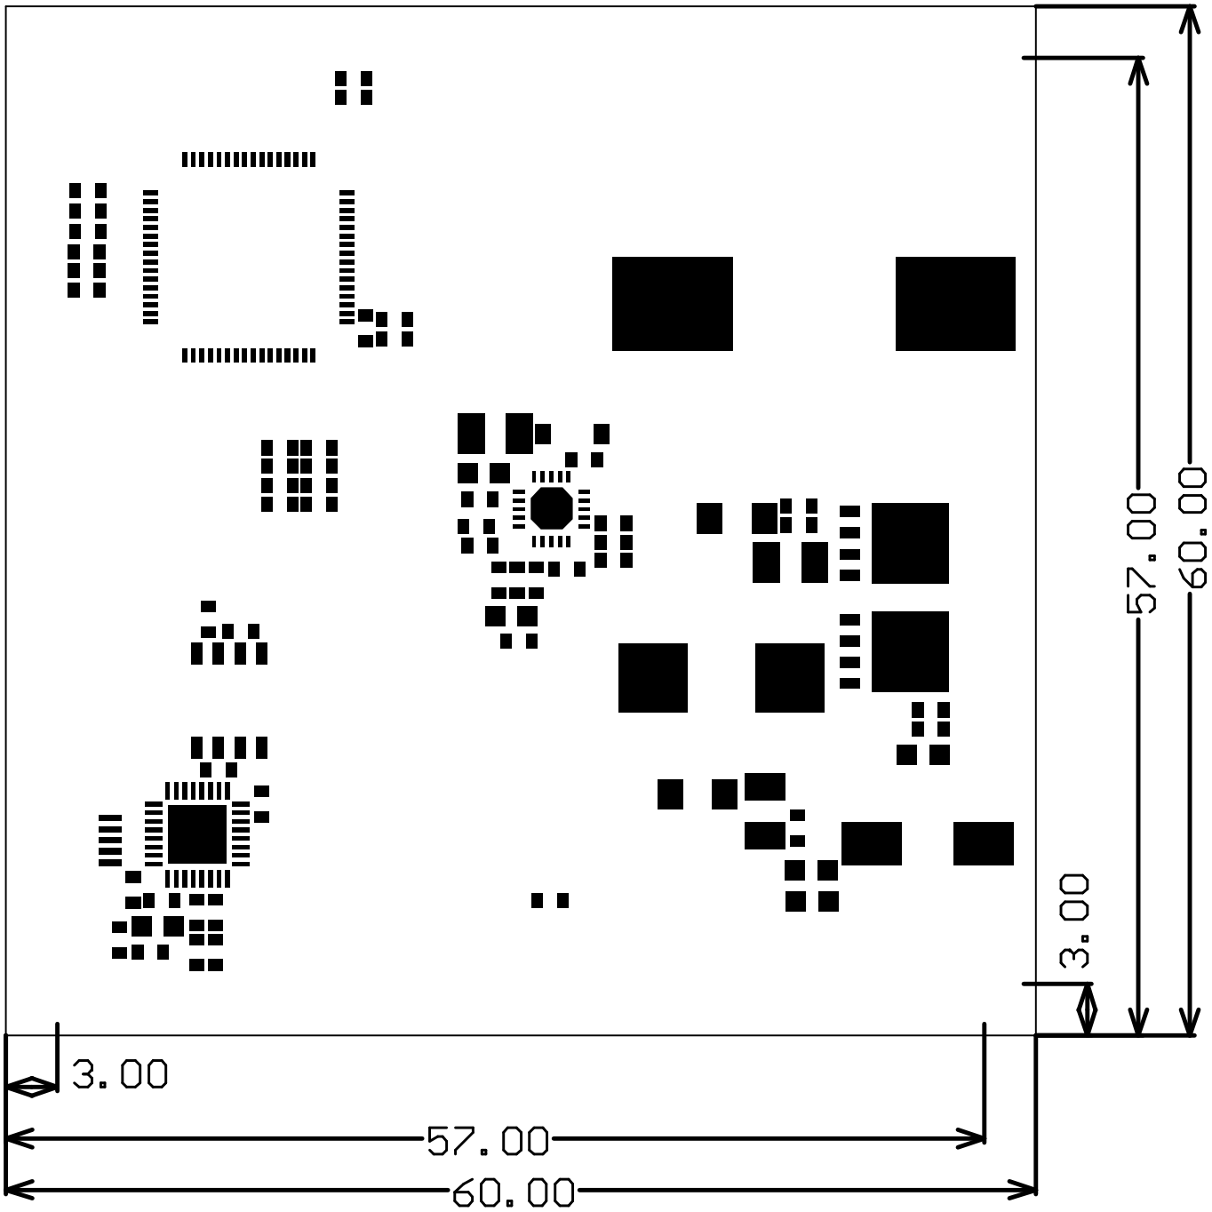
[picture p123: figure]

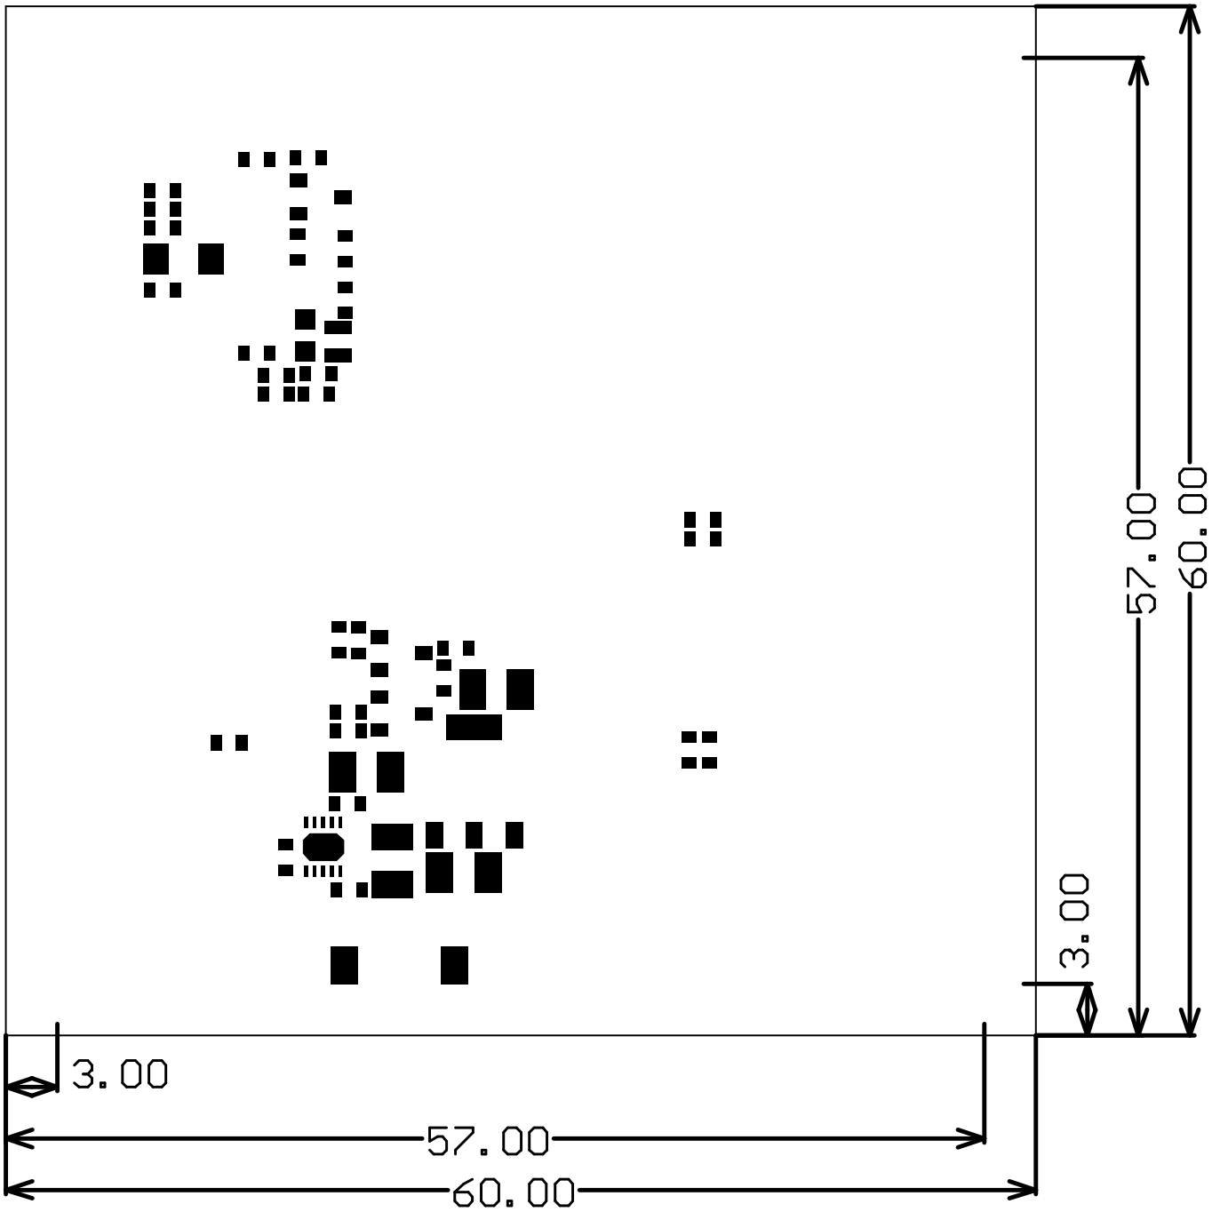
[picture p124: figure]
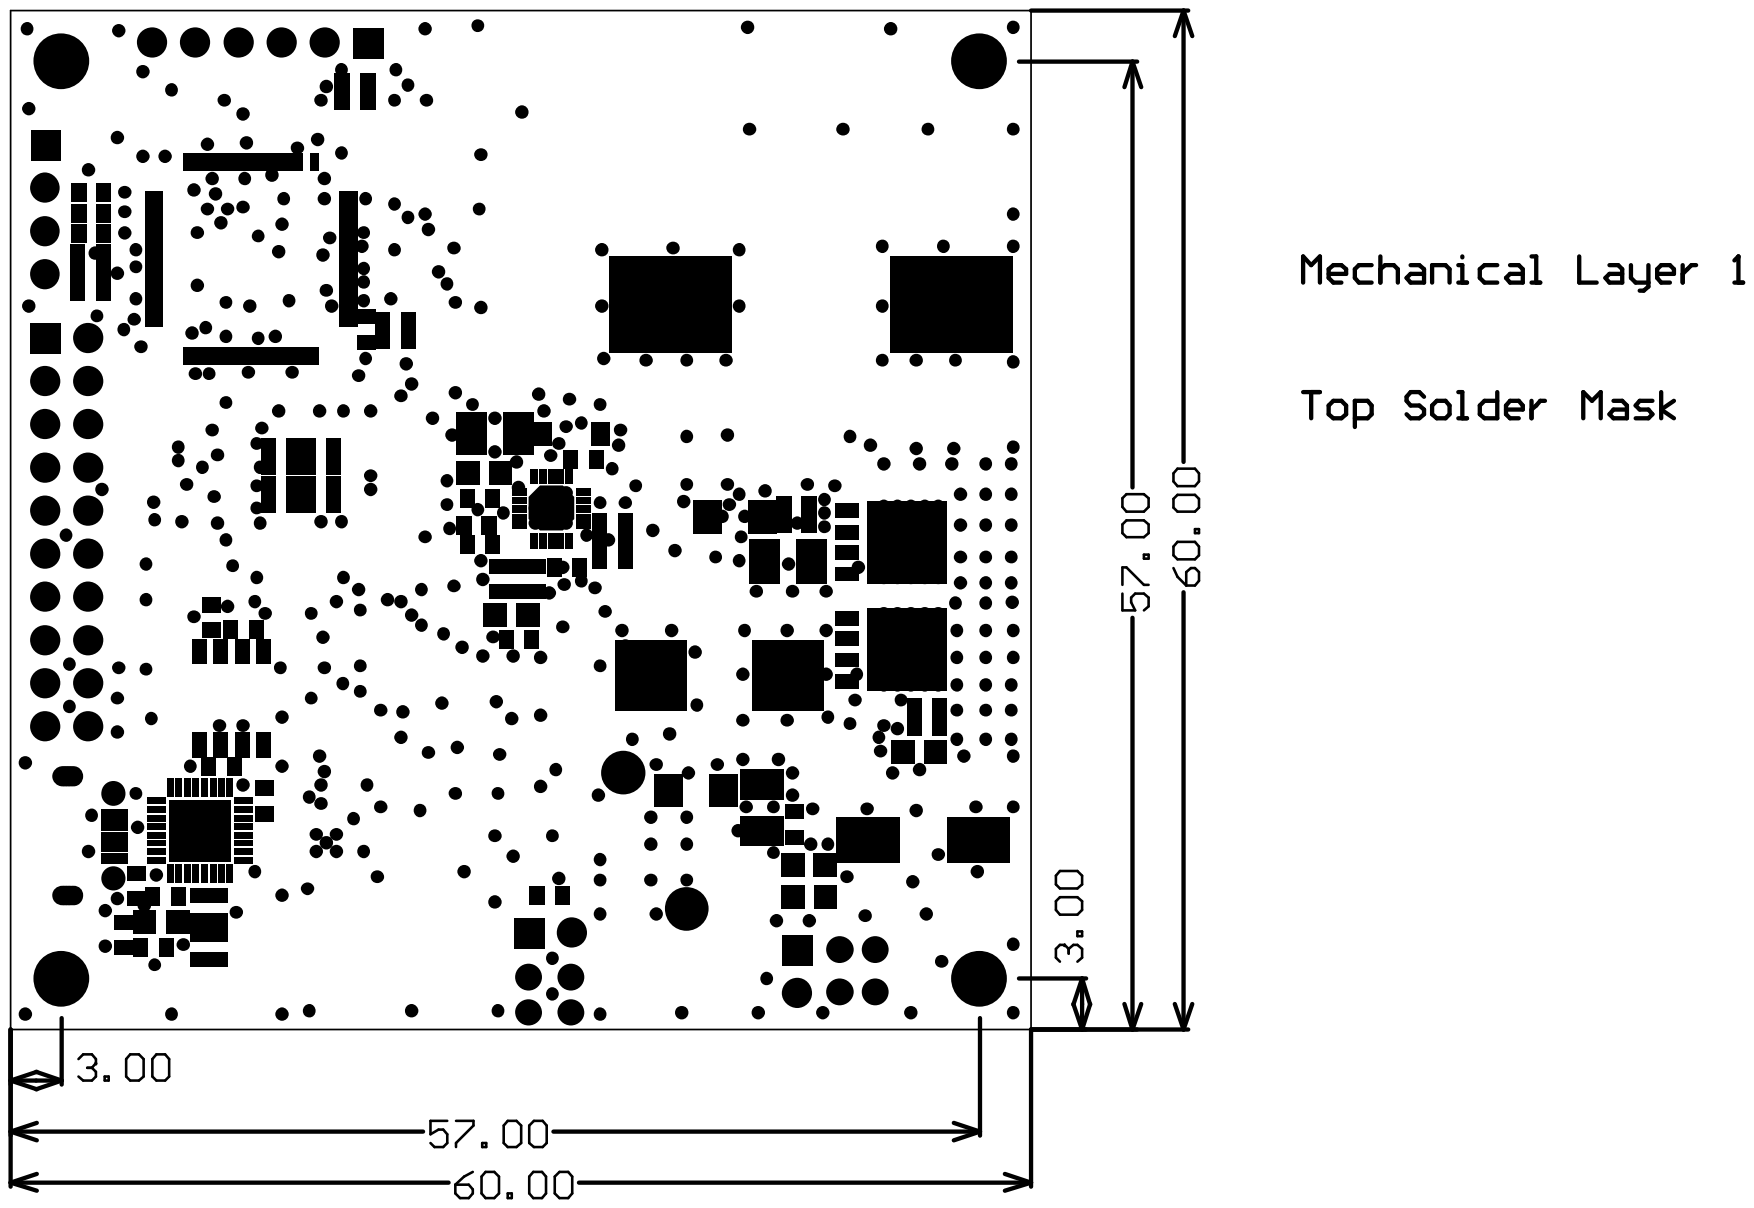
[picture p125: page 7]

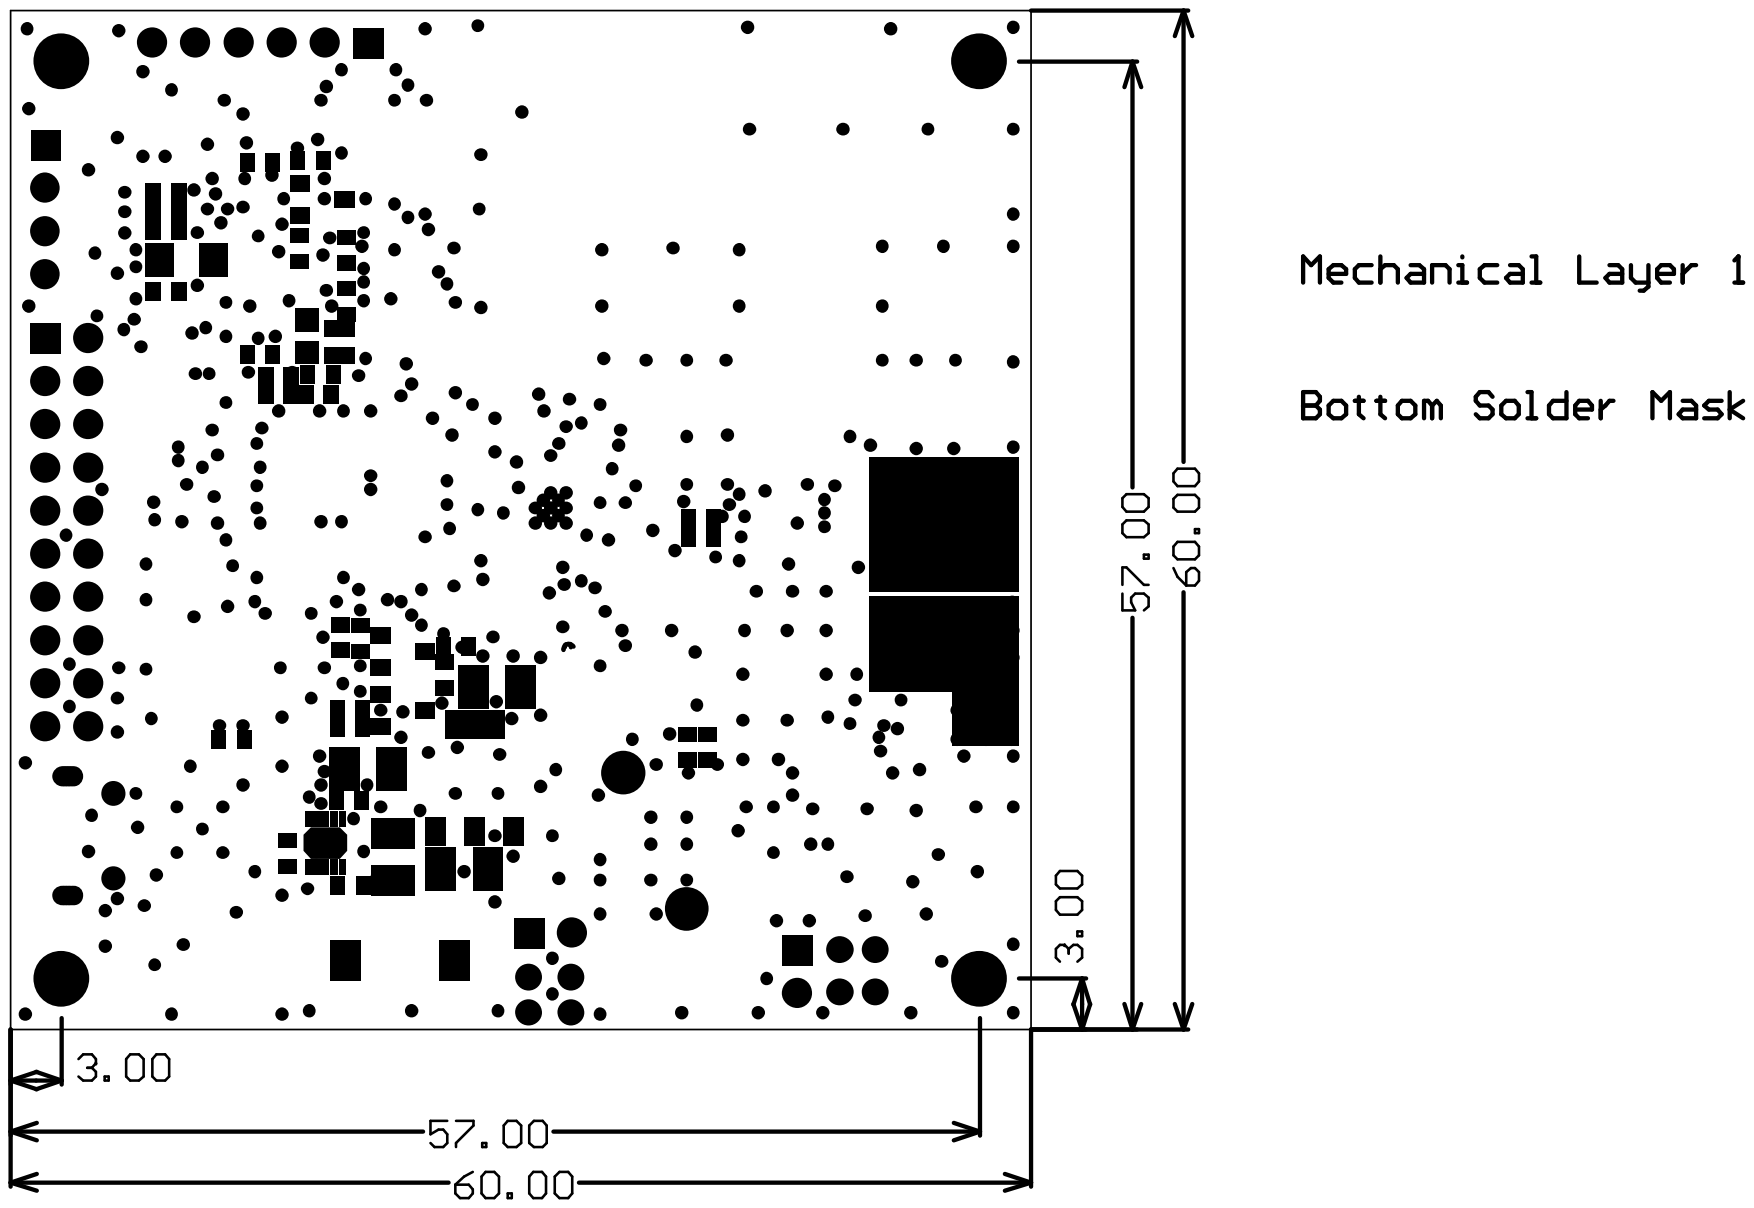
[picture p126: page 8]

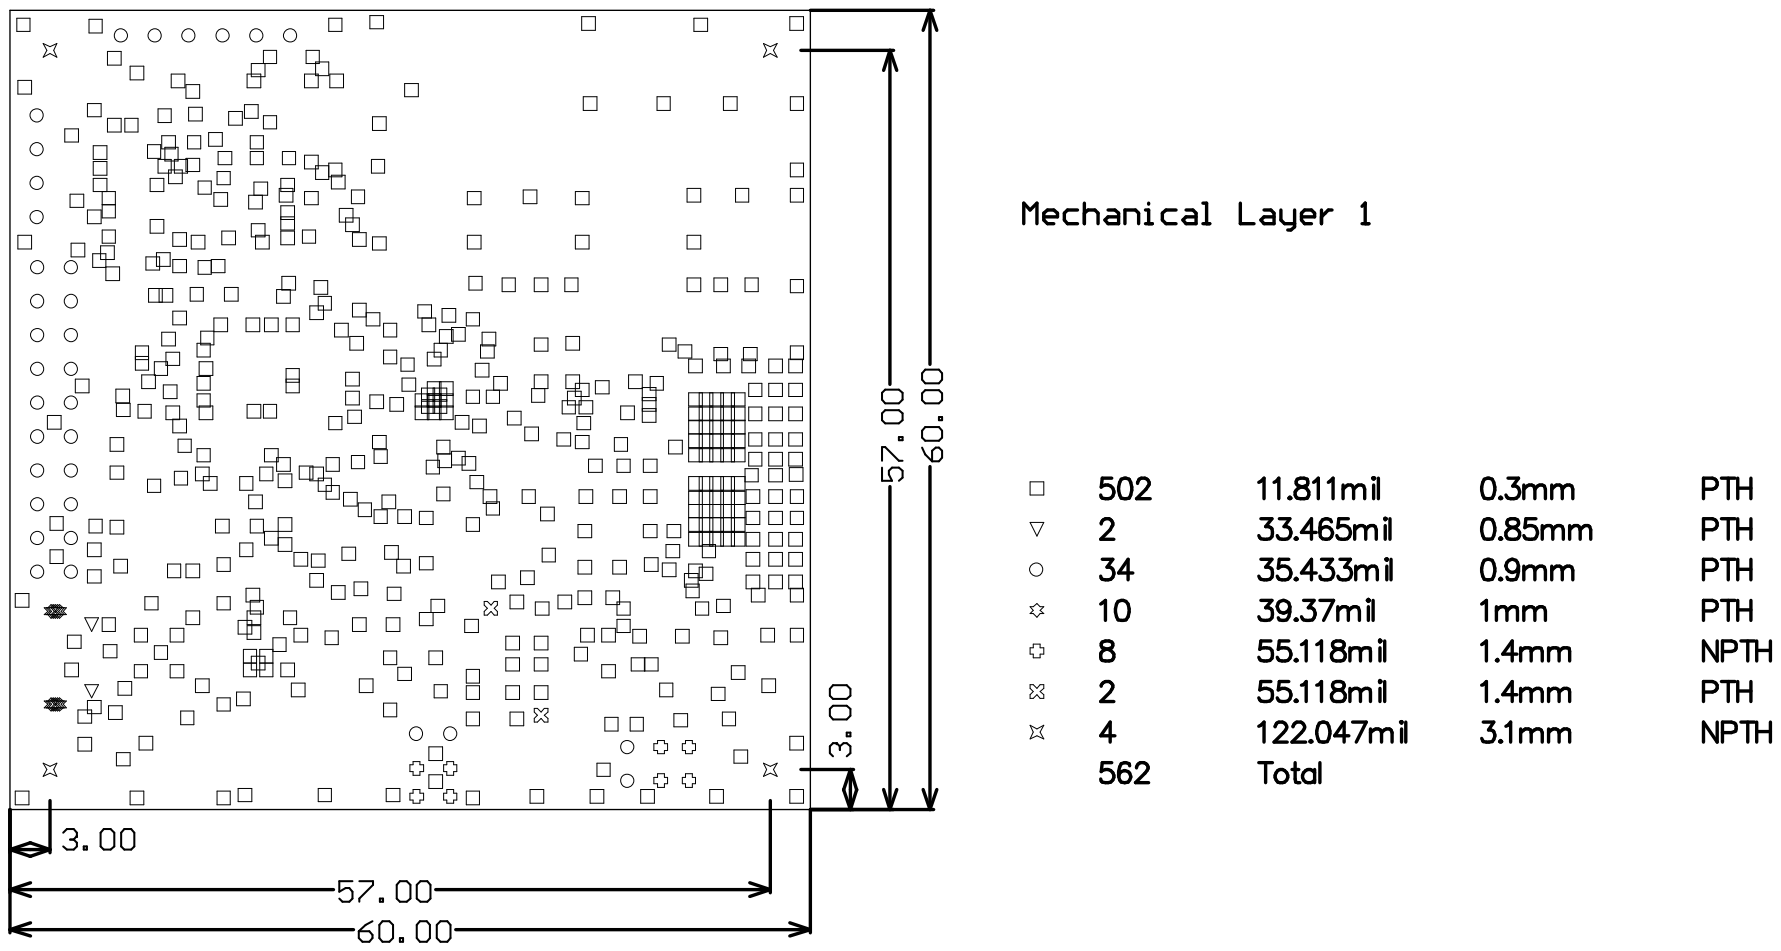
[picture p127: page 9]

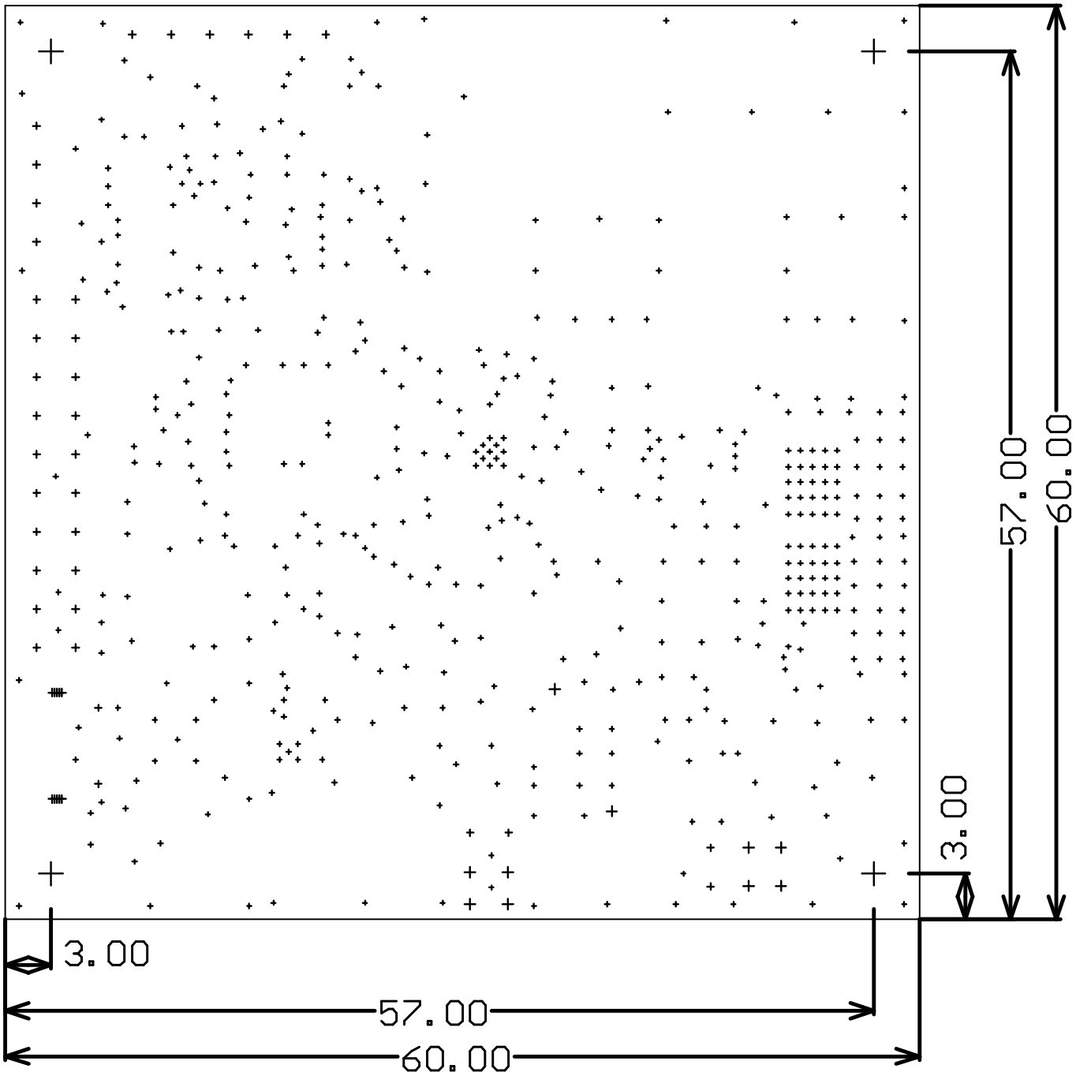
[picture p128: figure]
