TheComet/bat6/hardware/pcb/pcb/pcb.pdf

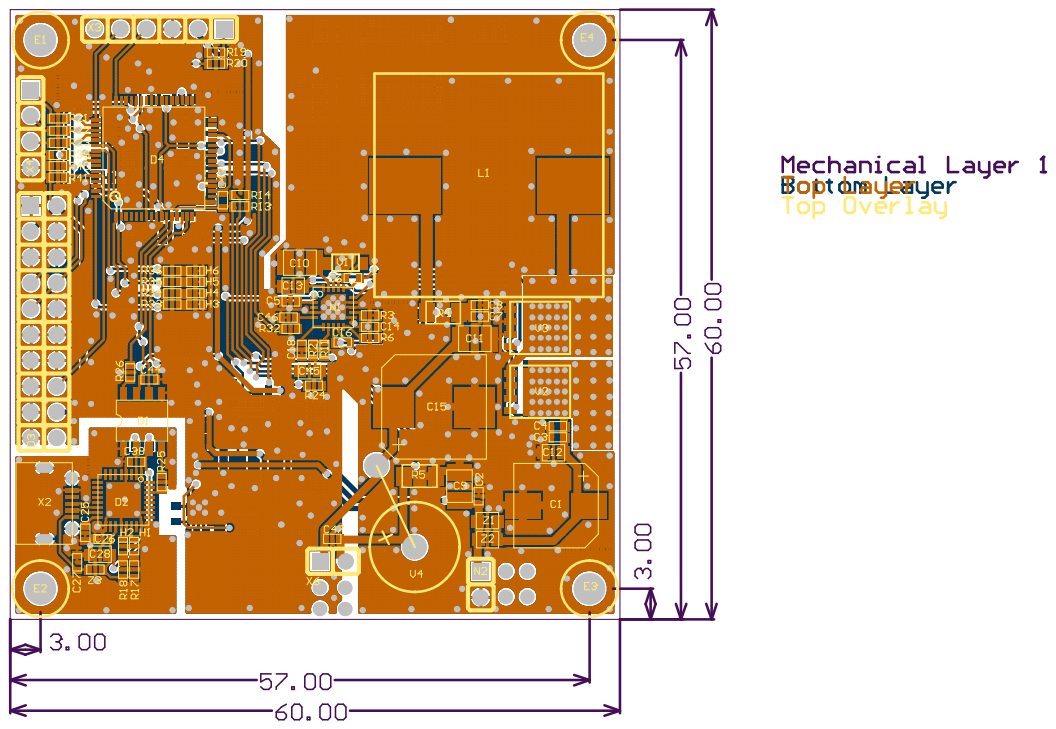
[picture p129: page 1]

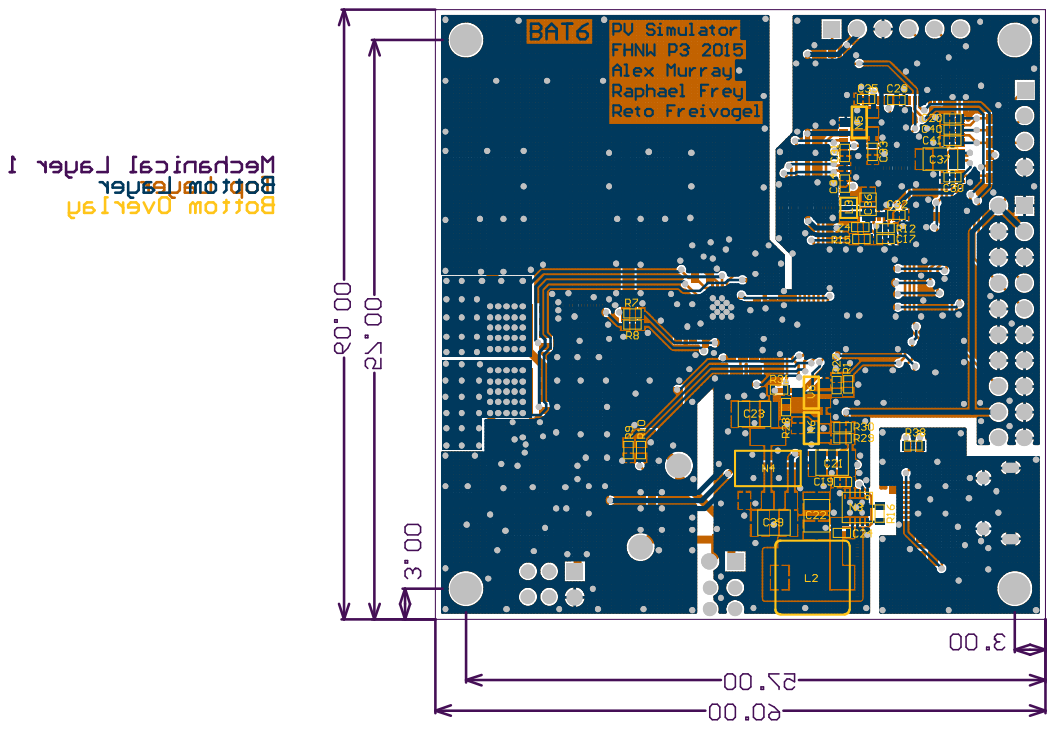
[picture p130: page 2]
