TheComet/bat6/mechanical/housing/images/netzBuchse.pdf

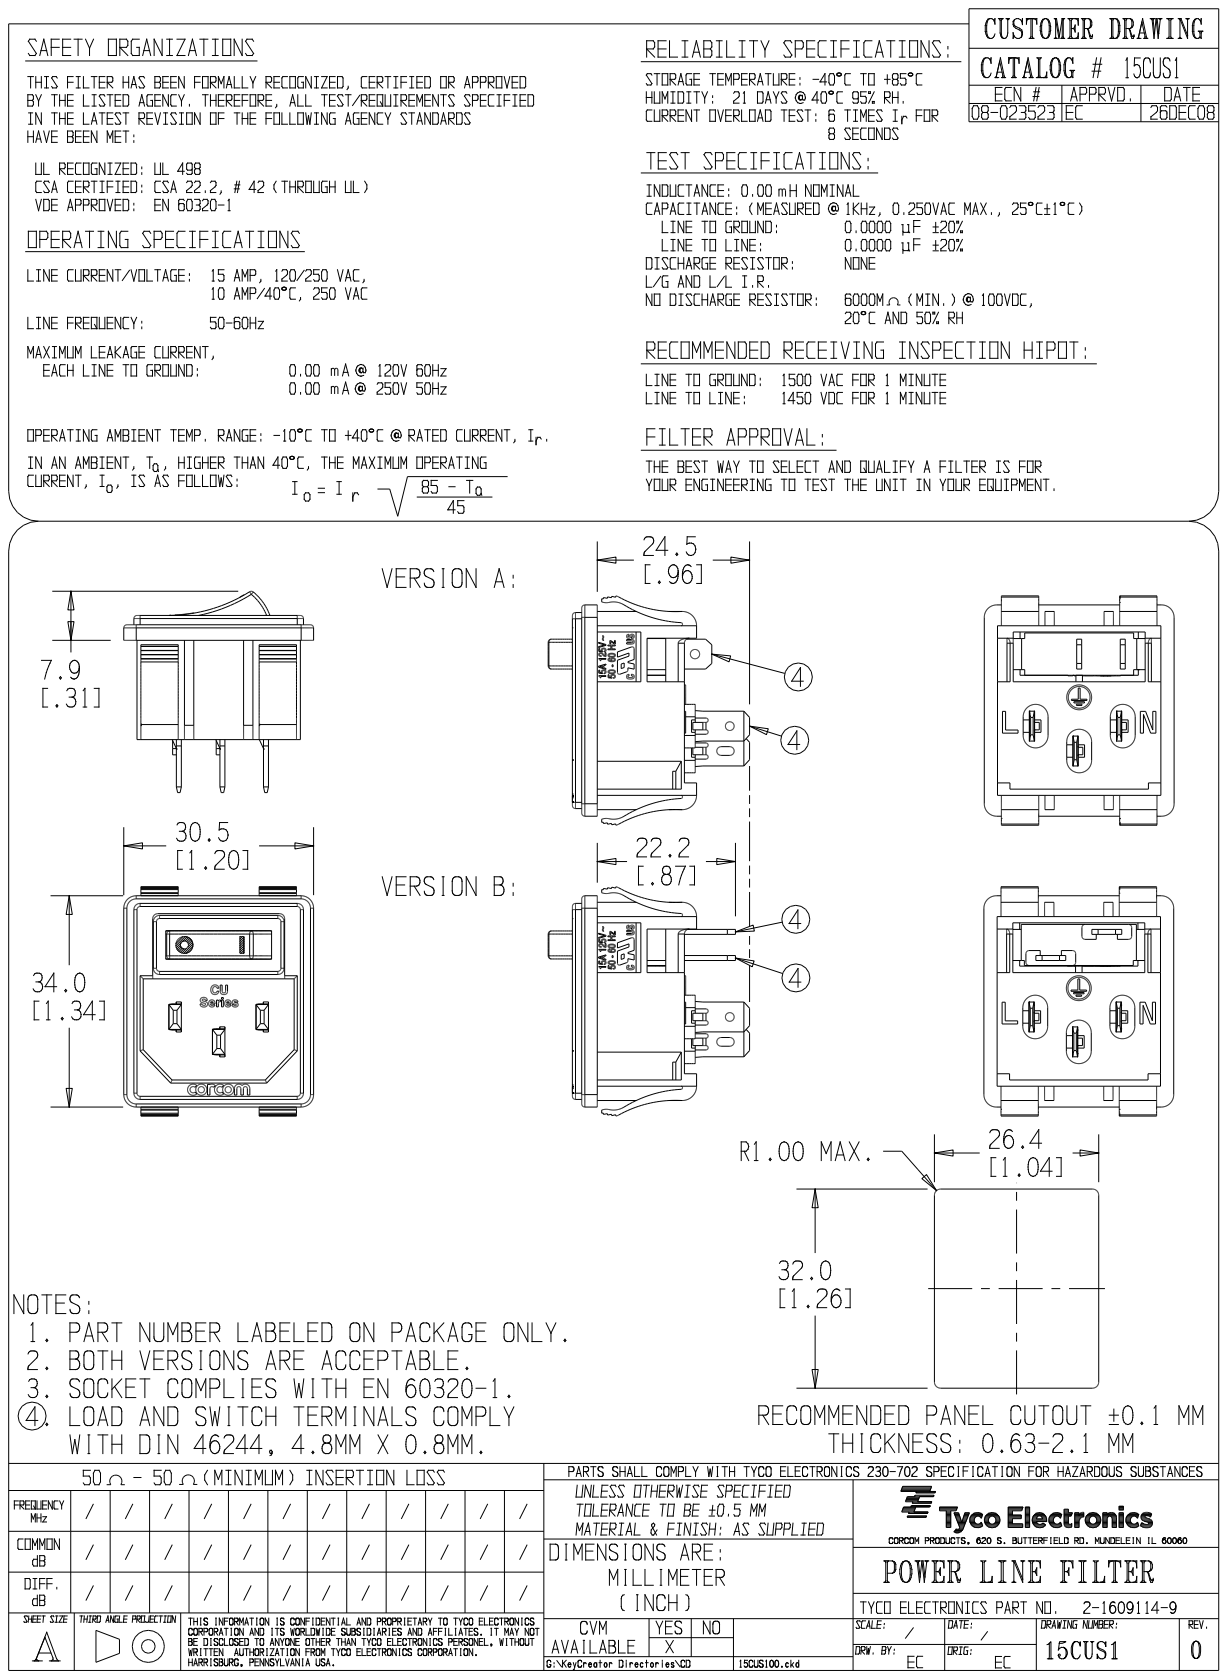
[picture p131: page 1]
