TheComet/bat6/doc/documentation/images/circuit/buck.pdf

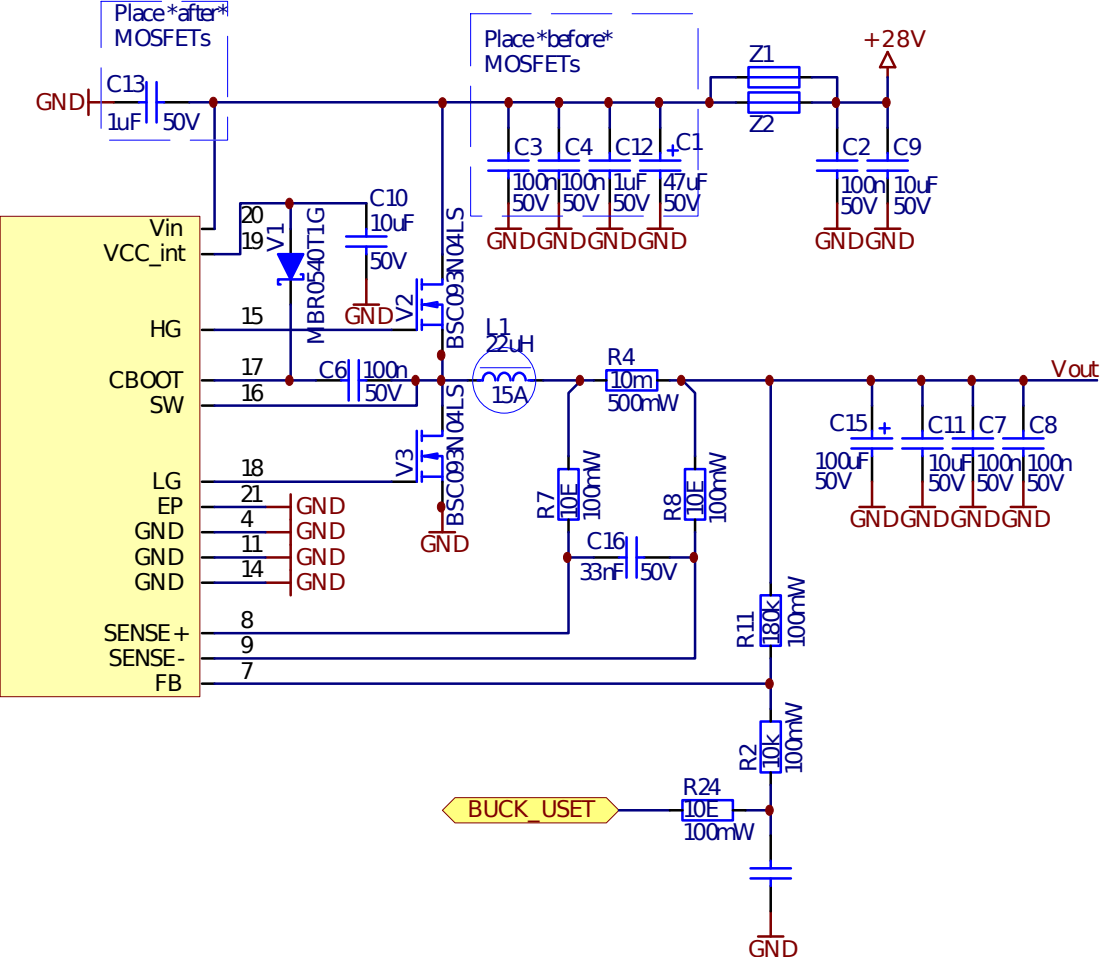
[picture p132: page 1]
