TheComet/bat6/doc/documentation/images/circuit/5v-3v-rails.pdf

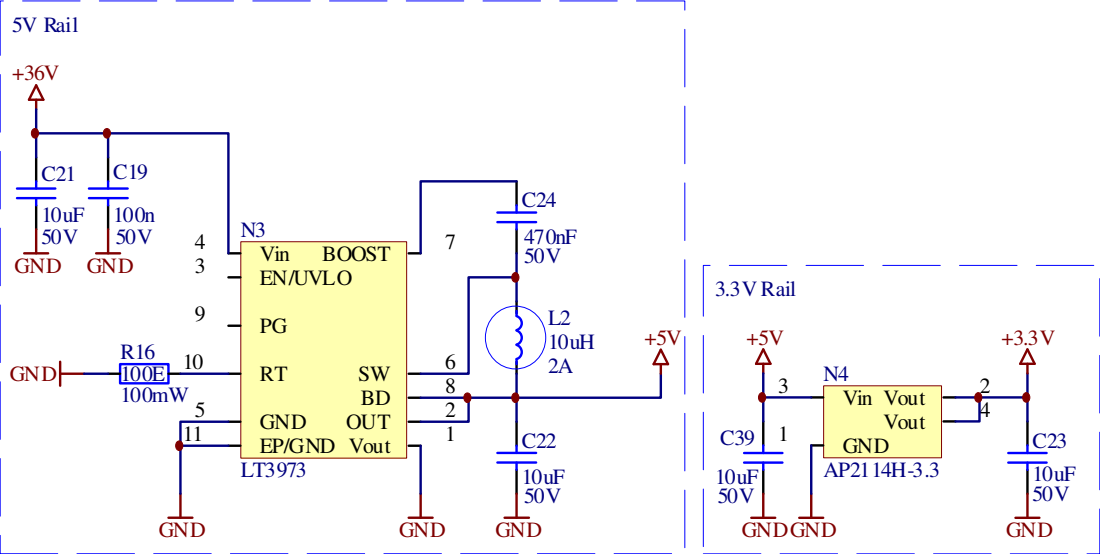
[picture p133: page 1]
