TheComet/bat6/doc/documentation/images/circuit/pcb.pdf

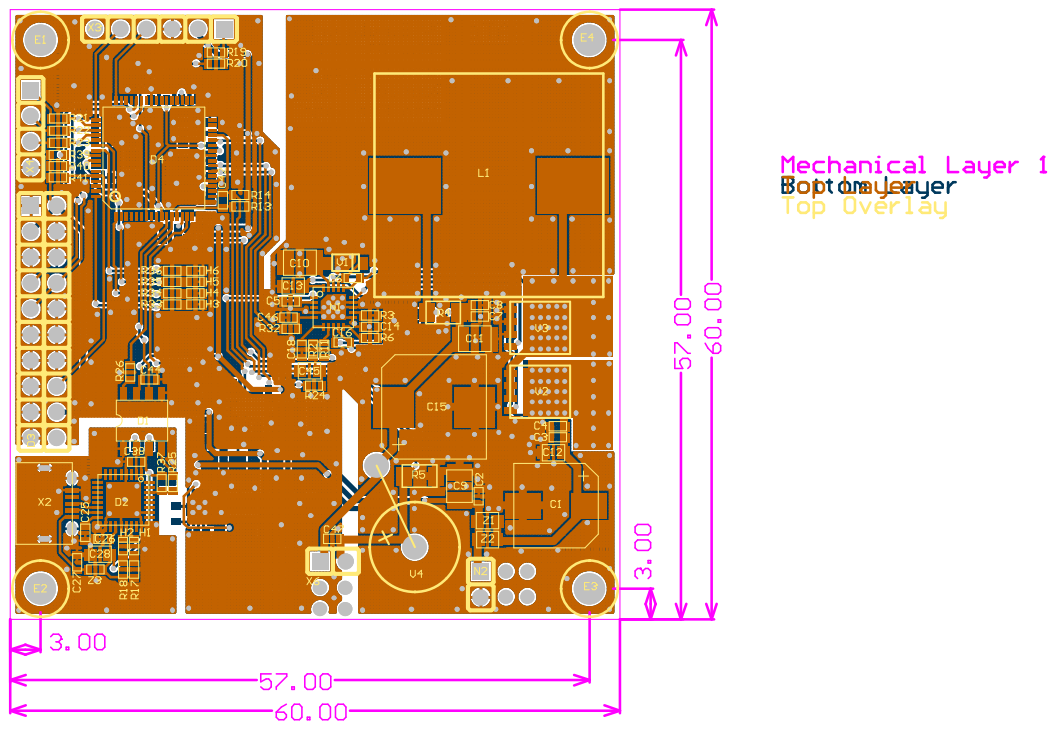
[picture p134: page 1]

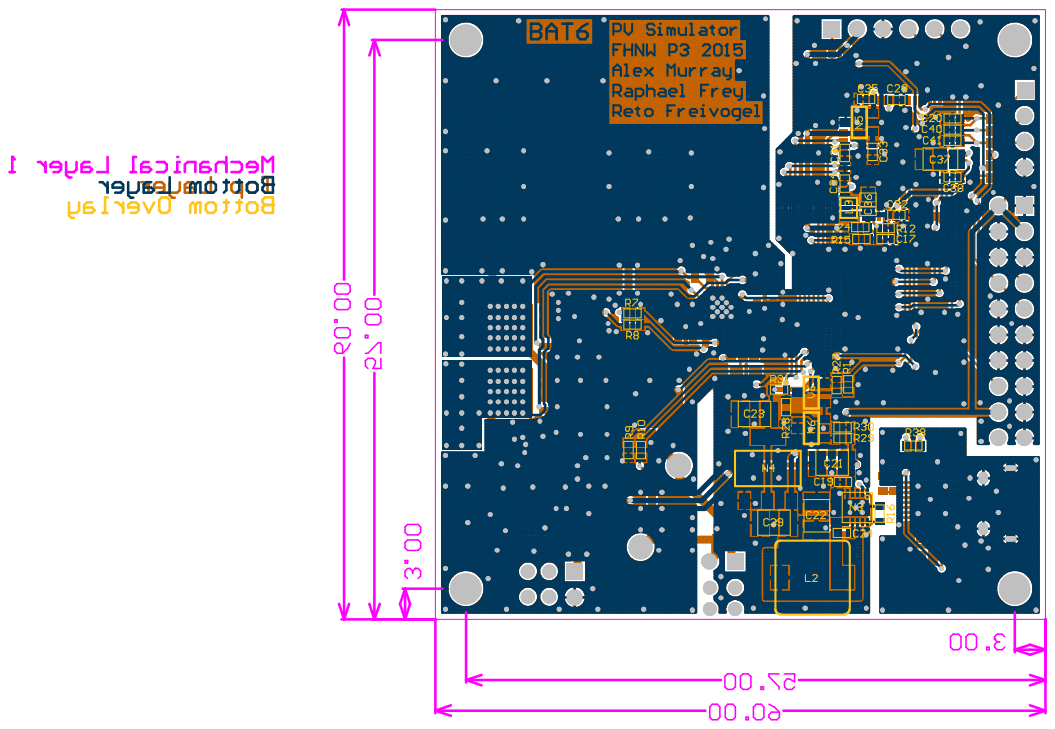
[picture p135: page 2]
