TheComet/bat6/sim/ltspice/lt3741_ripple/ripple.asc

C1: cap; 33n
C2: cap; 3.3µ
C7: cap; 10µ
C8: cap; 100n
C9: cap; 110µ
C10: cap; 5.6n; Rser=39.2K
C11: cap; .01µ
C12: cap; .01µ
D2: schottky; 1N5819
L5: ind; 22µ
Q3: nmos; Si7884DP
Q4: nmos; Si7884DP
R1: res; {R}
R2: res; 10
R3: res; 10
R8: res; 10m
R9: res; 180k
R10: res; 10k
R11: res; 43k
U2: LT3741
V1: voltage; 0
V4: voltage; 28
V5: voltage; 5
V6: voltage; 0.9
Named nets: 0
.tran 0 5m 3m startup
.step dec param R 0.1 1k 2
