TheComet/bat6/sim/ltspice/lt3741_transients/transients.asc

C1: cap; 10µ
C2: cap; 100n
C3: cap; 110µ
C4: cap; 5.6n; Rser=39.2K
C5: cap; .01µ
C6: cap; .01µ
C7: cap; 10µ
C8: cap; 100n
C9: cap; 110µ
C10: cap; 5.6n; Rser=39.2K
C11: cap; .01µ
C12: cap; .01µ
C13: cap; 10p
C14: cap; 10p
C15: cap; 10µ
C16: cap; 100n
C17: cap; 110µ
C18: cap; 5.6n; Rser=39.2K
C19: cap; .01µ
C20: cap; .01µ
C23: cap; 25p
C24: cap; 25p
D1: schottky; 1N5819
D2: schottky; 1N5819
D3: schottky; 1N5819
L1: ind; 22µ
L2: ind; 30n
L3: ind; 30n
L4: ind; 30n
L5: ind; 22µ
L6: ind; 22µ
L7: ind; 30n
L8: ind; 30n
L9: ind; 30n
Q1: nmos; Si7884DP
Q2: nmos; Si7884DP
Q3: nmos; Si7884DP
Q4: nmos; Si7884DP
Q5: nmos; Si7884DP
Q6: nmos; Si7884DP
R1: res; 10m
R2: res; 180k
R3: res; 20k
R4: res; 43k
R5: res; 50m
R6: res; 50m
R7: res; 50m
R8: res; 10m
R9: res; 180k
R10: res; 20k
R11: res; 43k
R12: res; 10m
R13: res; 180k
R14: res; 20k
R15: res; 43k
R16: res; 50m
R17: res; 50m
R18: res; 50m
R19: res; 3.3
R20: res; 3.3
R21: res; 3.3
U1: LT3741
U2: LT3741
U3: LT3741
V1: voltage; 28
V2: voltage; 5
V3: voltage; 1
V4: voltage; 28
V5: voltage; 5
V6: voltage; 1
V7: voltage; 28
V8: voltage; 5
V9: voltage; 1
Named nets: 0, SW_IDEAL, SW_REAL, SW_FIX, HG_REAL, HG_IDEAL, HG_FIX
.tran 2.25m startup
