TheComet/bat6/sim/ltspice/uvlo/uvlo.asc

Q1: npn
Q2: pnp; BC856B
Q3: npn; BC847B
R1: res; 100k
R2: res; 100k
R3: res; 10k
R4: res; 180k
R5: res; 100k
R6: res; 100k
R7: res; 100k
R8: res; 4.7k
U1: UniversalOpamp2
V1: voltage; PULSE(36 0 0 100m)
V2: voltage; 3.3
V3: voltage; 1.24
V4: voltage; PULSE(0 3.3 25m 2n 2n 25m 50m)
Named nets: 0, +36V, +3.3V, EN_LT3741, BUCK_EN, UVLO_Interrupt
.tran 200m
from dsPIC33
to LT3741
TLVH431
