TheComet/bat6/(list of files, drawings)

Other design files:
hardware/pcb/pcb/pv-simulator.PCBDOC
hardware/protel/Buck.SCHDOC
hardware/protel/PCB.PCBDOC
hardware/protel/PV-Simulator.PRJPCB
hardware/protel/PV-Simulator.SCHDOC
hardware/protel/Rails.SCHDOC
hardware/protel/UART.SCHDOC
hardware/protel/uC.SCHDOC
