TheComet/bat6/(commit log)

2015-10-05 Adding protel project files and gitignore
    [PV-Simulator.PRJPCB, Sheet1.SCHDOC]
2015-10-05 Adding datasheet of LTM8026
    [Sheet1.SCHDOC]
2015-10-05 Adding core ICs to sheet
    [Sheet1.SCHDOC]
2015-10-05 Adding grobschaetzung of cost
    [grobschaetzung-preis.ods]
2015-10-06 Doc: Loesungsansatz und Technische Daten
2015-10-08 Updated preisschaetzung with new stuff
    [grobschaetzung-preis.ods]
2015-10-15 Adding spreadsheet with LT3741 calculations. Relevant for MOSFET, Rsense and inductor selection
    [LT3741-calculations.ods]
2015-10-15 Selected MOSFET's footprint and symbol have been drawn
    [PV-Simulator.PRJPCB, Sheet1.SCHDOC]
2015-10-15 Fixed spelling mistake
    [LT3741-calculations.ods]
2015-10-16 Almost finished configuring LT3741
    [Sheet1.SCHDOC]
2015-10-16 Added another MOSFET to LT3741 calculations
    [LT3741-calculations.ods]
2015-10-16 Working on things
    [Sheet1.SCHDOC]
2015-10-16 fixes #5, #4, #3
    [Sheet1.SCHDOC]
2015-10-17 fixes #7
    [Buck.SCHDOC, PV-Simulator.PRJPCB, Rails.SCHDOC, Sheet1.SCHDOC, UART.SCHDOC, uC.SCHDOC]
2015-10-17 fixes #9
    [Rails.SCHDOC, UART.SCHDOC]
2015-10-17 fixes #11
    [PV-Simulator.PRJPCB, Rails.SCHDOC, uC.SCHDOC]
2015-10-18 Making circuit more readable
    [Buck.SCHDOC, Buttons.SCHDOC, PCB.PCBDOC, PV-Simulator.PRJPCB, PV-Simulator.SCHDOC, Rails.SCHDOC, UART.SCHDOC, uC.SCHDOC]
2015-10-18 Adding first draft of circuit (for review)
2015-10-18 Added UVLO functionality to buck converter
    [Buck.SCHDOC, Buttons.SCHDOC, PCB.PCBDOC, uC.SCHDOC]
2015-10-18 update project file?
    [PV-Simulator.PRJPCB]
2015-10-18 Newer BOM
    [grobschaetzung-preis.ods]
2015-10-19 Grouping related components
    [PCB.PCBDOC, PV-Simulator.PRJPCB]
2015-10-19 fixes #41 - 36V undervoltage event will trigger an interrupt. Also Twist/Pushbutton is layed out
    [Buck.SCHDOC, Buttons.SCHDOC, PCB.PCBDOC, PV-Simulator.PRJPCB, PV-Simulator.SCHDOC, uC.SCHDOC]
2015-10-19 Grouping all subcircuits together - need PCB size/dimensions before I can continue
    [PCB.PCBDOC, uC.SCHDOC]
2015-10-20 PCB size is 80x60
    [PCB.PCBDOC]
2015-10-21 Updated Grobschätzung
    Added Housing and Rotary Encoder. changed LCD
    [grobschaetzung-preis.ods]
2015-10-21 fixes #35 - Added reduced version of final BOM to pflichtenheft
2015-10-21 New LCD display, not wired up yet though
    [Buck.SCHDOC, Buttons.SCHDOC, PCB.PCBDOC, Rails.SCHDOC, UART.SCHDOC, uC.SCHDOC]
2015-10-22 More work on le PCB
    [Buck.SCHDOC, PCB.PCBDOC, UART.SCHDOC, uC.SCHDOC]
2015-10-22 Changed line width of arrows in grob blockdiagramm
    [grobschaetzung-preis.ods]
2015-10-22 Adding document on PCB layout considerations for high powered smps devices
2015-10-22 Re-positioning power components
    [Buck.SCHDOC, PCB.PCBDOC]
2015-10-22 paper on partioning and layout of mixed signal PCBs
2015-10-29 Schematics should be finished
    [Buck.SCHDOC, PCB.PCBDOC, PV-Simulator.PRJPCB, PV-Simulator.SCHDOC, Rails.SCHDOC, uC.SCHDOC]
2015-10-29 adding capazitator 100nanas on the output
    [Buck.SCHDOC, PCB.PCBDOC, PV-Simulator.PRJPCB]
2015-10-29 Highlight components we ended up selecting
    [LT3741-calculations.ods]
2015-10-31 Placement of high frequency/high power loops
    [Buck.SCHDOC, PCB.PCBDOC]
2015-10-31 PCB is coming along
    [Buck.SCHDOC, PCB.PCBDOC, UART.SCHDOC, uC.SCHDOC]
2015-11-01 Progress is being made
    [PCB.PCBDOC, PV-Simulator.SCHDOC, uC.SCHDOC]
2015-11-02 PCB v1.0 is finished. Needs reviewing.
    [PCB.PCBDOC]
2015-11-02 Teardropping that shit up
    [PCB.PCBDOC, PV-Simulator.PRJPCB]
2015-11-02 Exporting new schematics
2015-11-03 Less cancerous color scheme
    [PCB.PCBDOC, PV-Simulator.PRJPCB]
2015-11-03 Updating Digikey product IDs, also tweaking things on PCB (like adding vias and tweaking distances)
    [Buck.SCHDOC, Buttons.SCHDOC, PCB.PCBDOC, PV-Simulator.SCHDOC, Rails.SCHDOC, UART.SCHDOC, uC.SCHDOC]
2015-11-03 Adding final BOM
    [bom.ods]
2015-11-03 No need for buttons sheet anymore, moved to main sheet
    [Buttons.SCHDOC, PCB.PCBDOC, PV-Simulator.PRJPCB]
2015-11-04 Exporting everything
    [Buck.SCHDOC, PCB.PCBDOC, PV-Simulator.PRJPCB, PV-Simulator.SCHDOC, Rails.SCHDOC, UART.SCHDOC, bom.ods, uC.SCHDOC]
2015-11-04 components: pdf list
    [bom.ods]
2015-11-05 dumpfige memes
    [uC.SCHDOC]
2015-11-05 Removing components from bestellliste that are already available
    [bom.ods, bom.xlsx]
2015-11-05 fixes #51 - I2C is re-wired to a port that actually supports I2C
    [PCB.PCBDOC, PV-Simulator.PRJPCB, Rails.SCHDOC, uC.SCHDOC]
2015-11-05 Doc: More Sections
    On branch master
    Changes to be committed:
    new file: aufgabenstellung.tex
    new file: components.tex
    new file: conclusions.tex
    new file: grundkonzept.tex
    new file: pcb.tex
    new file: software.tex
    new file: verification.tex
2015-11-05 fixes #54 - Added pullups
    [Buck.SCHDOC, PCB.PCBDOC, UART.SCHDOC, uC.SCHDOC]
2015-11-05 Final touches
    [PCB.PCBDOC, PV-Simulator.PRJPCB, UART.SCHDOC, uC.SCHDOC]
2015-11-05 Exporting PCB data, schematics, drawings, and stuff
    [bestellung1.xlsx, bom.CSV, bom.ods, pv-simulator.PCBDOC]
2015-11-05 final PCB
    [pv-simulator.PCBDOC]
2015-11-05 labels right way up on mirrored layer
    [PCB.PCBDOC, PV-Simulator.PRJPCB]
2015-11-05 fixes #56 - Circuit excerpts
2015-11-06 Small fix to PCB
    [PCB.PCBDOC, UART.SCHDOC]
2015-11-06 Updating final PCB
    [pv-simulator.PCBDOC]
2015-11-06 PCB images
2015-11-06 Fixed PCB to meet specifications of PCB-Pool
    [PCB.PCBDOC, pv-simulator.PCBDOC]
2015-11-08 Re-exporting schematic and pcb
2015-11-08 I'm actually not sure what I'm changing here
    [PCB.PCBDOC, PV-Simulator.PRJPCB]
2015-11-09 This commit fixes the issues #59 and #60, but the PCB is already ordered, so this will only resolve future orders of the PCB
    [PCB.PCBDOC, uC.SCHDOC]
2015-11-09 Wrote section on MOSFET selection
2015-11-09 Compared order against our BOM - added crosses to all components that have safely arrived
    [bom.ods]
2015-11-10 Adjusting values of R9, R10, R13 and R14 -- they were too large
    [Buck.SCHDOC, PCB.PCBDOC]
2015-11-10 fixes #61 - Adjusting BOM
    [bom.ods]
2015-11-11 fixes #26 - Clock module configured for 60 MIPS
    [init.c, main.c]
2015-11-12 BUCK_EN and LCD_RESET is configured
2015-11-13 Adding uart source and headers
2015-11-14 button press interrupt config
2015-11-14 adding PCB photos from PCB-pool
2015-11-14 Button interrupts and event posting
2015-11-15 Added 10ms timer
2015-11-15 10ms timer posts EVENT_UPDATE
2015-11-15 T4 interrupt clears IF
2015-11-16 No need for button_init()
2015-11-18 Fucked up one of the pads (but it doesn't matter because it's not being used)
    [PCB.PCBDOC, pv-simulator.PCBDOC]
2015-11-22 Fixed algorithm for calculating current of cells in series
2015-11-23 Refactoring plot widgets, changed model to be temperature dependent (thanks Freebird)
2015-11-23 housing: front plate
2015-11-24 Adding datashit for mosfet
2015-11-25 UART: temporary CTS pin in hw.h
2015-11-25 uart: anal rapage
2015-11-26 use mplab fixed point
    [main.c]
2015-11-26 uart: set pins to digital
2015-11-27 Interrupt signal
2015-11-27 Restructuring/renaming some folders
    [Buck.SCHDOC, PCB.PCBDOC, PV-Simulator.PRJPCB, PV-Simulator.SCHDOC, Rails.SCHDOC, UART.SCHDOC, bestellung1.xlsx, bom.CSV]
2015-11-28 english: push twist button
2015-11-28 uart: hardware seems to work
2015-12-03 Implemented Buck driver
2015-12-03 Fixed baud rate and inverted TX and RX signals
    [uart.c]
2015-12-04 Adding gmock/gtest unit testing framework and dsPIC 'emulation'
2015-12-04 Adding global testing environment and example test to uart
2015-12-04 Getting unit tests to compile -- switched to 'unsigned int' instead of 'void*' for event argument
2015-12-04 Fixed a bug where the wrong event was extracted from the ring buffer during event_process_all()
    [event.c, uart.c]
2015-12-04 Wrote unit tests for button
2015-12-05 uart unit tests passing
2015-12-05 Unit tests in buck
2015-12-05 Event system is de-init'd in SetUp() instead of in TearDown()
2015-12-06 Translating rails
2015-12-06 uart: init refactoring
2015-12-06 uart: push for code collaboration
2015-12-06 Button posts 'long press' events when held down for more than 0.5 seconds
2015-12-09 Translated rails
2015-12-09 Translated bypass capacitors
2015-12-09 Translated switching frequency
2015-12-10 working on translating mosfet
2015-12-12 fixes #68, fixes #71, fixes #69 - UART transmit queue + tests written
    [uart.c]
2015-12-12 fixes #90 - model -> cell
    [uart.c]
2015-12-12 Switching to Qwt6 instead of Qwt5
2015-12-12 Translated mosfet selection
2015-12-13 [leds] configuration of PWM modules and pins
2015-12-14 Trying to get I2C to work
2015-12-16 implemented lcd driver
2015-12-16 [button] fixed long press event
    [button.c, hw.c, lcd.c]
2015-12-17 Button released event
2015-12-17 Pressing button longer and then releasing doesn't post BUTTON_RELEASED
    [button.c]
2015-12-17 Twisting button selects items in the menu
2015-12-17 Debugged menu, added hysteresis to button twist.
2015-12-18 [menu] Selection no longer wraps around
    [button.c]
2015-12-18 Updating API, UART protocol has been defined on paper
2015-12-18 uart_send() now just accepts strings without length
2015-12-18 Reducing latency of longer button presses
2015-12-21 state machine: ready for fixing
    [uart.c]
2015-12-22 Lots of string fixing in menu
    [libq.cpp, libq.h]
2015-12-26 Console sends data to device and *should* also receive data
2015-12-26 LEDs all work now. Fixing a few other things here and there
    [button.c, hw.c, lcd.c, leds.c]
2015-12-26 Debugging UART shit with frontend
2016-01-04 PCB stuff, not done yet
2016-01-04 Writing more stuff about PCB in documentation
2016-01-04 Removing 'help' bullet points in the PCB section
2016-01-07 Adding another paragraph to PCB section, explaining the high current/high frequency loops
2016-01-07 Verification, a quick overview, added a thing at the end about temperature
2016-01-07 Updating simulation of transients - parasitic capacitance on inductor
2016-01-08 PCB section review, writing more things in verification
2016-01-09 Reversing direction of button twist
    [button.c]
2016-01-10 Removing temperature from menu
2016-01-10 Revision on 'concept of regulation circuit'
2016-01-11 Adding power curve to 2D plto
2016-01-13 Fix power auto scale
2016-01-13 revised up to and including pcb
2016-01-13 Updating schematic with 28V instead of 36V
2016-01-14 abstract revised
    [bom.ods]
2016-01-14 bom and specs pdf
2016-01-14 schematic, lt3741 width fix in appendix
